julian-zatloukal/SAPLM/Documentacion/Informe escolar/Plantillas LaTeX/untitled-2.tex

\documentclass[12pt,onecolumn,a4paper]{report}

\usepackage[a4paper, inner=1.7cm, outer=2.7cm, top=2cm, bottom=2cm, bindingoffset=1.2cm] {geometry}
\usepackage[english]{babel}
\usepackage{blindtext}

\usepackage{microtype}
\usepackage{blindtext}
\usepackage{graphicx}
\usepackage{wrapfig}
\usepackage{enumitem}
\usepackage{fancyhdr}
\usepackage{amsmath}
\usepackage[T1]{fontenc}
\usepackage[utf8]{inputenc}
\usepackage{titlesec}
\setlength{\columnsep}{0.7cm}
\usepackage{sectsty}
\chapterfont{\centering}

\title{\Large{\textbf{SAMPL}}}
\author{By Zatloukal, Maule}
\date{July 22, 2019}

\begin{document}

\maketitle

\tableofcontents

\section{First section}
\subsection{A subsection}
\blindtext[1]

\appendix
\section*{Appendices}
\addcontentsline{toc}{section}{Appendices}
\renewcommand{\thesubsection}{\Alph{subsection}}

\subsection{Appendix Subsection}
\subsection{Another appendix Subsection}

\end{document}
