julian-zatloukal/SAPLM/Documentacion/Informe escolar/Plantillas LaTeX/untitled-3.tex

\documentclass[12pt,onecolumn,a4paper]{report}

\usepackage[a4paper, inner=1.7cm, outer=2.7cm, top=2cm, bottom=2cm, bindingoffset=1.2cm] {geometry}
\usepackage[english]{babel}
\usepackage{blindtext}

\usepackage{microtype}
\usepackage{blindtext}
\usepackage{graphicx}
\usepackage{wrapfig}
\usepackage{enumitem}
\usepackage{fancyhdr}
\usepackage{amsmath}
\usepackage[T1]{fontenc}
\usepackage[utf8]{inputenc}
\usepackage{titlesec}
\setlength{\columnsep}{0.7cm}
\usepackage{sectsty}
\chapterfont{\centering}

\title{\Large{\textbf{SAMPL}}}
\author{By Zatloukal, Maule}
\date{July 22, 2019}

\begin{document}

\maketitle

\tableofcontents

\chapter{Reconocimiento de voz}

\blindtext[1]
\section{Google speech recognition API}
\blindtext[5]
\section{CMU Spinhx pocket-sphinx}
\blindtext[5]
\section{Snowboy}
\blindtext[5]
\section{Basados en redes neuronales}
\blindtext[5]

\chapter{Aplicacion SAPLM}
\blindtext[1]
\section{Flujo de información}
\blindtext[5]
\section{Interfaz grafica}
\blindtext[5]

\chapter{Printed Circuit Boards}
\blindtext[1]
\section{Diseño}
\blindtext[5]
\section{Montaje}
\blindtext[5]
\section{Prueba}
\blindtext[5]

\end{document}
