julian-zatloukal/SAPLM/Documentacion/Informe ACTE/placa_PRINCIPAL_code.pdf

...cto de placa principal\Proyecto de placa principal\main.c | 1
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
#define F_CPU | 16000000UL

#include <avr/io.h>

#include <util/delay.h>

#include <avr/interrupt.h>

#include <stdlib.h>

#include <string.h>

#include <stdbool.h>

#include <stdint.h>

#include "UART_Bluetooth.h" #include "nrf24.h"

void initIO();
void initRF();
char messageTest[] = "UART TESTING COMMANDS! \n";

int main(void)
{
sei(); // Interrupts on
initBluetoothUart();
initIO();
initRF();
setupReceiveMode();
while (1)
{
while(!commandAvailable);
processReceivedLine();
setupReceiveMode();
}
}

void initIO(){
/*
Input/Output pin initialization
1 : OUTPUT | 0 : INPUT | 0b76543210 Bit order
HC-05
TX | : PD0 (RX ATMEGA) | | | INPUT
RX | : PD1 (TX ATMEGA) | | | OUTPUT
KEY/ENABLE : PD2 | | | OUTPUT
STATE | : PC5 | | | INPUT
nRF24L01
CE | : PC0 | | | OUTPUT
CSN : PC1 | | | OUTPUT
MISO : PD0 (MSPIM MISO ATMEGA) | | INPUT
MOSI : PD1 (MSPIM MOSI ATMEGA) | | OUTPUT
SCK : PD4 (MSPIM XCK) | | | OUTPUT
*/
DDRD = 0b11111110;
DDRB = 0b00101001;
DDRC = 0b11011111;

...cto de placa principal\Proyecto de placa principal\main.c | 2
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
bit_clear(PORTD, BIT(2));
}

void initRF(){
uint8_t tx_address[5] = {0xE7,0xE7,0xE7,0xE7,0xE7}; uint8_t rx_address[5] = {0xD7,0xD7,0xD7,0xD7,0xD7};

nrf24_init();

/* Channel #112 , payload length: 32 */ nrf24_config(112,32);

/* Set the device addresses */ nrf24_tx_address(tx_address); nrf24_rx_address(rx_address); }

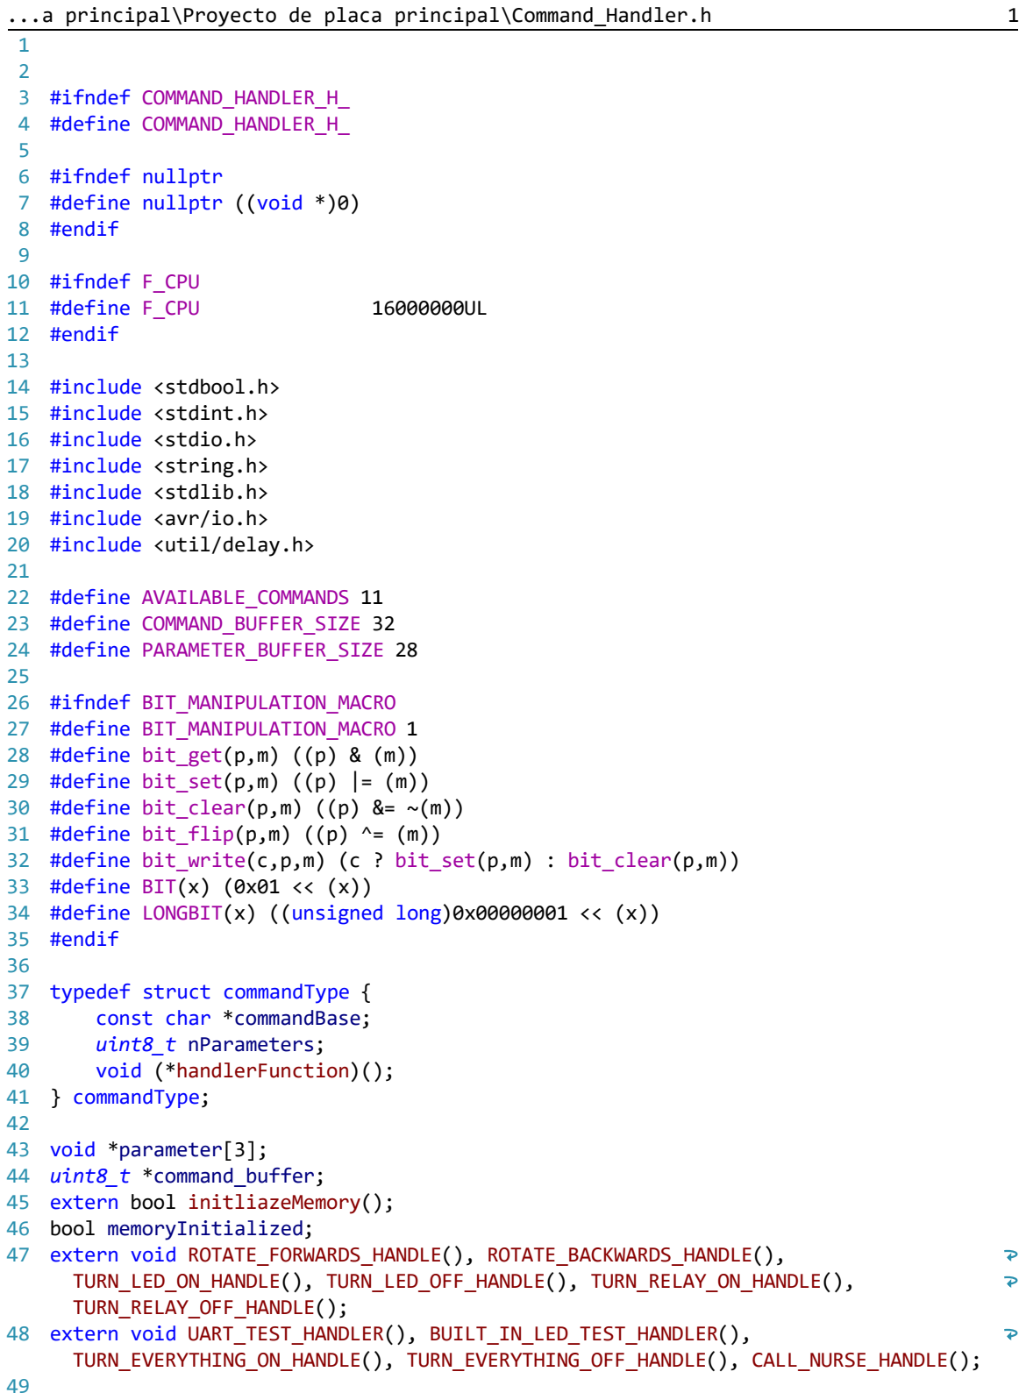
[picture p2: figure]
...a principal\Proyecto de placa principal\Command_Handler.h; #ifndef COMMAND_HANDLER_H_ #define COMMAND_HANDLER_H_; #ifndef nullptr #define nullptr ((void *)0) #endif; #ifndef F_CPU; #define F_CPU; #endif; #include <stdbool.h> #include <stdint.h> #include <stdio.h> #include <string.h> #include <stdlib.h> #include <avr/io.h> #include <util/delay.h>; #define AVAILABLE_COMMANDS 11 #define COMMAND_BUFFER_SIZE 32 #define PARAMETER_BUFFER_SIZE 28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

#define bit_write(c,p,m) (c ? bit_set(p,m) : bit_clear(p,m))

#define LONGBIT(x) ((unsigned long)0x00000001 << (x))

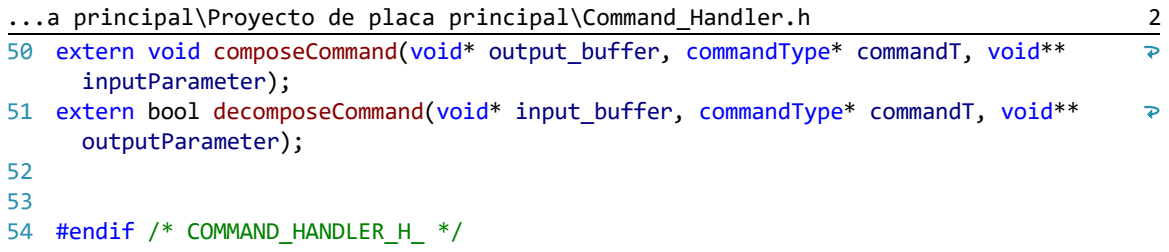
[picture p3: figure]
...a principal\Proyecto de placa principal\Command_Handler.h; inputParameter);; outputParameter);; #endif /* COMMAND_HANDLER_H_ */

extern void composeCommand(void* output_buffer, commandType* commandT, void**

extern bool decomposeCommand(void* input_buffer, commandType* commandT, void**

... principal\Proyecto de placa principal\Command_Handler..c | 1
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
#include "Command_Handler.h" #include "UART_Bluetooth.h"

#include "nrf24.h"

const commandType availableCommand[AVAILABLE_COMMANDS] = {
{ .commandBase = "ROTATE_FORWARDS", .nParameters = 3, .handlerFunction = &ROTATE_FORWARDS_HANDLE},
{ .commandBase = "ROTATE_BACKWARDS", .nParameters = 1, .handlerFunction = &ROTATE_BACKWARDS_HANDLE},
{ .commandBase = "TURN_LED_ON", .nParameters = 1, .handlerFunction = &TURN_LED_ON_HANDLE},
{ .commandBase = "TURN_LED_OFF", .nParameters = 1, .handlerFunction = &TURN_LED_OFF_HANDLE},
{ .commandBase = "TURN_RELAY_ON", .nParameters = 1, .handlerFunction = &TURN_RELAY_ON_HANDLE},
{ .commandBase = "TURN_RELAY_OFF", .nParameters = 1, .handlerFunction = &TURN_RELAY_OFF_HANDLE},
{ .commandBase = "UART_TEST", .nParameters = 0, .handlerFunction = &UART_TEST_HANDLER},
{ .commandBase = "BUILT_IN_LED_TEST", .nParameters = 0, .handlerFunction = &BUILT_IN_LED_TEST_HANDLER},
{ .commandBase = "TURN_EVERYTHING_ON", .nParameters = 0, .handlerFunction = &TURN_EVERYTHING_ON_HANDLE},
{ .commandBase = "TURN_EVERYTHING_OFF", .nParameters = 0, .handlerFunction = &TURN_EVERYTHING_OFF_HANDLE},
{ .commandBase = "CALL_NURSE", .nParameters = 0, .handlerFunction = &CALL_NURSE_HANDLE}
};

bool initliazeMemory(){
if(memoryInitialized) return false; parameter[0] = (void*)calloc(28,1); parameter[1] = (void*)calloc(28,1);
parameter[2] = (void*)calloc(28,1);
command_buffer = (uint8_t*)calloc(32,1); if(parameter[0]==nullptr||parameter[1]==nullptr||parameter[2]==nullptr|| command_buffer==nullptr) return false;
memoryInitialized = true;
return true;
}

void composeCommand(void* output_buffer, commandType* commandT, void** inputParameter){
strcpy(output_buffer, commandT->commandBase);
char* startParamPTR = (char*)(output_buffer+strlen(commandT->commandBase)); char* endParamPTR = (char*)(startParamPTR+1+strlen(*inputParameter));

for (uint8_t index = 0; index < commandT->nParameters; index++){ *startParamPTR='[';

... principal\Proyecto de placa principal\Command_Handler..c | 2
strcpy(startParamPTR+1, *inputParameter); *endParamPTR=']';
startParamPTR=(endParamPTR+1);
if (index!=(commandT->nParameters-1)){ inputParameter++;
uint8_t len = strlen(*inputParameter); endParamPTR = (char*)(startParamPTR+len+1); }
}
*startParamPTR='\0';
}

bool decomposeCommand(void* input_buffer, commandType* commandT, void** outputParameter){

for (uint8_t index = 0; index < AVAILABLE_COMMANDS; index++){
if (memmem(input_buffer, COMMAND_BUFFER_SIZE, availableCommand [index].commandBase, strlen(availableCommand[index].commandBase))! =nullptr)
{
*commandT = availableCommand[index]; break;
}
else if (index==(AVAILABLE_COMMANDS-1)) { return false;}
}

for (uint8_t x = 0; x < commandT->nParameters; x++){
uint8_t* startNumPTR = memchr(input_buffer, '[', COMMAND_BUFFER_SIZE); uint8_t* endNumPTR = memchr(input_buffer, ']', COMMAND_BUFFER_SIZE); if (startNumPTR==nullptr||endNumPTR==nullptr) { if(x==0) return false; break; }
(*startNumPTR) = 0x20;
(*endNumPTR) = 0x20;
startNumPTR++;
uint32_t bytes = ((endNumPTR)) ((startNumPTR)); if (bytes>PARAMETER_BUFFER_SIZE) return false; memcpy(outputParameter[x], startNumPTR, bytes); }

return true;
}

void ROTATE_FORWARDS_HANDLE() {}

void ROTATE_BACKWARDS_HANDLE() {}

void TURN_LED_ON_HANDLE() {}

void TURN_LED_OFF_HANDLE() {}

void TURN_RELAY_ON_HANDLE() {
composeCommand(command_buffer, &availableCommand[4], parameter);

... principal\Proyecto de placa principal\Command_Handler..c | 3
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
nrf24_send(command_buffer);
while(nrf24_isSending());

uint8_t messageStatus = nrf24_lastMessageStatus();
if(messageStatus == NRF24_TRANSMISSON_OK) { transmitMessageSync("Successful RF transmission! \n", 29); }
else if(messageStatus == NRF24_MESSAGE_LOST) { transmitMessageSync("Failure on RF transmission! \n", 29); }

uint8_t retransmissionCount = nrf24_retransmissionCount();
char* retransmissionString = malloc(32);
sprintf(retransmissionString, "Retransmission count: %d \n", retransmissionCount);
transmitMessageSync(retransmissionString, strlen(retransmissionString)); free(retransmissionString);
}

void TURN_RELAY_OFF_HANDLE() {
composeCommand(command_buffer, &availableCommand[5], parameter);

nrf24_send(command_buffer);
while(nrf24_isSending());

uint8_t messageStatus = nrf24_lastMessageStatus();
if(messageStatus == NRF24_TRANSMISSON_OK) { transmitMessageSync("Successful RF transmission! \n", 29); }
else if(messageStatus == NRF24_MESSAGE_LOST) { transmitMessageSync("Failure on RF transmission! \n", 29); }

uint8_t retransmissionCount = nrf24_retransmissionCount();
char* retransmissionString = malloc(32);
sprintf(retransmissionString, "Retransmission count: %d \n", retransmissionCount);
transmitMessageSync(retransmissionString, strlen(retransmissionString)); free(retransmissionString);
}

void UART_TEST_HANDLER() {
transmitMessageSync("Successful UART transmission!\n", 30); }

void BUILT_IN_LED_TEST_HANDLER(){
for (uint8_t x = 0; x < 8; x++) {
bit_flip(PORTD, BIT(7));
bit_flip(PORTB, BIT(0));
_delay_ms(250);
}
bit_clear(PORTD, BIT(7));
bit_clear(PORTB, BIT(0));
}

void TURN_EVERYTHING_ON_HANDLE(){

... principal\Proyecto de placa principal\Command_Handler..c | 4
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
composeCommand(command_buffer, &availableCommand[8], parameter);

nrf24_send(command_buffer);
while(nrf24_isSending());

uint8_t messageStatus = nrf24_lastMessageStatus();
if(messageStatus == NRF24_TRANSMISSON_OK) { transmitMessageSync("Successful RF transmission! \n", 29); }
else if(messageStatus == NRF24_MESSAGE_LOST) { transmitMessageSync("Failure on RF transmission! \n", 29); }

uint8_t retransmissionCount = nrf24_retransmissionCount();
char* retransmissionString = malloc(32);
sprintf(retransmissionString, "Retransmission count: %d \n", retransmissionCount);
transmitMessageSync(retransmissionString, strlen(retransmissionString)); free(retransmissionString);
}

void TURN_EVERYTHING_OFF_HANDLE(){
composeCommand(command_buffer, &availableCommand[9], parameter);

nrf24_send(command_buffer);
while(nrf24_isSending());

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

void CALL_NURSE_HANDLE(){
composeCommand(command_buffer, &availableCommand[10], parameter);

nrf24_send(command_buffer);
while(nrf24_isSending());

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

uint8_t retransmissionCount = nrf24_retransmissionCount();

... principal\Proyecto de placa principal\Command_Handler..c | 5
178
179

180
181
182
183
184

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

...to de placa principal\Proyecto de placa principal\nrf24.h | 1
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
#ifndef NRF24

#define NRF24

#include "nRF24L01_Definitions.h" #include <stdint.h>

#define LOW 0

#define HIGH 1

#define nrf24_ADDR_LEN 5

#define nrf24_CONFIG ((1<<EN_CRC)|(0<<CRCO))

#define NRF24_TRANSMISSON_OK 0

#define NRF24_MESSAGE_LOST | 1

void | nrf24_init();
void | nrf24_rx_address(uint8_t* adr);
void | nrf24_tx_address(uint8_t* adr);
void | nrf24_config(uint8_t channel, uint8_t pay_length);

uint8_t nrf24_dataReady();
uint8_t nrf24_isSending();
uint8_t nrf24_getStatus();
uint8_t nrf24_rxFifoEmpty();
void | nrf24_send(uint8_t* value);
void | nrf24_getData(uint8_t* data);

uint8_t nrf24_payloadLength();

uint8_t nrf24_lastMessageStatus(); uint8_t nrf24_retransmissionCount();

uint8_t nrf24_payload_length();

void | nrf24_powerUpRx();
void | nrf24_powerUpTx();
void | nrf24_powerDown();

uint8_t spi_transfer(uint8_t tx);
void | nrf24_transmitSync(uint8_t* dataout,uint8_t len);
void | nrf24_transferSync(uint8_t* dataout,uint8_t* datain,uint8_t len);
void | nrf24_configRegister(uint8_t reg, uint8_t value);
void | nrf24_readRegister(uint8_t reg, uint8_t* value, uint8_t len);
void | nrf24_writeRegister(uint8_t reg, uint8_t* value, uint8_t len);

extern void nrf24_setupPins();

extern void nrf24_ce_digitalWrite(uint8_t state);

extern void nrf24_csn_digitalWrite(uint8_t state);

...to de placa principal\Proyecto de placa principal\nrf24.h | 2
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
extern void nrf24_sck_digitalWrite(uint8_t state);

extern void nrf24_mosi_digitalWrite(uint8_t state);

extern uint8_t nrf24_miso_digitalRead();

#endif

...to de placa principal\Proyecto de placa principal\nrf24.c | 1

#define UCPHA0 1

#define F_CPU 8000000UL

#define BAUD_RATE 9600UL

#define UBRR_VALUE ((F_CPU)/(2UL*BAUD_RATE))-1

#include "nrf24.h"

#include <avr/io.h>

uint8_t payload_len;

void nrf24_init()
{
nrf24_setupPins();
nrf24_ce_digitalWrite(LOW); nrf24_csn_digitalWrite(HIGH);
}

void nrf24_config(uint8_t channel, uint8_t pay_length) {
/* Use static payload length ... */
payload_len = pay_length;

// Set RF channel
nrf24_configRegister(RF_CH,channel);

// Set length of incoming payload nrf24_configRegister(RX_PW_P0, 0x00); // Auto-ACK pipe ... nrf24_configRegister(RX_PW_P1, payload_len); // Data payload pipe nrf24_configRegister(RX_PW_P2, 0x00); // Pipe not used nrf24_configRegister(RX_PW_P3, 0x00); // Pipe not used nrf24_configRegister(RX_PW_P4, 0x00); // Pipe not used nrf24_configRegister(RX_PW_P5, 0x00); // Pipe not used

// 1 Mbps, TX gain: 0dbm
nrf24_configRegister(RF_SETUP, (0<<RF_DR)|((0x03)<<RF_PWR));

// CRC enable, 1 byte CRC length nrf24_configRegister(CONFIG,nrf24_CONFIG);

// Auto Acknowledgment
nrf24_configRegister(EN_AA,(1<<ENAA_P0)|(1<<ENAA_P1)|(0<<ENAA_P2)| (0<<ENAA_P3)|(0<<ENAA_P4)|(0<<ENAA_P5));

// Enable RX addresses
nrf24_configRegister(EN_RXADDR,(1<<ERX_P0)|(1<<ERX_P1)|(0<<ERX_P2)| (0<<ERX_P3)|(0<<ERX_P4)|(0<<ERX_P5));

// Auto retransmit delay: 1000 us and Up to 15 retransmit trials nrf24_configRegister(SETUP_RETR,(0x04<<ARD)|(0x0F<<ARC));

// Dynamic length configurations: No dynamic length

...to de placa principal\Proyecto de placa principal\nrf24.c | 2
nrf24_configRegister(DYNPD,(0<<DPL_P0)|(0<<DPL_P1)|(0<<DPL_P2)|(0<<DPL_P3)| (0<<DPL_P4)|(0<<DPL_P5));

// Start listening
nrf24_powerUpRx();
}

/* Set the RX address */
void nrf24_rx_address(uint8_t * adr)
{
nrf24_ce_digitalWrite(LOW); nrf24_writeRegister(RX_ADDR_P1,adr,nrf24_ADDR_LEN); nrf24_ce_digitalWrite(HIGH);
}

/* Returns the payload length */
uint8_t nrf24_payload_length() {
return payload_len;
}

/* Set the TX address */
void nrf24_tx_address(uint8_t* adr)
{
/* RX_ADDR_P0 must be set to the sending addr for auto ack to work. */ nrf24_writeRegister(RX_ADDR_P0,adr,nrf24_ADDR_LEN); nrf24_writeRegister(TX_ADDR,adr,nrf24_ADDR_LEN);
}

/* Checks if data is available for reading */
/* Returns 1 if data is ready ... */
uint8_t nrf24_dataReady()
{
// See note in getData() function just checking RX_DR isn't good enough uint8_t status = nrf24_getStatus();

// We can short circuit on RX_DR, but if it's not set, we still need
// to check the FIFO for any pending packets
if ( status & (1 << RX_DR) )
{
return 1;
}

return !nrf24_rxFifoEmpty();;
}

/* Checks if receive FIFO is empty or not */ uint8_t nrf24_rxFifoEmpty()
{
uint8_t fifoStatus;

nrf24_readRegister(FIFO_STATUS,&fifoStatus,1);

...to de placa principal\Proyecto de placa principal\nrf24.c | 3

return (fifoStatus & (1 << RX_EMPTY));
}

/* Returns the length of data waiting in the RX fifo */ uint8_t nrf24_payloadLength()
{
uint8_t status;
nrf24_csn_digitalWrite(LOW); spi_transfer(R_RX_PL_WID); status = spi_transfer(0x00); nrf24_csn_digitalWrite(HIGH);
return status;
}

/* Reads payload bytes into data array */ void nrf24_getData(uint8_t* data)
{
/* Pull down chip select */ nrf24_csn_digitalWrite(LOW);

/* Send cmd to read rx payload */ spi_transfer( R_RX_PAYLOAD );

/* Read payload */
nrf24_transferSync(data,data,payload_len);

/* Pull up chip select */
nrf24_csn_digitalWrite(HIGH);

/* Reset status register */ nrf24_configRegister(STATUS,(1<<RX_DR));
}

/* Returns the number of retransmissions occured for the last message */ uint8_t nrf24_retransmissionCount()
{
uint8_t rv;
nrf24_readRegister(OBSERVE_TX,&rv,1); rv = rv & 0x0F;
return rv;
}

// Sends a data package to the default address. Be sure to send the correct // amount of bytes as configured as payload on the receiver.
void nrf24_send(uint8_t* value)
{
/* Go to Standby-I first */ nrf24_ce_digitalWrite(LOW);

/* Set to transmitter mode , Power up if needed */ nrf24_powerUpTx();

...to de placa principal\Proyecto de placa principal\nrf24.c | 4

/* Do we really need to flush TX fifo each time ? */ #if 1
/* Pull down chip select */ nrf24_csn_digitalWrite(LOW);

/* Write cmd to flush transmit FIFO */ spi_transfer(FLUSH_TX);

/* Pull up chip select */
nrf24_csn_digitalWrite(HIGH);
#endif

/* Pull down chip select */ nrf24_csn_digitalWrite(LOW);

/* Write cmd to write payload */ spi_transfer(W_TX_PAYLOAD);

/* Write payload */
nrf24_transmitSync(value,payload_len);

/* Pull up chip select */
nrf24_csn_digitalWrite(HIGH);

/* Start the transmission */ nrf24_ce_digitalWrite(HIGH); }

uint8_t nrf24_isSending()
{
uint8_t status;

/* read the current status */
status = nrf24_getStatus();

/* if sending successful (TX_DS) or max retries exceded (MAX_RT). */
if((status & ((1 << TX_DS) | (1 << MAX_RT))))
{
return 0; /* false */
}

return 1; /* true */

}

uint8_t nrf24_getStatus()
{
uint8_t rv;
nrf24_csn_digitalWrite(LOW); rv = spi_transfer(NOP);
nrf24_csn_digitalWrite(HIGH);

...to de placa principal\Proyecto de placa principal\nrf24.c | 5
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
return rv;
}

uint8_t nrf24_lastMessageStatus() {
uint8_t rv;

rv = nrf24_getStatus();

/* Transmission went OK */ if((rv & ((1 << TX_DS))))
{
return NRF24_TRANSMISSON_OK;
}
/* Maximum retransmission count is reached */ /* Last message probably went missing ... */ else if((rv & ((1 << MAX_RT))))
{
return NRF24_MESSAGE_LOST;
}
/* Probably still sending ... */ else
{
return 0xFF;
}
}

void nrf24_powerUpRx()
{
nrf24_csn_digitalWrite(LOW);
spi_transfer(FLUSH_RX);
nrf24_csn_digitalWrite(HIGH);

nrf24_configRegister(STATUS,(1<<RX_DR)|(1<<TX_DS)|(1<<MAX_RT));

nrf24_ce_digitalWrite(LOW); nrf24_configRegister(CONFIG,nrf24_CONFIG|((1<<PWR_UP)|(1<<PRIM_RX))); nrf24_ce_digitalWrite(HIGH);
}

void nrf24_powerUpTx()
{
nrf24_configRegister(STATUS,(1<<RX_DR)|(1<<TX_DS)|(1<<MAX_RT));

nrf24_configRegister(CONFIG,nrf24_CONFIG|((1<<PWR_UP)|(0<<PRIM_RX))); }

void nrf24_powerDown()
{
nrf24_ce_digitalWrite(LOW); nrf24_configRegister(CONFIG,nrf24_CONFIG); }

...to de placa principal\Proyecto de placa principal\nrf24.c | 6

uint8_t spi_transfer(uint8_t tx)
{
uint8_t i = 0;
uint8_t rx = 0;

nrf24_sck_digitalWrite(LOW);

for(i=0;i<8;i++)
{

if(tx & (1<<(7-i)))
{
nrf24_mosi_digitalWrite(HIGH); }
else
{
nrf24_mosi_digitalWrite(LOW); }

nrf24_sck_digitalWrite(HIGH);

rx = rx << 1;
if(nrf24_miso_digitalRead()) {
rx |= 0x01;
}

nrf24_sck_digitalWrite(LOW);

}

return rx;
}

/* send and receive multiple bytes over SPI */
void nrf24_transferSync(uint8_t* dataout,uint8_t* datain,uint8_t len) {
uint8_t i;

for(i=0;i<len;i++)
{
datain[i] = spi_transfer(dataout[i]); }

}

/* send multiple bytes over SPI */
void nrf24_transmitSync(uint8_t* dataout,uint8_t len) {
uint8_t i;

...to de placa principal\Proyecto de placa principal\nrf24.c | 7
for(i=0;i<len;i++)
{
spi_transfer(dataout[i]);
}

}

/* Clocks only one byte into the given nrf24 register */ void nrf24_configRegister(uint8_t reg, uint8_t value)
{
nrf24_csn_digitalWrite(LOW);
spi_transfer(W_REGISTER | (REGISTER_MASK & reg));
spi_transfer(value);
nrf24_csn_digitalWrite(HIGH);
}

/* Read single register from nrf24 */
void nrf24_readRegister(uint8_t reg, uint8_t* value, uint8_t len) {
nrf24_csn_digitalWrite(LOW);
spi_transfer(R_REGISTER | (REGISTER_MASK & reg));
nrf24_transferSync(value,value,len); nrf24_csn_digitalWrite(HIGH);
}

/* Write to a single register of nrf24 */
void nrf24_writeRegister(uint8_t reg, uint8_t* value, uint8_t len) {
nrf24_csn_digitalWrite(LOW);
spi_transfer(W_REGISTER | (REGISTER_MASK & reg));
nrf24_transmitSync(value,len); nrf24_csn_digitalWrite(HIGH);
}

#define RF_DDR DDRC

#define RF_PORT PORTC

#define RF_PIN PINC

#define set_bit(reg,bit) reg |= (1<<bit)

#define clr_bit(reg,bit) reg &= ~(1<<bit)

#define check_bit(reg,bit) (reg&(1<<bit))

/* */

void nrf24_setupPins()
{
set_bit(RF_DDR,0); // CE output
set_bit(RF_DDR,1); // CSN output set_bit(RF_DDR,2); // SCK output set_bit(RF_DDR,3); // MOSI output clr_bit(RF_DDR,4); // MISO input }

...to de placa principal\Proyecto de placa principal\nrf24.c | 8
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
/* */ void nrf24_ce_digitalWrite(uint8_t state)
{
if(state)
{
set_bit(RF_PORT,0);
}
else
{
clr_bit(RF_PORT,0);
}
}
/* */ void nrf24_csn_digitalWrite(uint8_t state)
{
if(state)
{
set_bit(RF_PORT,1);
}
else
{
clr_bit(RF_PORT,1);
}
}
/* */ void nrf24_sck_digitalWrite(uint8_t state)
{
if(state)
{
set_bit(RF_PORT,2);
}
else
{
clr_bit(RF_PORT,2);
}
}
/* */ void nrf24_mosi_digitalWrite(uint8_t state)
{
if(state)
{
set_bit(RF_PORT,3);
}
else
{
clr_bit(RF_PORT,3);
}
}
/* */ uint8_t nrf24_miso_digitalRead()
{
return check_bit(RF_PIN,4);

...to de placa principal\Proyecto de placa principal\nrf24.c | 9
414
415
416

}
/* */

...ca principal\Proyecto de placa principal\UART_Bluetooth.h | 1
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
#ifndef UART_BLUETOOTH_H_

#define UART_BLUETOOTH_H_

#include <stdbool.h>

#include <stdint.h>

#ifndef F_CPU

#define F_CPU | 16000000UL

#endif

#ifndef BAUD

#define BAUD | 9600

#endif

#ifndef BRC

#define BRC | F_CPU/8/BAUD-1

#endif

#ifndef nullptr

#define nullptr | nullptr ((void*)0)

#endif

#define uartBufferSize | 32

#define uartEndMsgChar | '$'

#define uartCarriageReturnChar '/'

#ifndef BIT_MANIPULATION_MACRO #define BIT_MANIPULATION_MACRO 1 #define bit_get(p,m) ((p) & (m)) #define bit_set(p,m) ((p) |= (m))

#define bit_clear(p,m) ((p) &= ~(m))

#define bit_flip(p,m) ((p) ^= (m))

#define bit_write(c,p,m) (c ? bit_set(p,m) : bit_clear(p,m)) #define BIT(x) (0x01 << (x))

#define LONGBIT(x) ((unsigned long)0x00000001 << (x)) #endif

extern bool commandAvailable;

extern void initBluetoothUart();
extern void transmitMessage(uint8_t* message, uint8_t length); extern void transmitMessageSync(uint8_t* message, uint8_t length); extern bool transmissionState();
extern void setupReceiveMode();
extern void processReceivedLine();
extern void disableUART();

...ca principal\Proyecto de placa principal\UART_Bluetooth.h | 2
53
54 #endif /* UART_BLUETOOTH_H_ */

...ca principal\Proyecto de placa principal\UART_Bluetooth.c | 1

#include "UART_Bluetooth.h"

#include <avr/io.h>

#include <avr/interrupt.h> #include "Command_Handler.h" #include <stdlib.h>

#include <string.h>

uint8_t* uartBufferPos;
uint8_t* uartTxMessageEnd;
bool commandAvailable;

void initBluetoothUart(){
// UART Initialization : 8-bit : No parity bit : 1 stop bit
UBRR0H = (BRC >> 8); UBRR0L = BRC; | // UART BAUDRATE
UCSR0A |= (1 << U2X0); | // DOUBLE UART SPEED
UCSR0C |= (1 << UCSZ01) | (1 << UCSZ00); | // 8-BIT CHARACTER SIZE

// Setup UART buffer
initliazeMemory();
uartBufferPos = command_buffer;
}

void transmitMessage(uint8_t* message, uint8_t length){ while (!(UCSR0A & (1<<UDRE0)));
uartBufferPos = command_buffer;
uartTxMessageEnd = (command_buffer+length); memcpy(command_buffer, message, length);
UCSR0A |= (1<<TXC0) | (1<<RXC0);
UCSR0B |= (1<<TXEN0) | (1<<TXCIE0);
UCSR0B &=~(1<<RXEN0) &~(1<<RXCIE0);

uartBufferPos++;
UDR0 = *(command_buffer);
}

void transmitMessageSync(uint8_t* message, uint8_t length){ while (!(UCSR0A & (1<<UDRE0)));
uartBufferPos = command_buffer;
uartTxMessageEnd = (command_buffer+length); memcpy(command_buffer, message, length);
UCSR0A |= (1<<TXC0) | (1<<RXC0);
UCSR0B |= (1<<TXEN0) | (1<<TXCIE0);
UCSR0B &=~(1<<RXEN0) &~(1<<RXCIE0);

uartBufferPos++;
UDR0 = *(command_buffer);

while (transmissionState());

}

...ca principal\Proyecto de placa principal\UART_Bluetooth.c | 2
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
bool transmissionState(){
// True : Currently transmitting | False : Transmission finished
if (uartBufferPos!=uartTxMessageEnd)
{
return true;
}
else
{
return false;
}
}

void setupReceiveMode(){
while (!(UCSR0A & (1<<UDRE0))); uartBufferPos = command_buffer;
UCSR0A |= (1<<RXC0) | (1<<TXC0);
UCSR0B &=~(1<<TXEN0) &~(1<<TXCIE0);
UCSR0B |= (1<<RXEN0) | (1<<RXCIE0);
}

void processReceivedLine(){
commandAvailable = false;

commandType currentCommand;
bool success = decomposeCommand(command_buffer, &currentCommand, parameter); if(success) currentCommand.handlerFunction();
}

void disableUART(){
UCSR0B &=~(1<<TXEN0) &~(1<<TXCIE0);
UCSR0B &=~(1<<RXEN0) &~(1<<RXCIE0); }

ISR(USART_TX_vect){
if (uartBufferPos!=uartTxMessageEnd){ UDR0 = *uartBufferPos;
uartBufferPos++;
}
}

ISR(USART_RX_vect){
if(uartBufferPos!=(command_buffer+uartBufferSize)) { *uartBufferPos=UDR0;
if (*uartBufferPos!=uartEndMsgChar) { if(*uartBufferPos!=uartCarriageReturnChar) {uartBufferPos++;} else { uartBufferPos = command_buffer; }
}
else { disableUART(); commandAvailable = true; }
} else {uartBufferPos = command_buffer;}

...ca principal\Proyecto de placa principal\UART_Bluetooth.c | 3
104 | }
