julian-zatloukal/SAPLM/Documentacion/Informe ACTE/NUEVO CODIGO/CARATULAS.pdf

Codigo de fuente: Aplicación, todas las clases internas
Lenguaje: JAVA 8 SE
IDE: Android Studio

Codigo de fuente: Aplicación, diseño de layout
Lenguaje: XML
IDE: Android Studio

PLACA PRINCIPAL
> Esquematico
> Board

PLACA DE POTENCIA
> Esquematico
> Board

PLACA MOTRIZ
> Esquematico
> Board
