julian-zatloukal/SAPLM/Documentacion/Informe ACTE/NUEVO CODIGO/POTENCIA.pdf

PLACA DE POTENCIA
> Esquematico
> Board
