julian-zatloukal/SAPLM/Proyecto atmel studio/Notas/NEW_COMMAND_PROTOCOL.txt

	GET_BOARD_STATE[BOARD_ID]
	SET_COMMAND_VALUE[CMD_ID][VALUE]
	GET_COMMAND_VALUE[CMD_ID]

	UPDATE_COMMAND_VALUE[CMD_ID][VALUE]

	START OF TRANSMISSION BLOCK	:	0x01

	COMMAND CODE			:	0x??

	GROUP SEPARATOR			:	0x1D

	PARAMETER 0			:	0x??

	GROUP SEPARATOR			:	0x1D

	PARAMETER 1			:	0x??

	GROUP SEPARATOR			:	0x1D
	
	END OF TEXT			:	0x02

	CRC-8 CHECKSUM BYTE		:	0x??

	END OF TRANSMISSION BLOCK	:	0x17
