julian-zatloukal/SAPLM/Documentacion/Informe ACTE/DIAGRAMA_DE_BLOQUES.pdf

# Diagrama de bloques

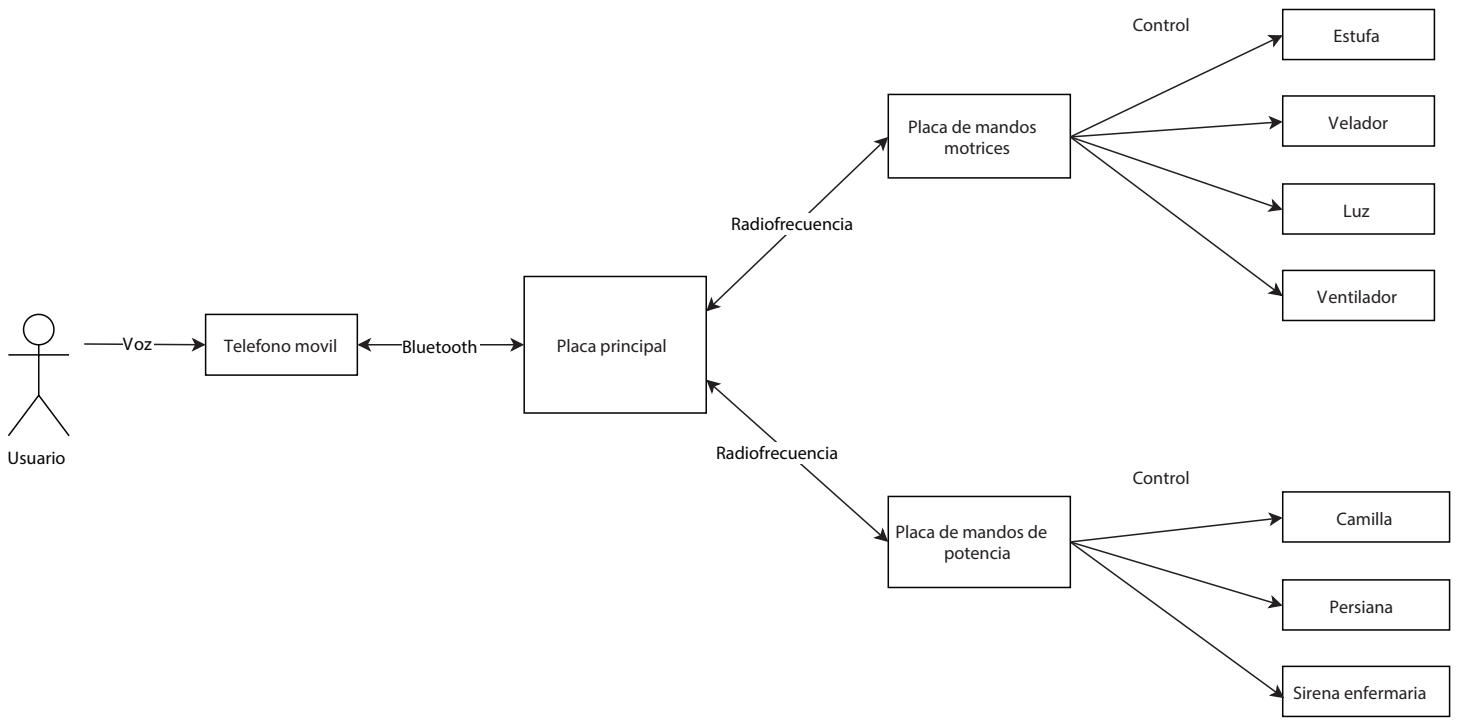
[picture p11: figure]
Usuario; Voz; Telefono movil; Bluetooth; Placa principal; Placa de mandos motrices; Placa de mandos de potencia; Estufa; Velador; Luz; Ventilador; Camilla; Persiana; Sirena enfermaria; Radiofrecuencia; Control
