julian-zatloukal/SAPLM/Documentacion/Informe ACTE/DIAGRAMA_DE_FLUJO.pdf

# Diagrama de flujo para encender una estufa

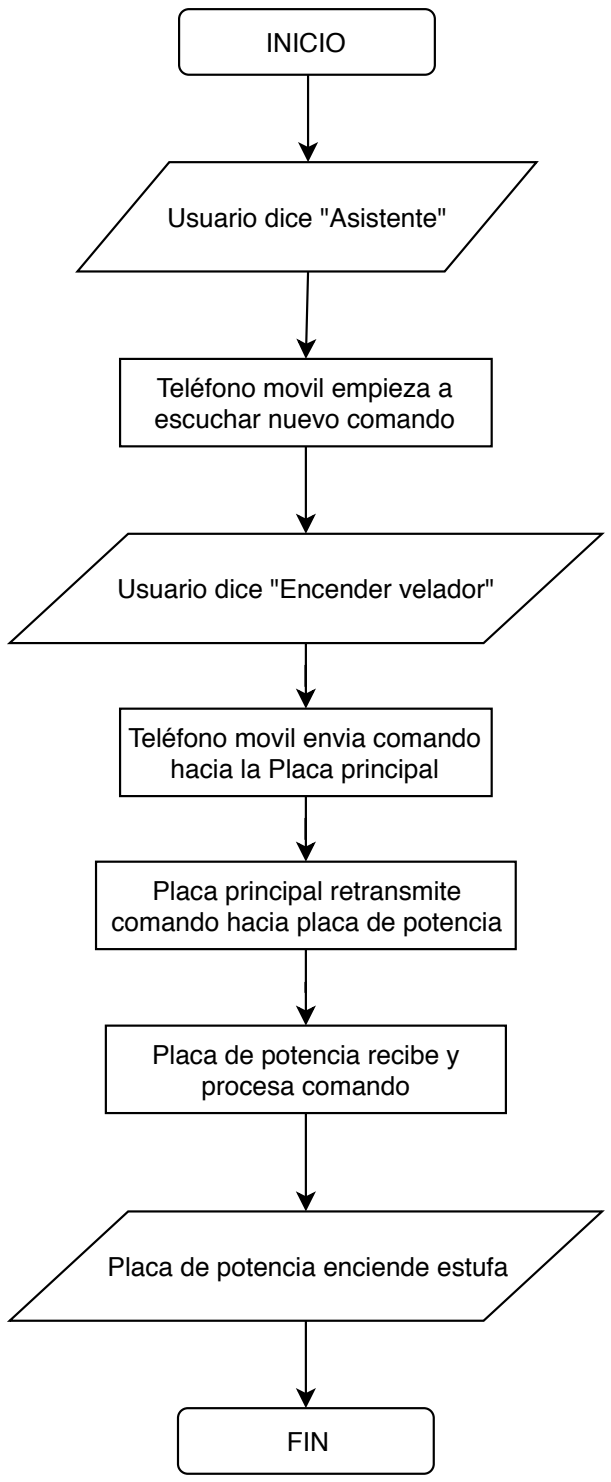
[picture p12: figure]
INICIO; Usuario dice "Asistente"; Teléfono movil empieza a escuchar nuevo comando; Usuario dice "Encender velador"; Teléfono movil envia comando hacia la Placa principal; Placa principal retransmite comando hacia placa de potencia; Placa de potencia recibe y procesa comando; Placa de potencia enciende estufa; FIN
