julian-zatloukal/SAPLM/Documentacion/Informe ACTE/paginas extra.pdf

- Palabra clave : Asistente Comandos disponibles

Encender estufa
Encender velador
Encender ventilador

Apagar estufa
Apagar velador
Apagar ventilador
Llamar enfermería

Comandos por voz

Escuchando
comando

Escucha
deshabilitada

Escuchando
palabra clave

Estados de escucha

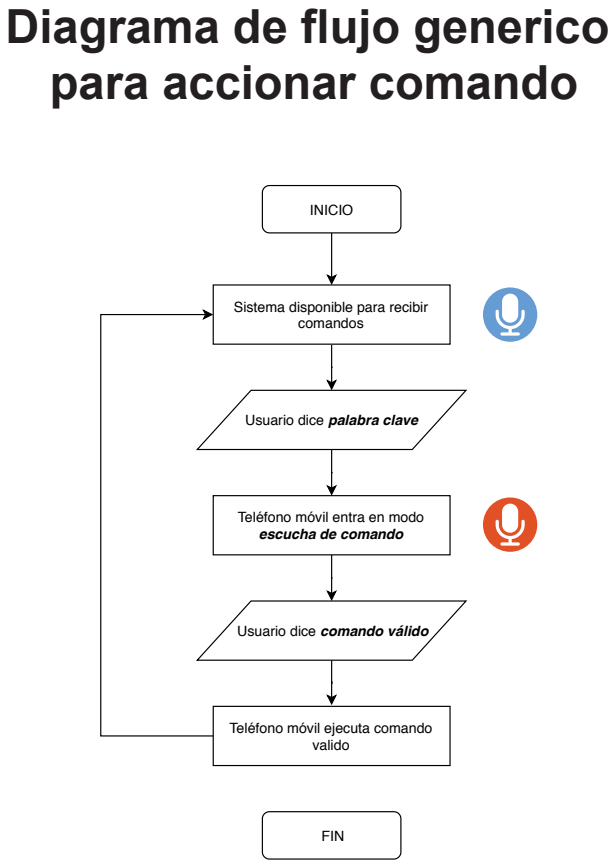
[picture p13: page 2]
INICIO; valido; FIN

Diagrama de flujo generico
para accionar comando

Sistema disponible para recibir
comandos

Usuario dice palabra clave

Teléfono móvil entra en modo
escucha de comando

Usuario dice comando válido

Teléfono móvil ejecuta comando

Interfaz gráfica de la aplicacion

- Pantalla principal

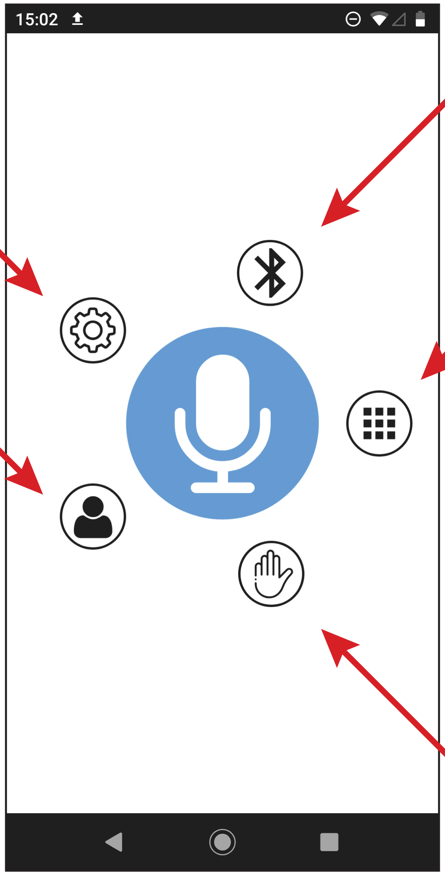
[picture p14: figure]

Menu de Bluetooth

Desplegar menu
principal

Menu de mandos

Menu de contactos

Menu de
configuraciones

Interfaz gráfica de la aplicacion

- Menu de configuraciones

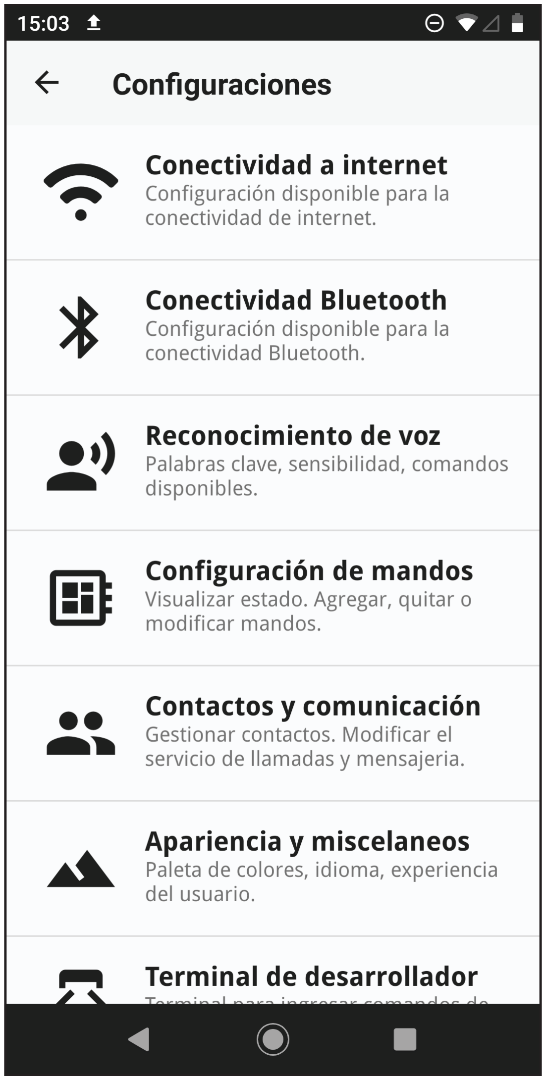
[picture p15: figure]

Interfaz gráfica de la aplicacion

- Menu de Bluetooth

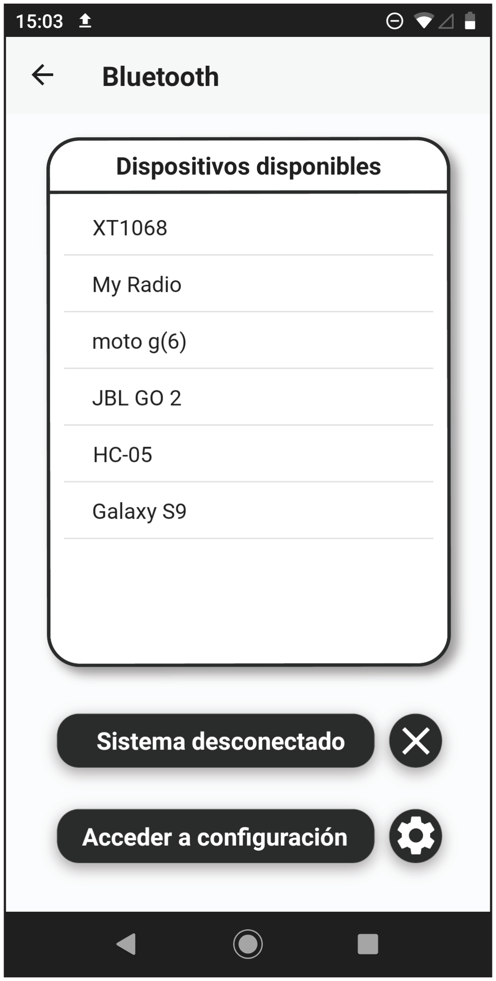
[picture p16: figure]
