julian-zatloukal/SAPLM/Documentacion/Informe ACTE/NUEVO CODIGO/JAVA.pdf

Codigo de fuente: Aplicación, todas las clases internas
Lenguaje: JAVA 8 SE
IDE: Android Studio
