julian-zatloukal/SAPLM/Documentacion/Informe ACTE/NUEVO CODIGO/XML.pdf

Codigo de fuente: Aplicación, diseño de layout
Lenguaje: XML
IDE: Android Studio
