julian-zatloukal/SAPLM/Documentacion/Informe escolar/LATEX COMPILE/APP_IMAGES.pdf

Interfaz gráfica de la aplicacion

- Pantalla principal

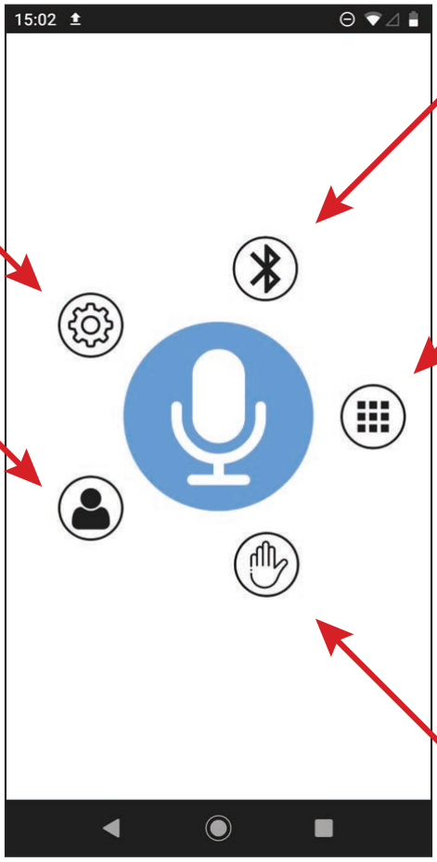
[picture p17: figure]

Menu de Bluetooth

Desplegar menu
principal

Menu de mandos

Menu de contactos

Menu de
configuraciones

Interfaz gráfica de la aplicacion

- Menu de configuraciones

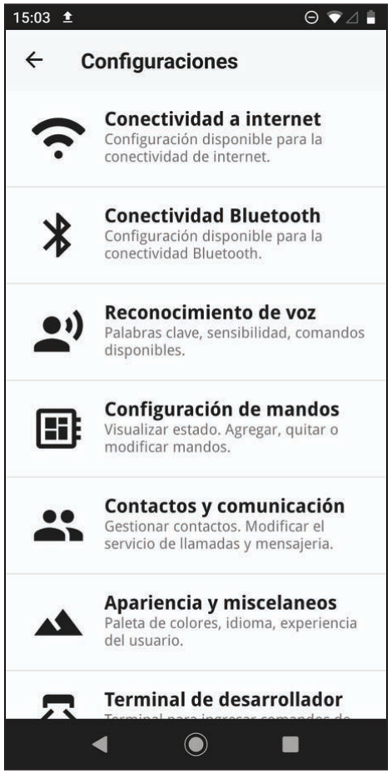
[picture p18: figure]

Interfaz gráfica de la aplicacion

- Menu de Bluetooth

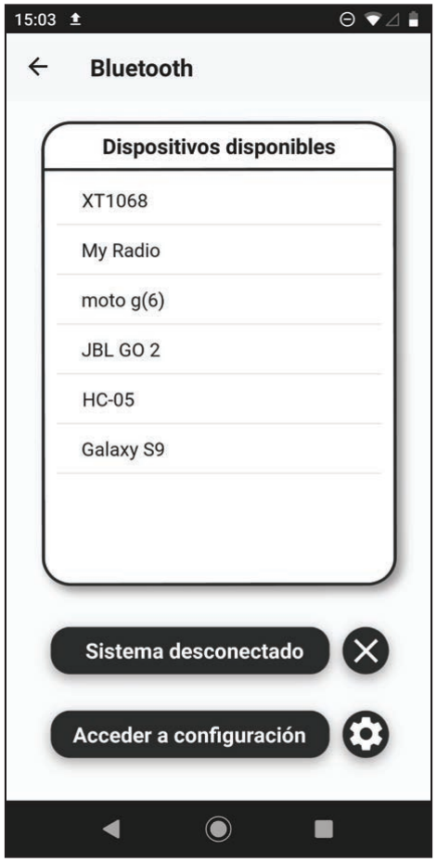
[picture p19: figure]
