julian-zatloukal/SAPLM/Documentacion/Informe escolar/Plantillas LaTeX/untitled-2.pdf

## SAMPL

### By Zatloukal, Maule

### July 22, 2019

# Contents

1 | First section | | 1
1.1 | A subsection | | 1
Appendices | | 1
A | Appendix Subsection | | 1
B | Another appendix Subsection | | 1

## 0.1 First section

### 0.1.1 A subsection

Hello, here is some text without a meaning. This text should show what a printed text will look like at this place. If you read this text, you will get no information. Really? Is there no information? Is there a difference between this text and some nonsense like “Huardest gefburn”? Kjift – not at all! A blind text like this gives you information about the selected font, how the letters are written and an impression of the look. This text should contain all letters of the alphabet and it should be written in of the original language. There is no need for special content, but the length of words should match the language.

## Appendices

### B Appendix Subsection

### C Another appendix Subsection

1
