julian-zatloukal/SAPLM/Documentacion/Informe escolar/Plantillas LaTeX/untitled-3.pdf

## SAMPL

### By Zatloukal, Maule

### July 22, 2019

# Contents

# Chapter 1

# Reconocimiento de voz

Hello, here is some text without a meaning. This text should show what a printed text will look like at this place. If you read this text, you will get no information. Really? Is there no information? Is there a difference between this text and some nonsense like “Huardest gefburn”? Kjift – not at all! A blind text like this gives you information about the selected font, how the letters are written and an impression of the look. This text should contain all letters of the alphabet and it should be written in of the original language. There is no need for special content, but the length of words should match the language.

## 1.1 Google speech recognition API

Hello, here is some text without a meaning. This text should show what a printed text will look like at this place. If you read this text, you will get no information. Really? Is there no information? Is there a difference between this text and some nonsense like “Huardest gefburn”? Kjift – not at a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

## 1.2 CMU Spinhx pocket-sphinx

Hello, here is some text without a meaning. This text should show what a printed text will look like at this place. If you read this text, you will get no information. Really? Is there no information? Is there a difference between this text and some nonsense like “Huardest gefburn”? Kjift – not at a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

## 1.3 Snowboy

Hello, here is some text without a meaning. This text should show what a printed text will look like at this place. If you read this text, you will get no information. Really? Is there no information? Is there a difference between this text and some nonsense like “Huardest gefburn”? Kjift – not at a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

## 1.4 Basados en redes neuronales

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

# Chapter 2

# Aplicacion SAPLM

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

## 2.1 Flujo de información

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

## 2.2 Interfaz grafica

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

# Chapter 3

# Printed Circuit Boards

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

## 3.1 Diseño

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

## 3.2 Montaje

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

## 3.3 Prueba

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
