julian-zatloukal/SAPLM/Documentacion/Informe ACTE/FF.jpeg

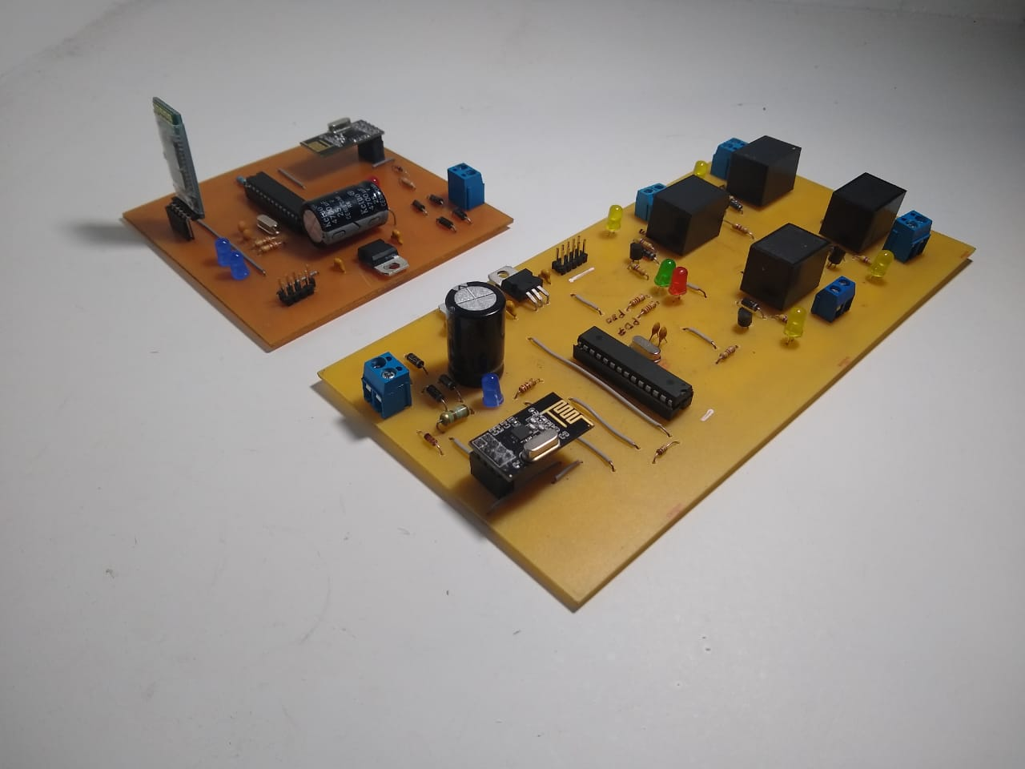
Documentacion/Informe ACTE/FF.jpeg
