julian-zatloukal/SAPLM/Documentacion/Informe ACTE/fotos app/WhatsApp Image 2019-07-04 at 15.03.50 (2).jpeg

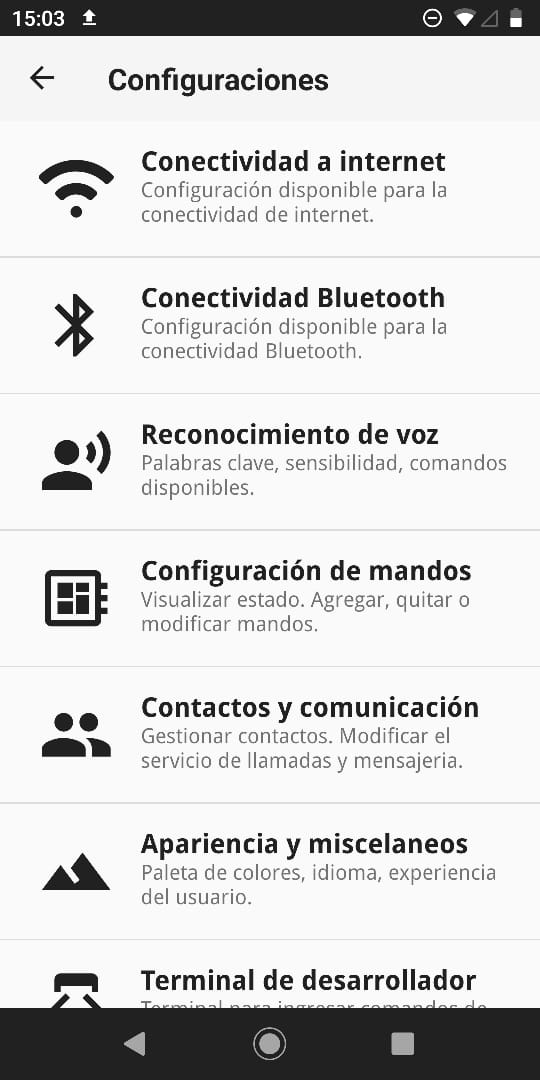
Documentacion/Informe ACTE/fotos app/WhatsApp Image 2019-07-04 at 15.03.50 (2).jpeg
