julian-zatloukal/SAPLM/Documentacion/Informe ACTE/imagen_final_2.jpg

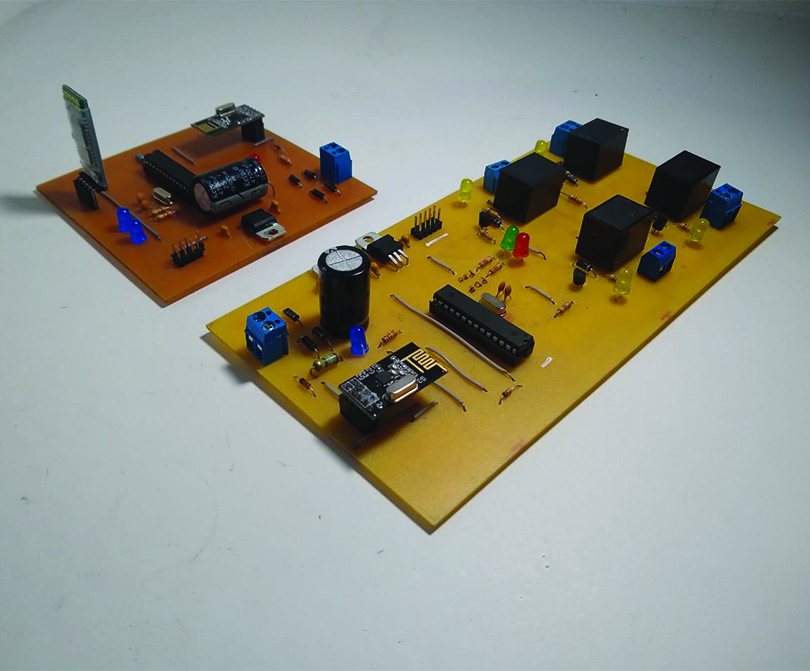
Documentacion/Informe ACTE/imagen_final_2.jpg
