julian-zatloukal/SAPLM/Proyecto atmel studio/Material/Cuadros y diagramas/Comparacion en diagramas en bloque-01.png

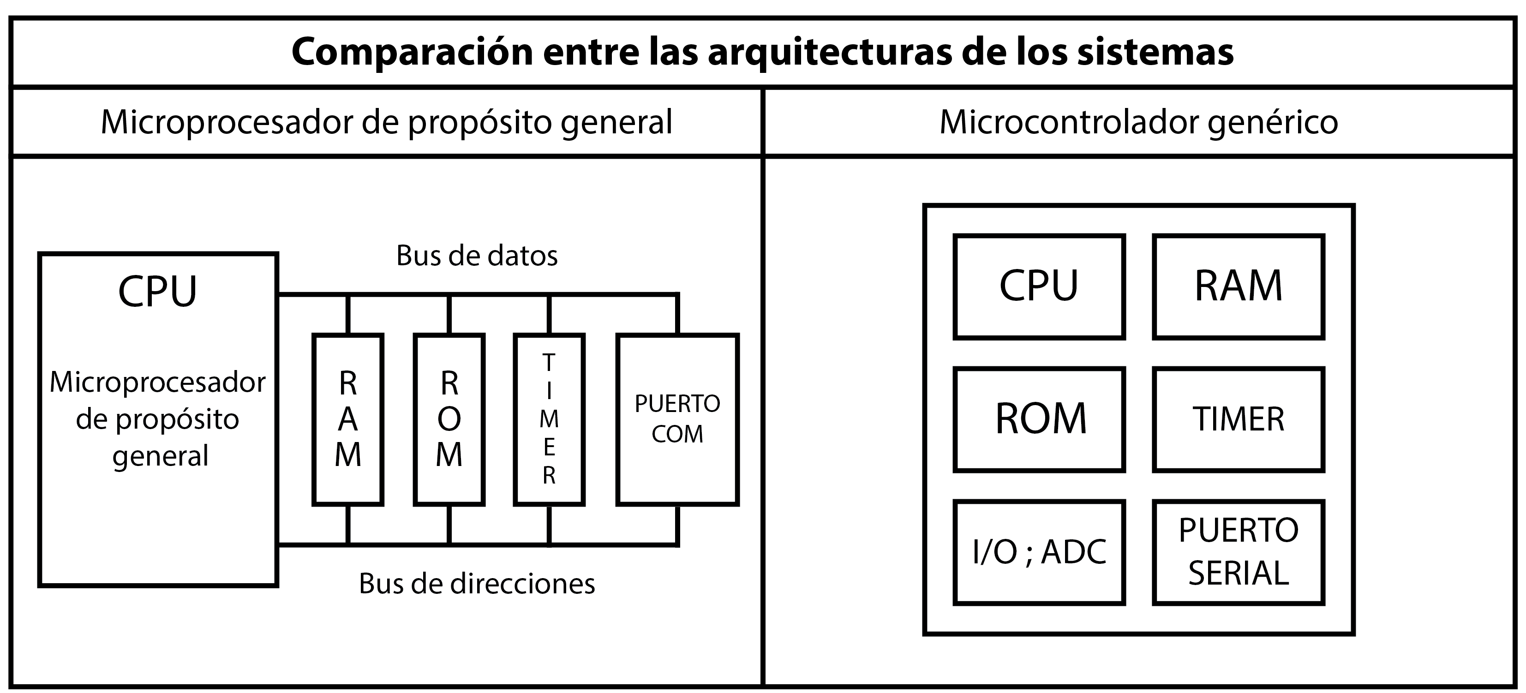
Proyecto atmel studio/Material/Cuadros y diagramas/Comparacion en diagramas en bloque-01.png
