julian-zatloukal/SAPLM/Proyecto atmel studio/Material/Cuadros y diagramas/Ejemplo de entorno de desarrollo.png

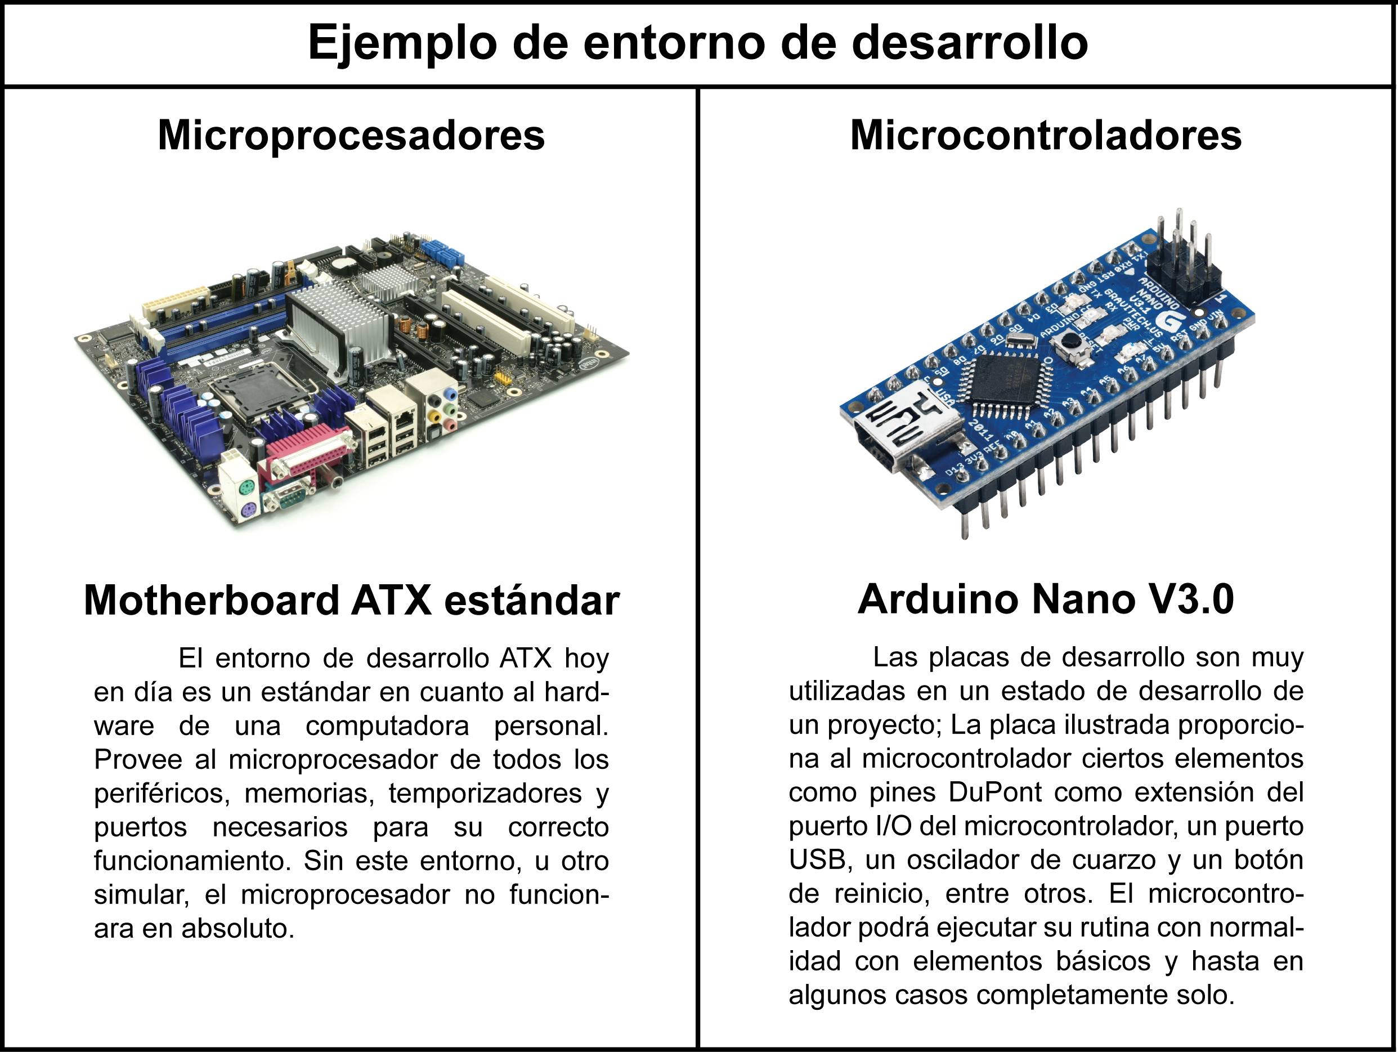
Proyecto atmel studio/Material/Cuadros y diagramas/Ejemplo de entorno de desarrollo.png
