julian-zatloukal/SAPLM/Proyecto atmel studio/Material/Cuadros y diagramas/Ejemplos de sistemas embebidos 2.png

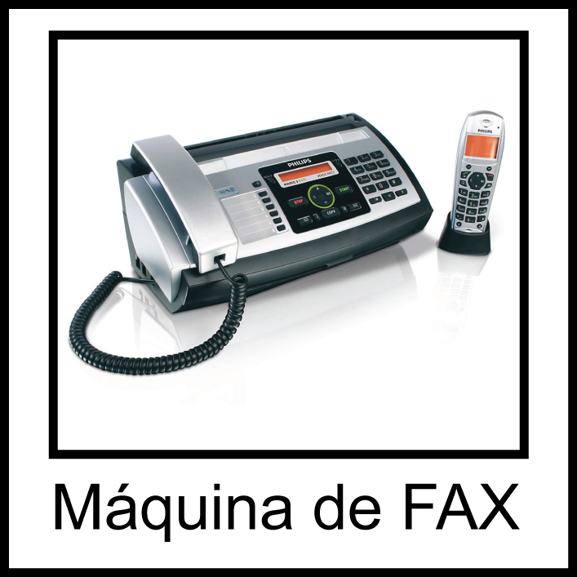
Proyecto atmel studio/Material/Cuadros y diagramas/Ejemplos de sistemas embebidos 2.png
