julian-zatloukal/SAPLM/Proyecto atmel studio/Material/Cuadros y diagramas/Ejemplos de sistemas embebidos 3.png

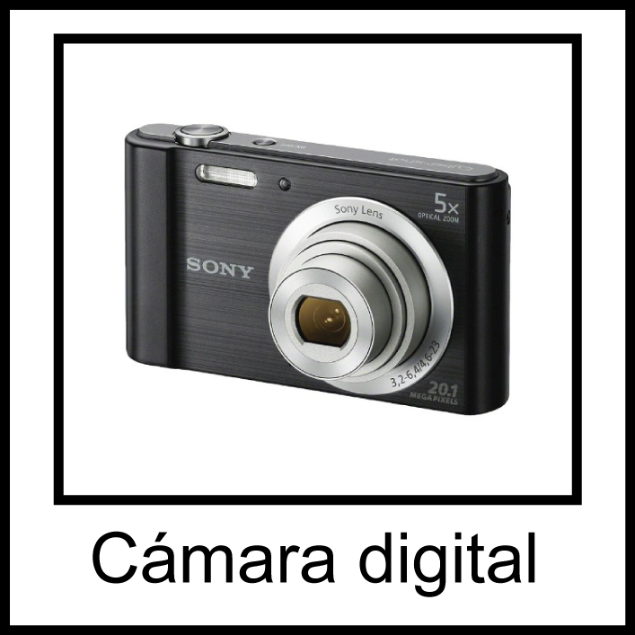
Proyecto atmel studio/Material/Cuadros y diagramas/Ejemplos de sistemas embebidos 3.png
