julian-zatloukal/SAPLM/Proyecto atmel studio/Material/Cuadros y diagramas/Ejemplos de sistemas embebidos 4.png

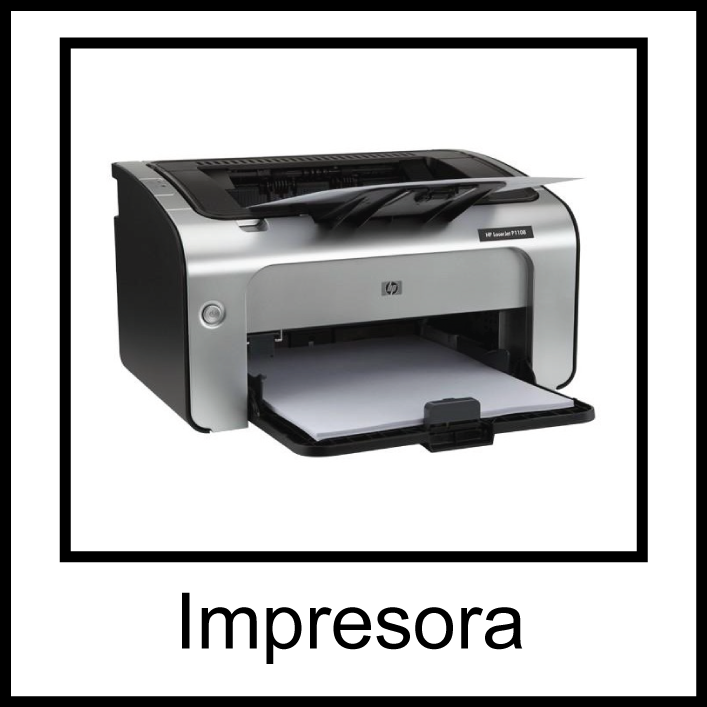
Proyecto atmel studio/Material/Cuadros y diagramas/Ejemplos de sistemas embebidos 4.png
