julian-zatloukal/SAPLM/Proyecto atmel studio/Material/Cuadros y diagramas/Ejemplos de sistemas embebidos.png

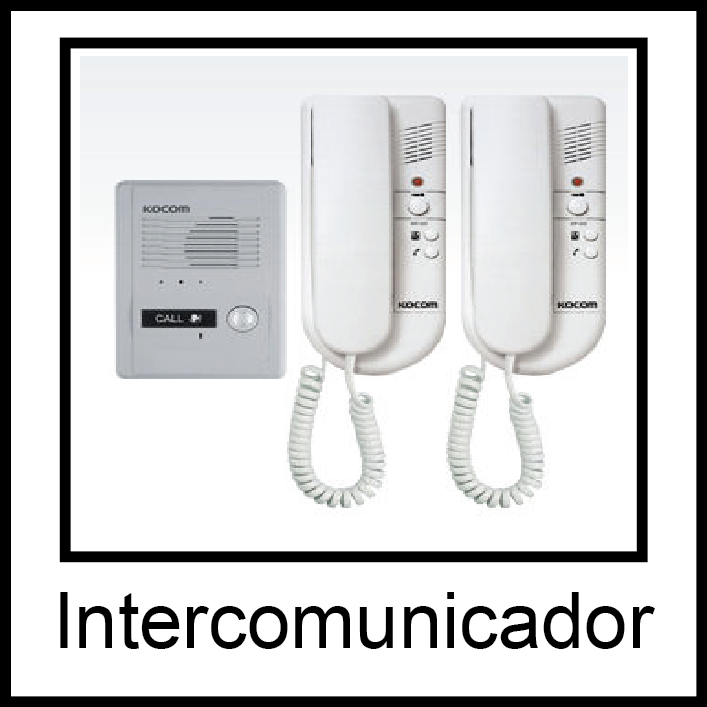
Proyecto atmel studio/Material/Cuadros y diagramas/Ejemplos de sistemas embebidos.png
