julian-zatloukal/SAPLM/Proyecto atmel studio/Material/Fotos/296.jpg

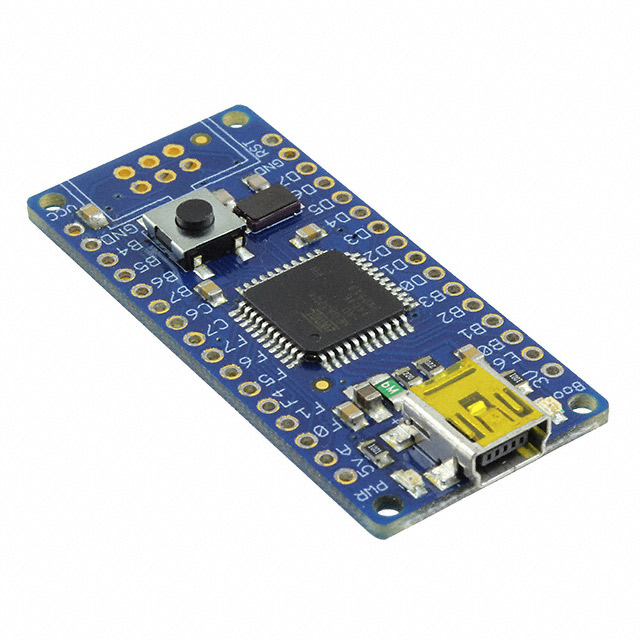
Proyecto atmel studio/Material/Fotos/296.jpg
