julian-zatloukal/SAPLM/Proyecto atmel studio/Material/Fotos/125973.jpg

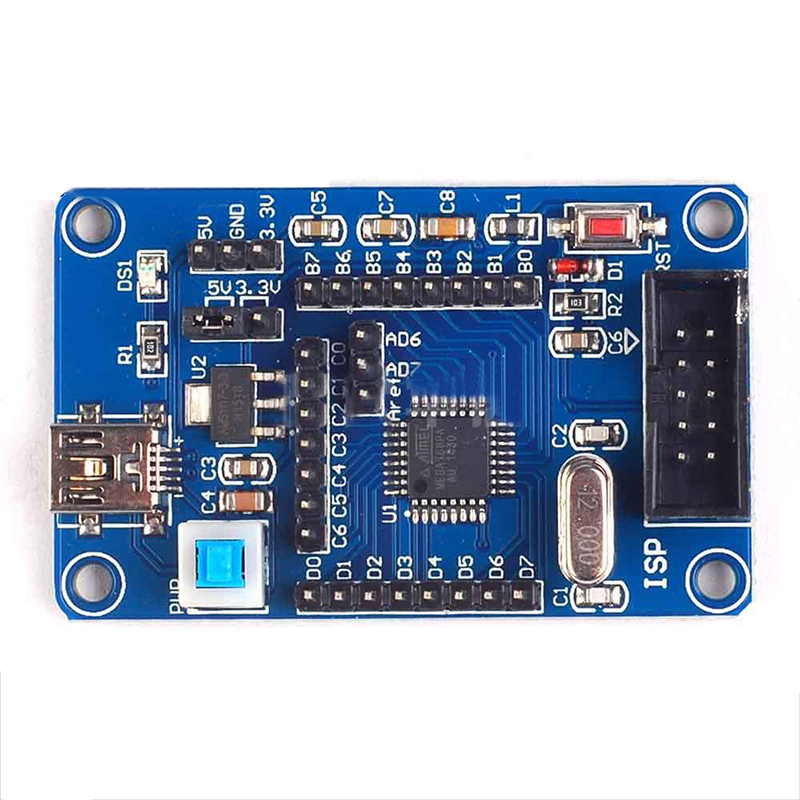
Proyecto atmel studio/Material/Fotos/125973.jpg
