julian-zatloukal/SAPLM/Proyecto atmel studio/Material/Fotos/1033804_D975XBX2KR-angle-view.png

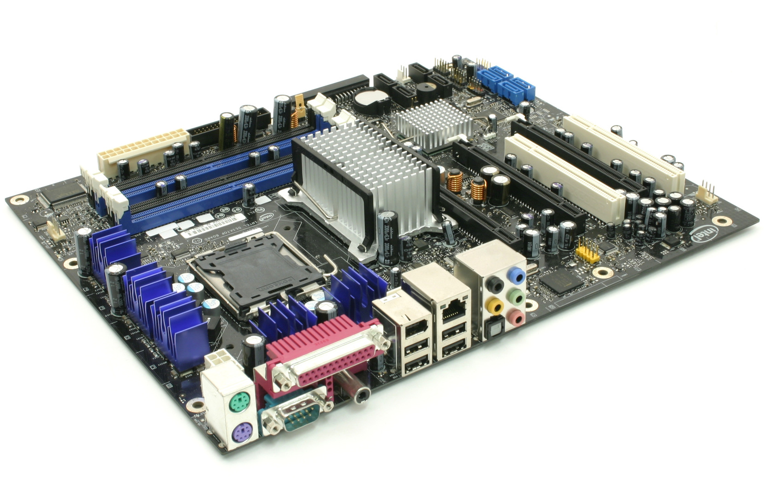
Proyecto atmel studio/Material/Fotos/1033804_D975XBX2KR-angle-view.png
