julian-zatloukal/SAPLM/Documentacion/Informe escolar/Plantillas LaTeX/prueba_IURAT.tex

\documentclass[11pt, a4paper, oneside]{article}
\usepackage{geometry}
\usepackage{lipsum}
\usepackage[spanish]{babel}

\begin{document}
\tableofcontents
\newpage

\renewcommand{\thesubsection}{\alph{subsection}}
\section{Ejercicio 1}
\subsection{Cálculo de filtro L-C}
\lipsum[1]
\subsection{Circuito de control}
\lipsum[1]
\subsection{Simulacion en Proteus VSM}
\lipsum[1]

\section{Ejercicio 2}
\subsection{Cálculo de filtro L-C}
\lipsum[1]
\subsection{Diseño de circuito de control con temporizador 555}
\lipsum[1]
\subsection{Simulación en Proteus VSM}
\lipsum[1]

\section{Ejercicio 3}
\subsection{Cálculo de filtro L-C}
\lipsum[1]
\subsection{Diseño de circuito de control con oscilador de diente de sierra y comparador}
\lipsum[1]
\subsection{Simulacion en Proteus VSM}
\lipsum[1]

\appendix
\section*{Bibliografía}
\addcontentsline{toc}{section}{Bibliografía}
\end{document}
