julian-zatloukal/SAPLM/Proyecto atmel studio/Material/Fotos/ATmega128A-AU-ATmega128-AVR-Development-Evaluation-Board-Kit-OpenM128-Standard.jpg_640x640.jpg

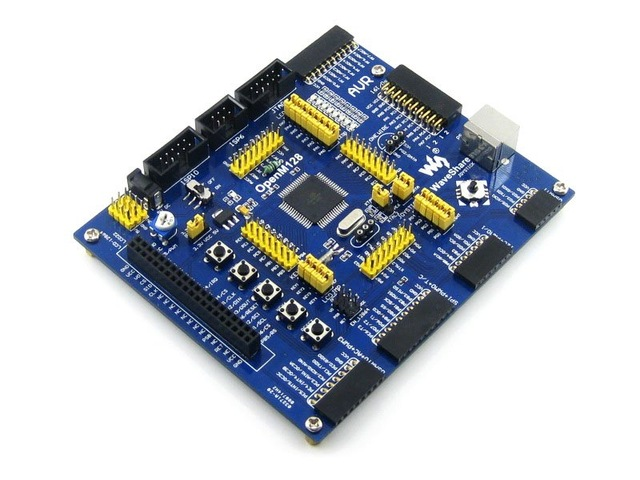
Proyecto atmel studio/Material/Fotos/ATmega128A-AU-ATmega128-AVR-Development-Evaluation-Board-Kit-OpenM128-Standard.jpg_640x640.jpg
