julian-zatloukal/SAPLM/Documentacion/Informe ACTE/NUEVO CODIGO/COMPILADO_PLACA_MOTRIZ.pdf

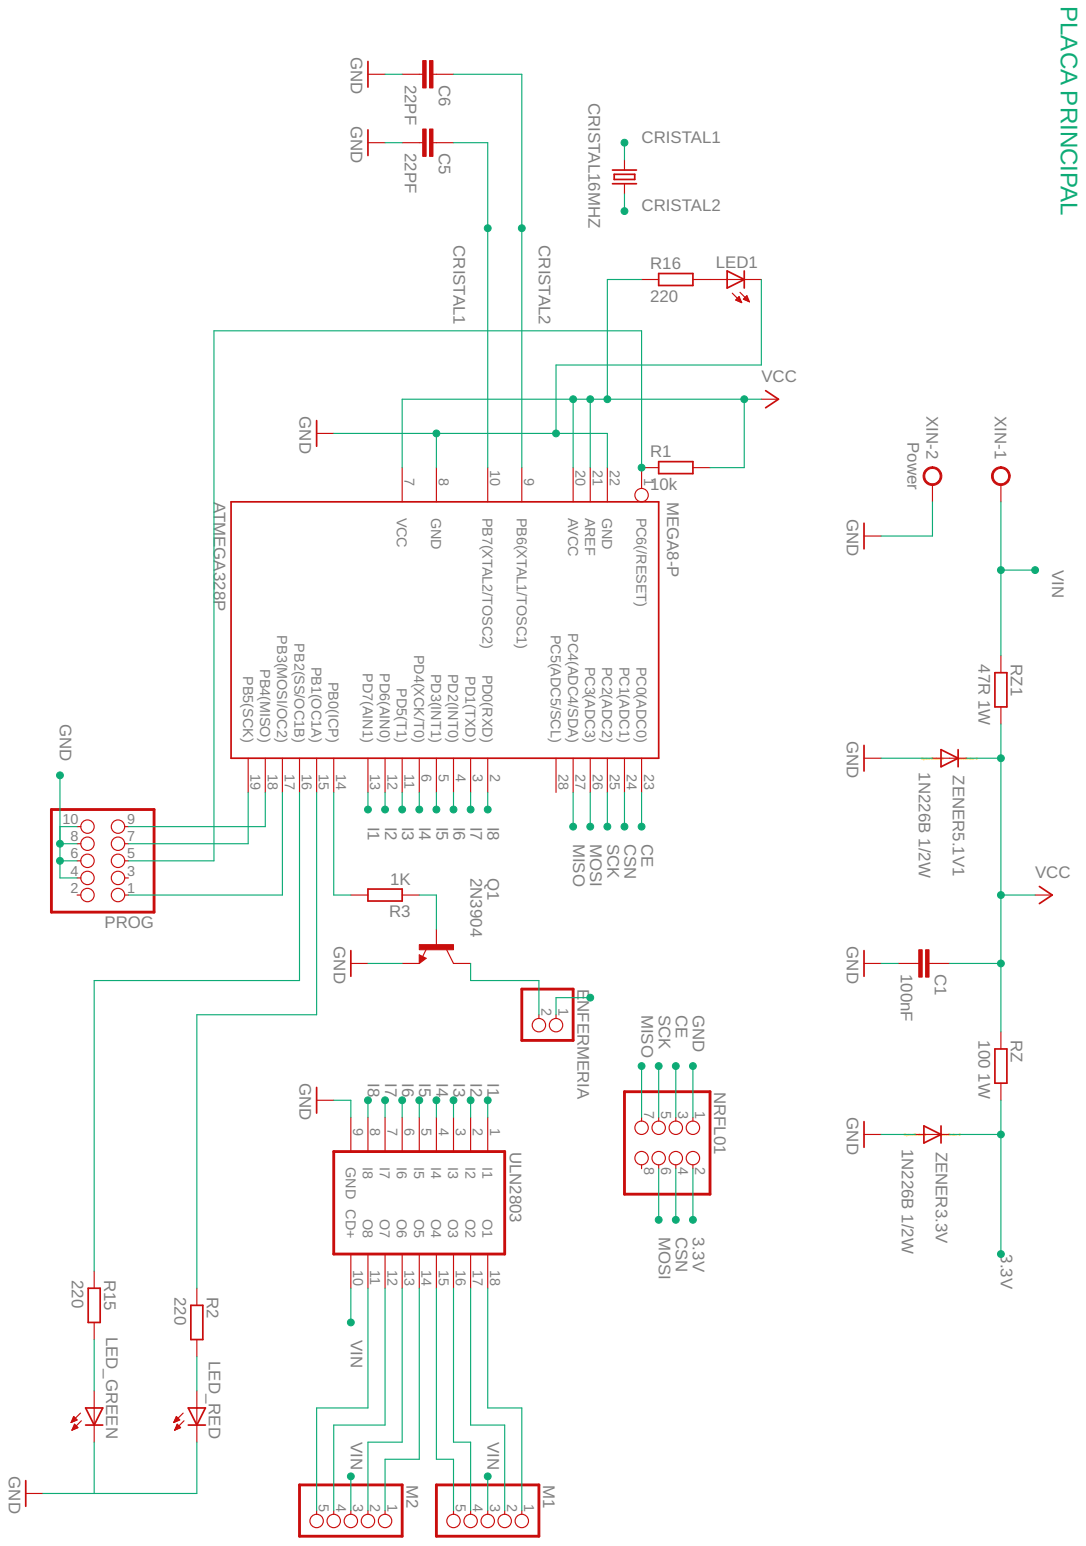
[picture p37: page 1]

PB4(MISO) 18 PB3(MOSI/OC2) 17 PB2(SS/OC1B) 16 PB1(OC1A) 15 PB0(ICP) 14 PD7(AIN1) 13 PD6(AIN0) 12 PD5(T1) 11 PD4(XCK/T0) 6 PD3(INT1) 5 PD2(INT0) 4 PD1(TXD) 3 PD0(RXD) 2 PC5(ADC5/SCL) 28 PC4(ADC4/SDA) 27 PC3(ADC3) 26 PC2(ADC2) 25 PC1(ADC1) 24 PC0(ADC0) 23 PC6(/RESET) 1 R1

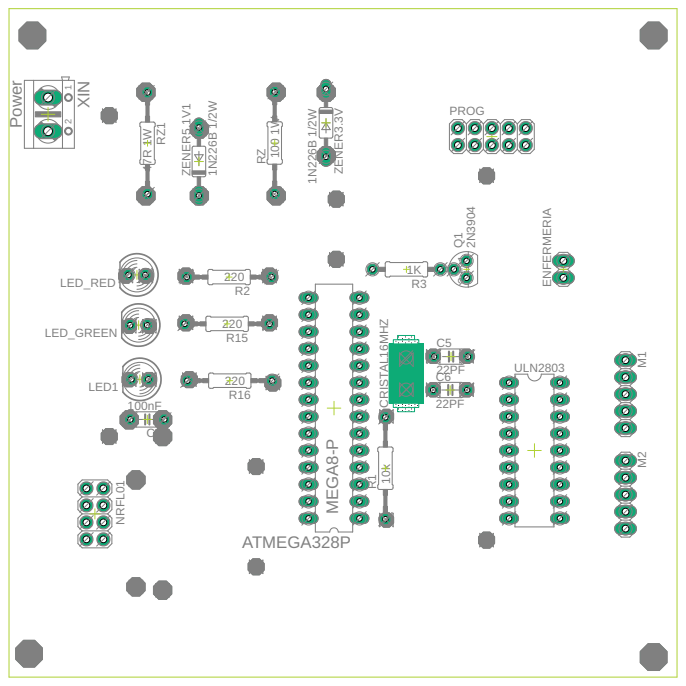
[picture p38: page 2]

1 2 2 3 1 ATMEGA328P C1 C5 C6 CRISTAL16MHZ LED1 LED_GREEN LED_RED M1 M2 NRFL01 PROG R1 R15 R16 R2 RZ RZ1 ULN2803 XIN ZENER3.3V ZENER5.1V1 Q1 R3 ENFERMERIA MEGA8-P 100nF 22PF 22PF 10k 220 220 220 100 1W 47R 1WPower 1N226B 1/2W 1N226B 1/2W 2N3904 1K

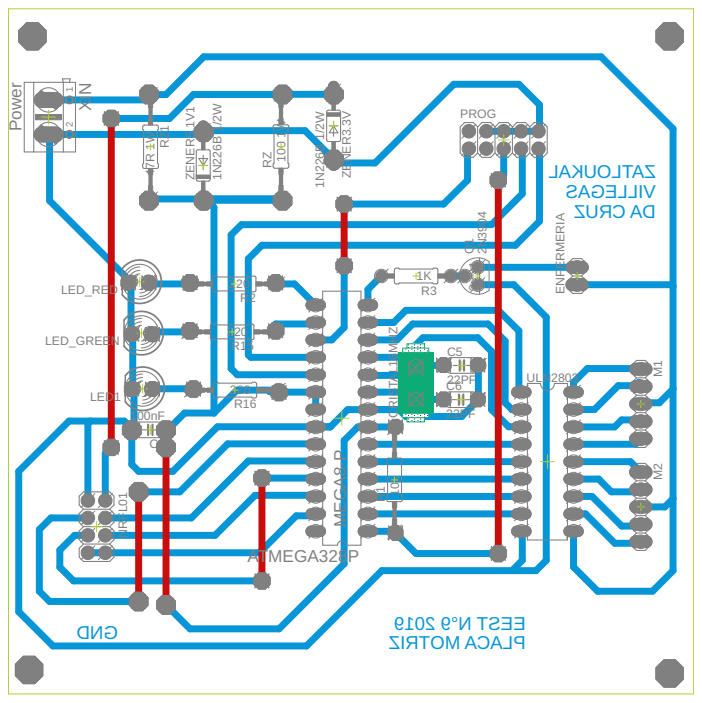
[picture p39: page 3]

220
R2
