julian-zatloukal/SAPLM/Documentacion/Informe ACTE/NUEVO CODIGO/COMPILADO_PLACA_POTENCIA.pdf

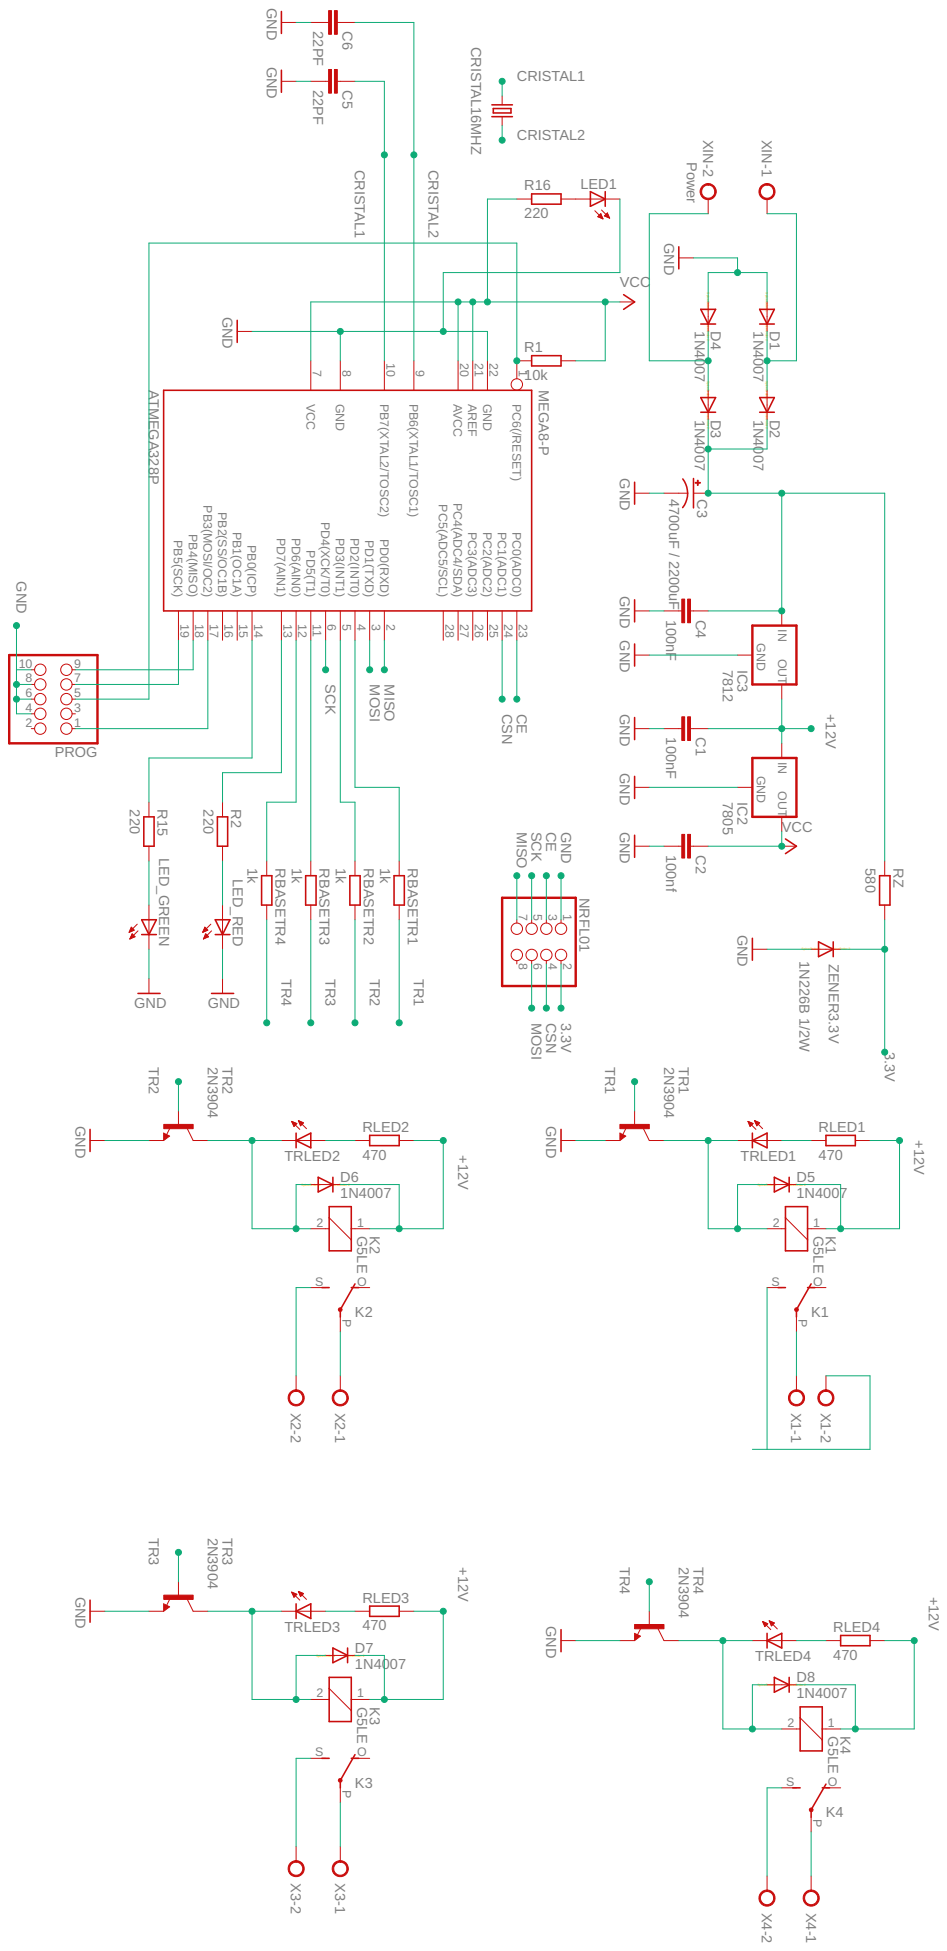
[picture p40: page 1]

IN OUT D1 C1 C2 XIN-1 XIN-2 C3 D2 D3 D4

100nF 100nf GND GND GND GND

SpiceOrder 1 SpiceOrder 2

PB4(MISO) 18 PB3(MOSI/OC2) 17 PB2(SS/OC1B) 16 PB1(OC1A) 15 PB0(ICP) 14 PD7(AIN1) 13 PD6(AIN0) 12 PD5(T1) 11 PD4(XCK/T0) 6 PD3(INT1) 5 PD2(INT0) 4 PD1(TXD) 3 PD0(RXD) 2 PC5(ADC5/SCL) 28 PC4(ADC4/SDA) 27 PC3(ADC3) 26 PC2(ADC2) 25 PC1(ADC1) 24 PC0(ADC0) 23 PC6(/RESET) 1 R1

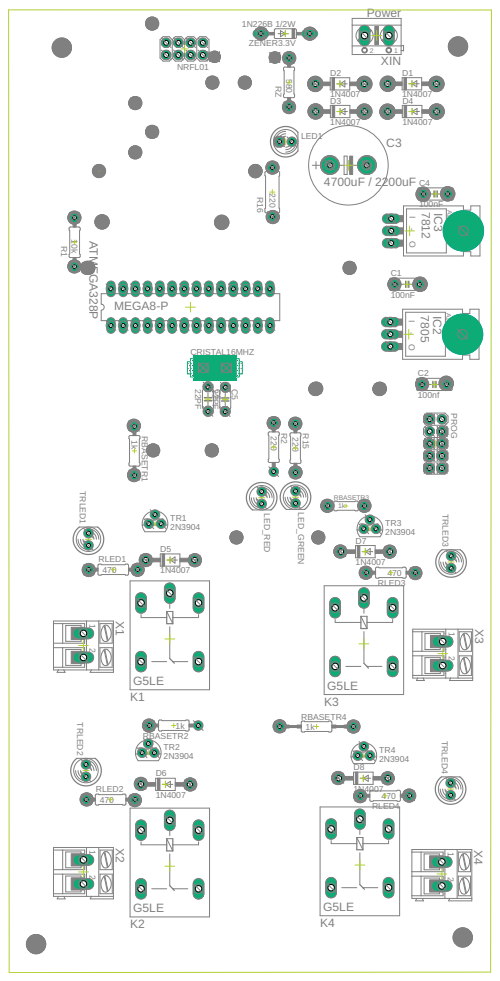
[picture p41: page 2]

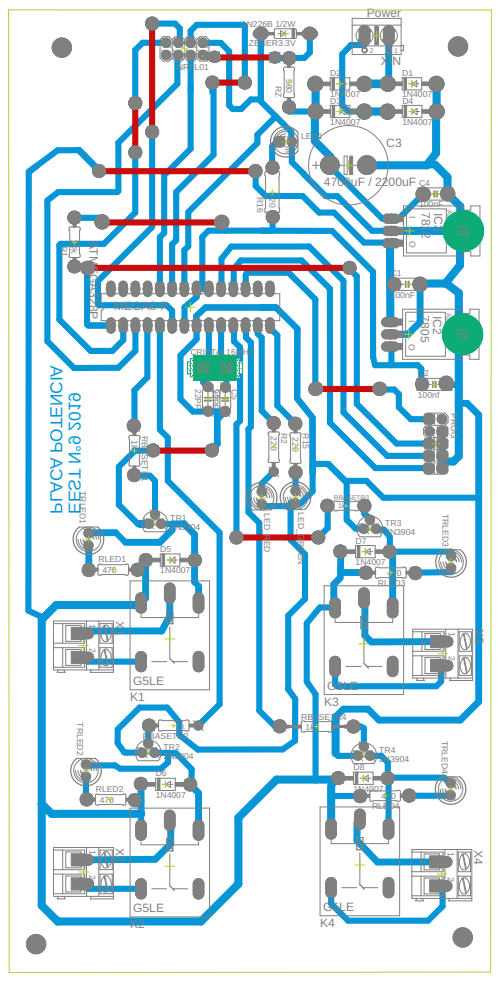
[picture p42: page 3]

EEST N°9 2019 PLACA POTENCIA A15,2mm 2 1 A15,2mm 1 2 1 2 1 2 1 2 - I O - I O 2 3 1 2 3 1 2 3 1 2 3 1 C1 C2 D1 ATMEGA328PIC2 PROG LED1 R1 RBASETR3 RBASETR4 R15 R16 RBASETR1 RBASETR2 XINC3 D2 D3 D4 IC3 C4 C5 C6 CRISTAL16MHZ TR1NRFL01 K1 TRLED1 RLED1X1 TR2 K2 TRLED2 RLED2X2 TR3 K3 TRLED3 RLED3 X3 TR4 K4 TRLED4 RLED4 X4 LED_GREEND5 D6 D7 D8 RZ ZENER3.3V R2 LED_RED 100nF 100nf 1N4007 MEGA8-P 7805 10k 1k 1k 220 220 1k 1k Power 4700uF / 2200uF 1N4007 1N4007 1N40077812 100nF 22PF 22PF 2N3904 G5LE 470 2N3904 G5LE 470 2N3904 G5LE 470 2N3904 G5LE 470 1N4007 1N4007 1N4007 1N4007 580 1N226B 1/2W 220
