julian-zatloukal/SAPLM/Documentacion/Informe ACTE/NUEVO CODIGO/COMPILADO_PLACA_PRINCIPAL_FIN.pdf

# PLACA PRINCIPAL > Esquematico > Board

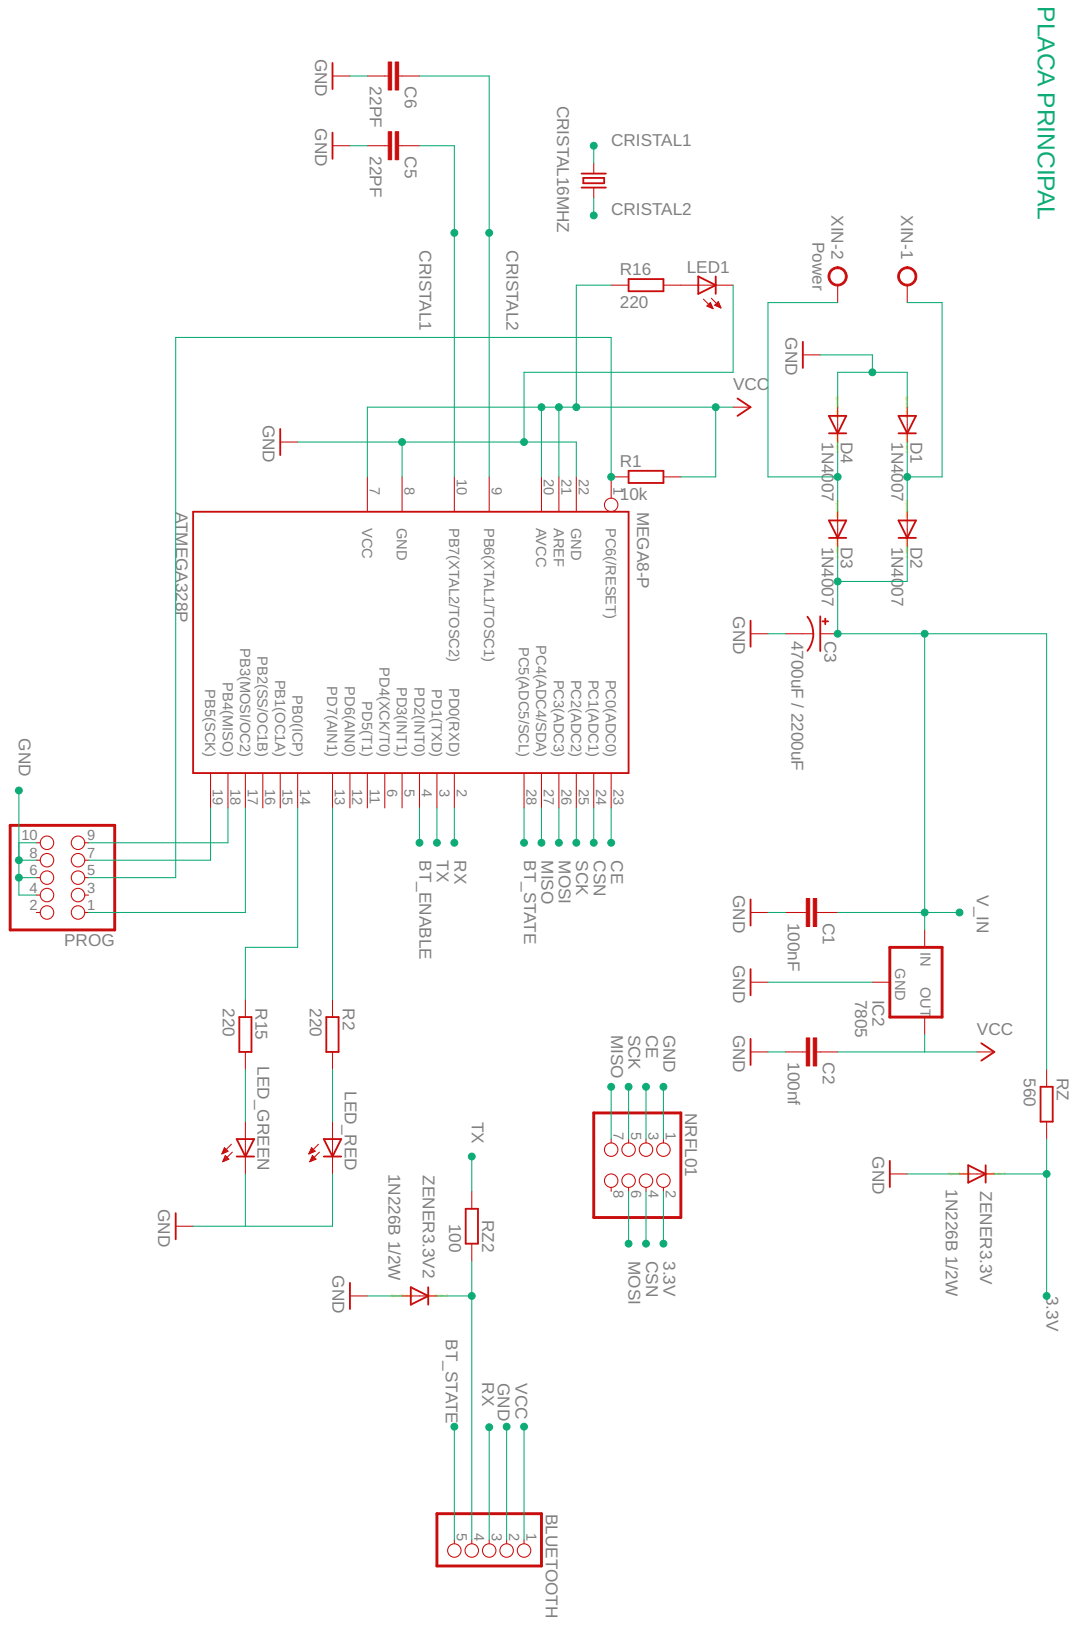
[picture p43: page 2]

SpiceOrder 1 SpiceOrder 2

PB4(MISO) 18 PB3(MOSI/OC2) 17 PB2(SS/OC1B) 16 PB1(OC1A) 15 PB0(ICP) 14

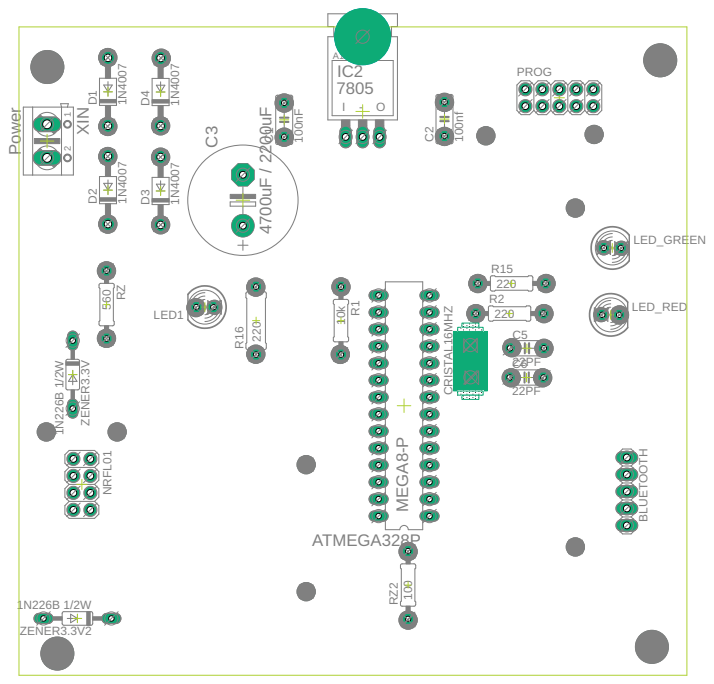
[picture p44: page 3]
O ATMEGA328P C¹; C5 C6 CRISTAL16MHZ D¹ D²; IC2 LED1; LED_GREEN LED_RED NRFL01; PROG R¹; R15 R¹⁶ R; R2 Z XIN ZENER³.3V ZENER3.3V2; BLUETOOTH MEGA⁸⁻P ¹⁰⁰nF; 22PF 22PF ¹N⁴⁰⁰⁷ 1N⁴⁰⁰⁷; 1N⁴⁰⁰⁷ ¹N⁴⁰⁰⁷; 220 ⁵⁶⁰ Power; 1N²²⁶B ¹/2W 1N226B 1/2W

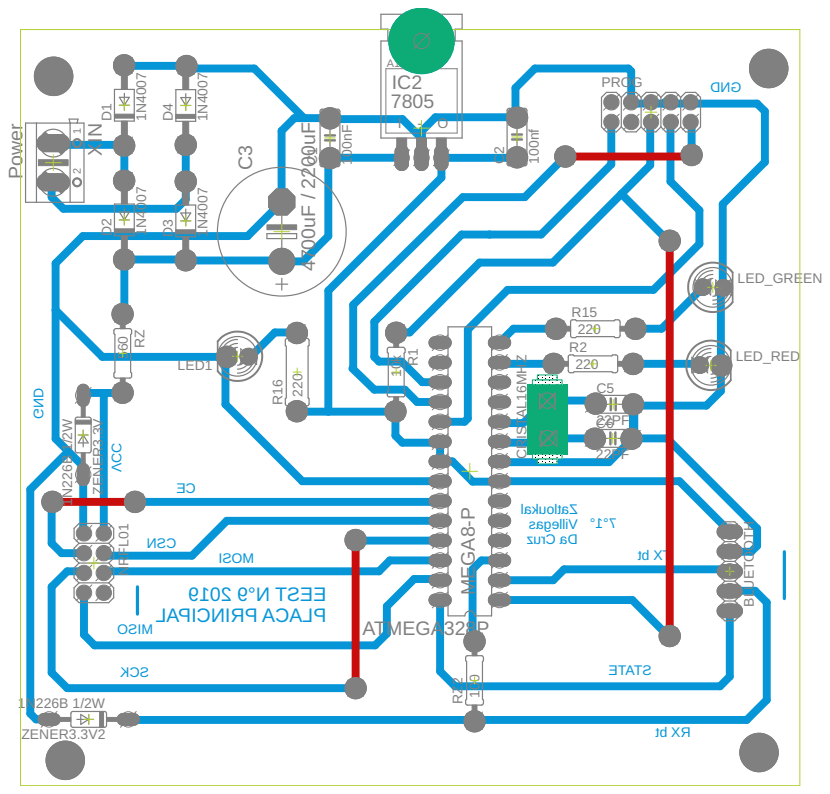
[picture p45: page 4]
