julian-zatloukal/SAPLM/Documentacion/Informe escolar/LATEX COMPILE/MAIN_PCB.pdf

# ·Circuito impreso: Módulo principal

Lista de componentes | Precio x unidad | Candad
Modulo de radiofrecuencia emisor/receptor | $ 100 | 1
Zocalo de 14x2 | $ 60 | 1
Capacitores Ceramicos | $ 2.50 | 4
Leds | $ 4.50 | 3
Diodos | $ 5 | 4
Resistecias de 1/4 w | $ 2.50 | 6
Capacitor Electrolico | $ 10 | 1
Cristal de 16Mhz | $ 30 | 1
Diodos zener de 1/2 w | $ 6 | 2
Regulador de tension | $ 25 | 1
Tira de 25 pinhead | $ 15 | 1
Borneras | $ 15 | 1
Plaqueta virgen 10x10 | $ 90 | 1
Módulo Bluetooth HC-05 | $390 | 1
Total | $ 803.50

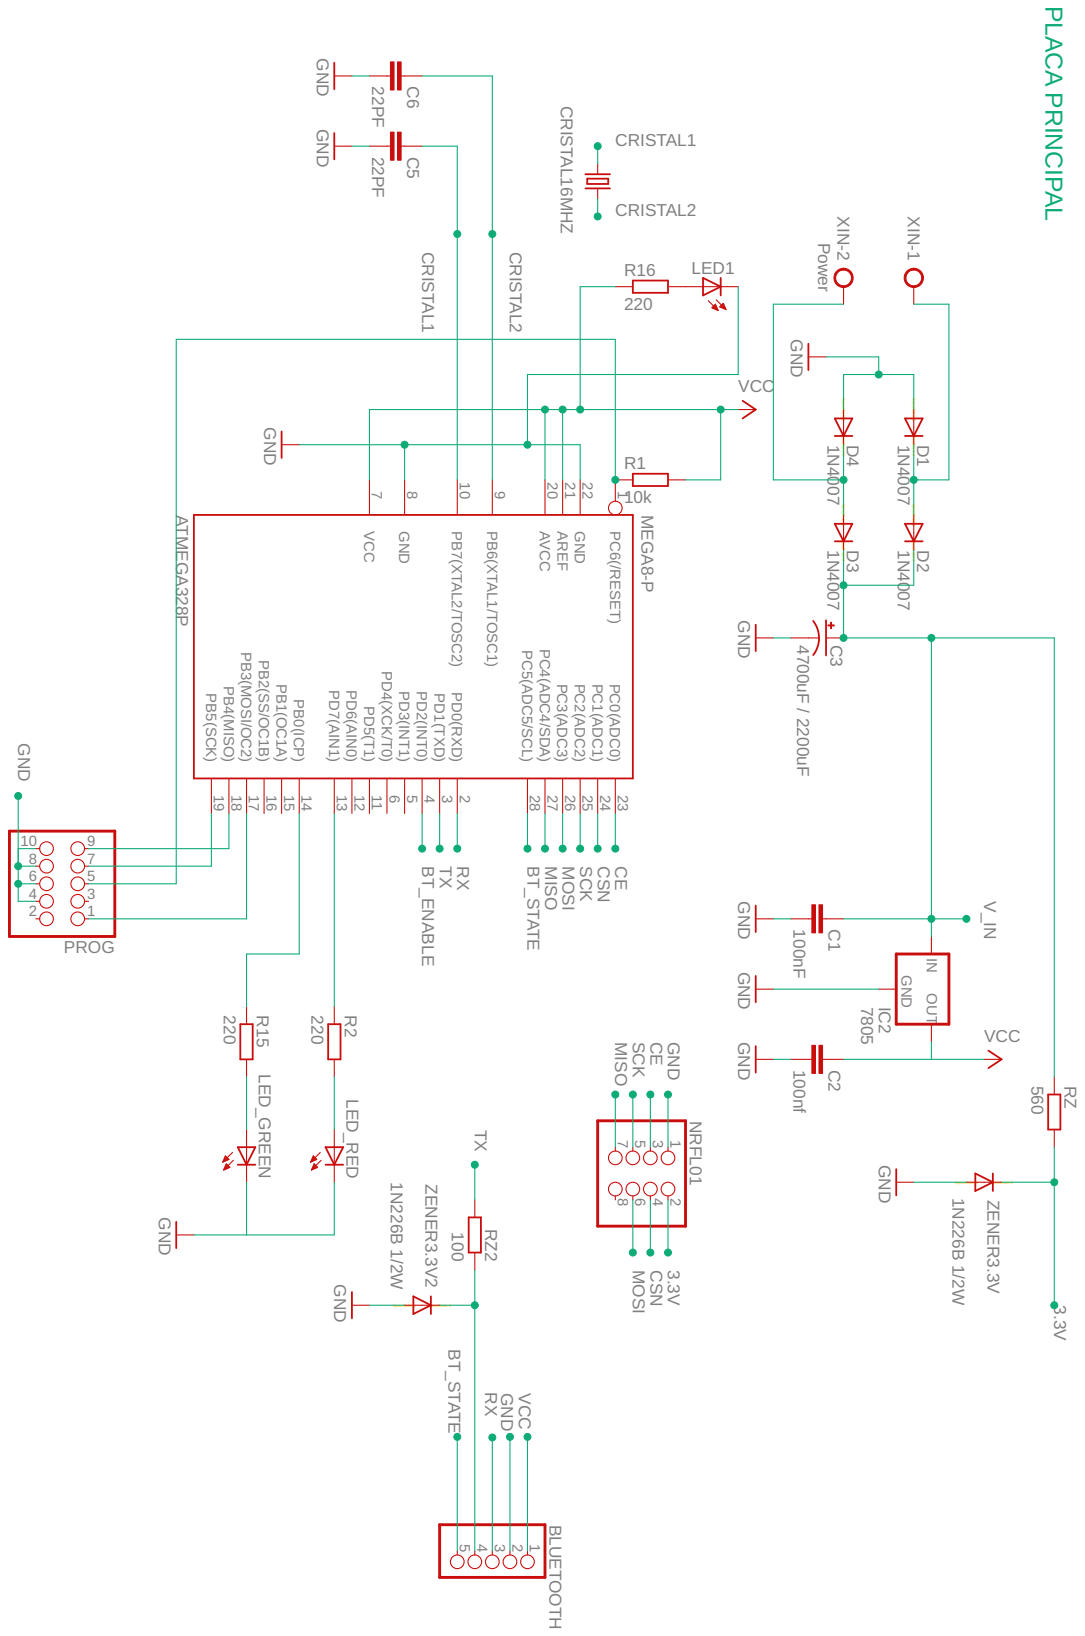
[picture p46: page 2]

SpiceOrder 1 SpiceOrder 2

PB4(MISO) 18 PB3(MOSI/OC2) 17 PB2(SS/OC1B) 16 PB1(OC1A) 15 PB0(ICP) 14

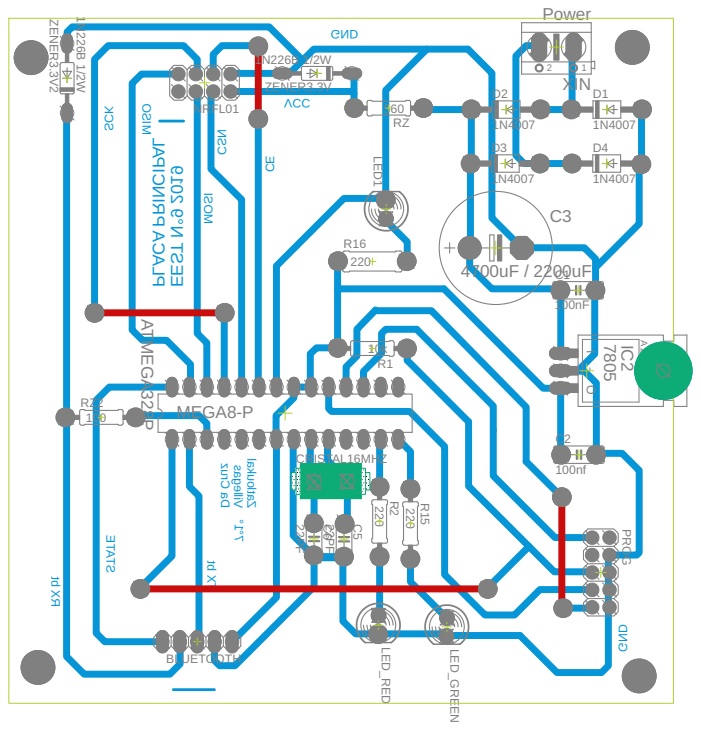
[picture p47: page 3]

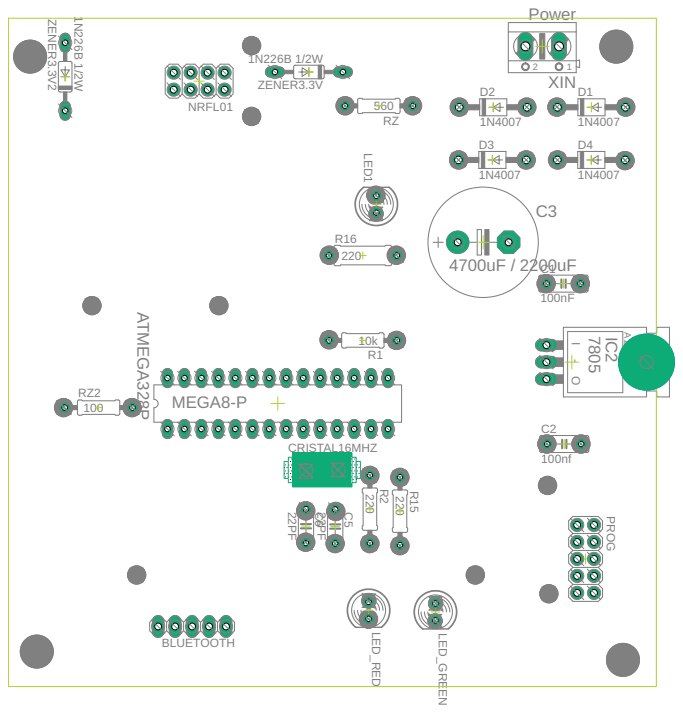
[picture p48: page 4]

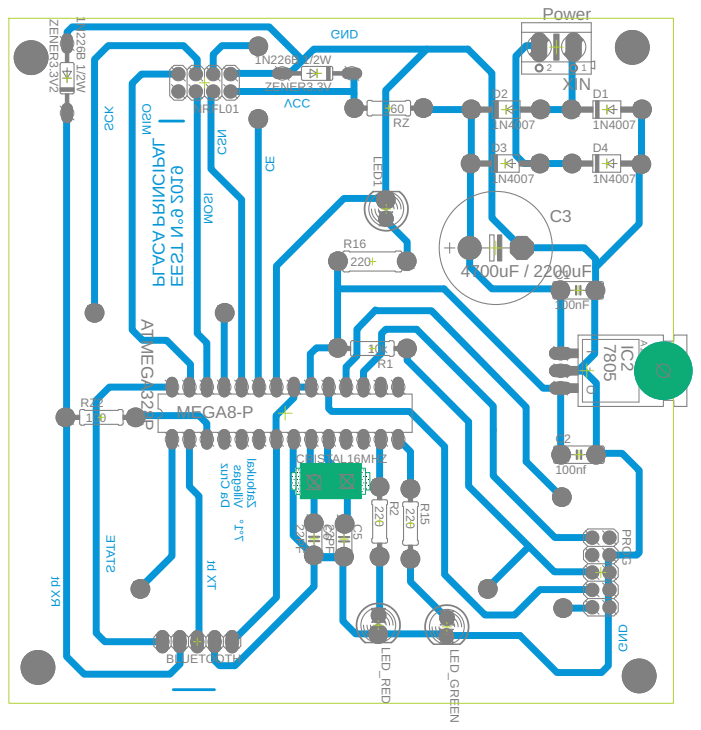
[picture p49: page 5]

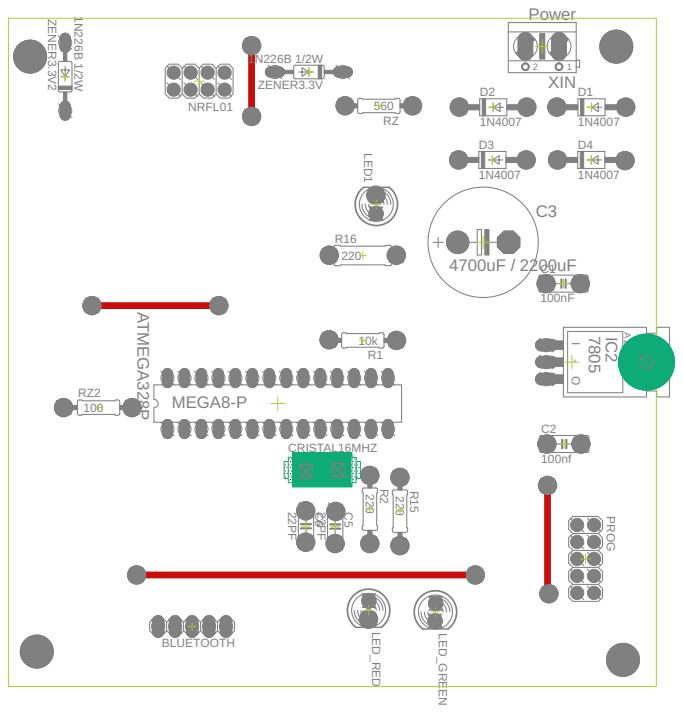
[picture p50: page 6]
