julian-zatloukal/SAPLM/Documentacion/Informe escolar/LATEX COMPILE/MOTOR_PCB.pdf

# ·Circuito impreso: Módulo de mandos motrices

Lista de componentes | Candad | Precio x unidad
Capacitores ceramicos | 3 | $ 2.50
Resistencias de 1/4 w | 7 | $ 1.50
Leds de 5mm | 3 | $ 4.50
Diodos zener de 1/2 w | 2 | $ 6
Cristal de 16Mhz | 1 | $ 30
Microcontrolador Atmega 328p | 1 | $ 250
Modulo de radiofrecuencia emisor/receptor | 1 | $ 100
Zocalo 14x2 | 1 | $ 60
ULN2803 | 1 | $ 60
Zocalo 18x2 | 1 | $ 60
Tira de 32 pinhead | 1 | $ 15
Borneras | 1 | $ 15
Transistor | 1 | $ 40
Plaqueta virgen de 10x10 | 1 | $ 90.00
| Total | $ 763.50

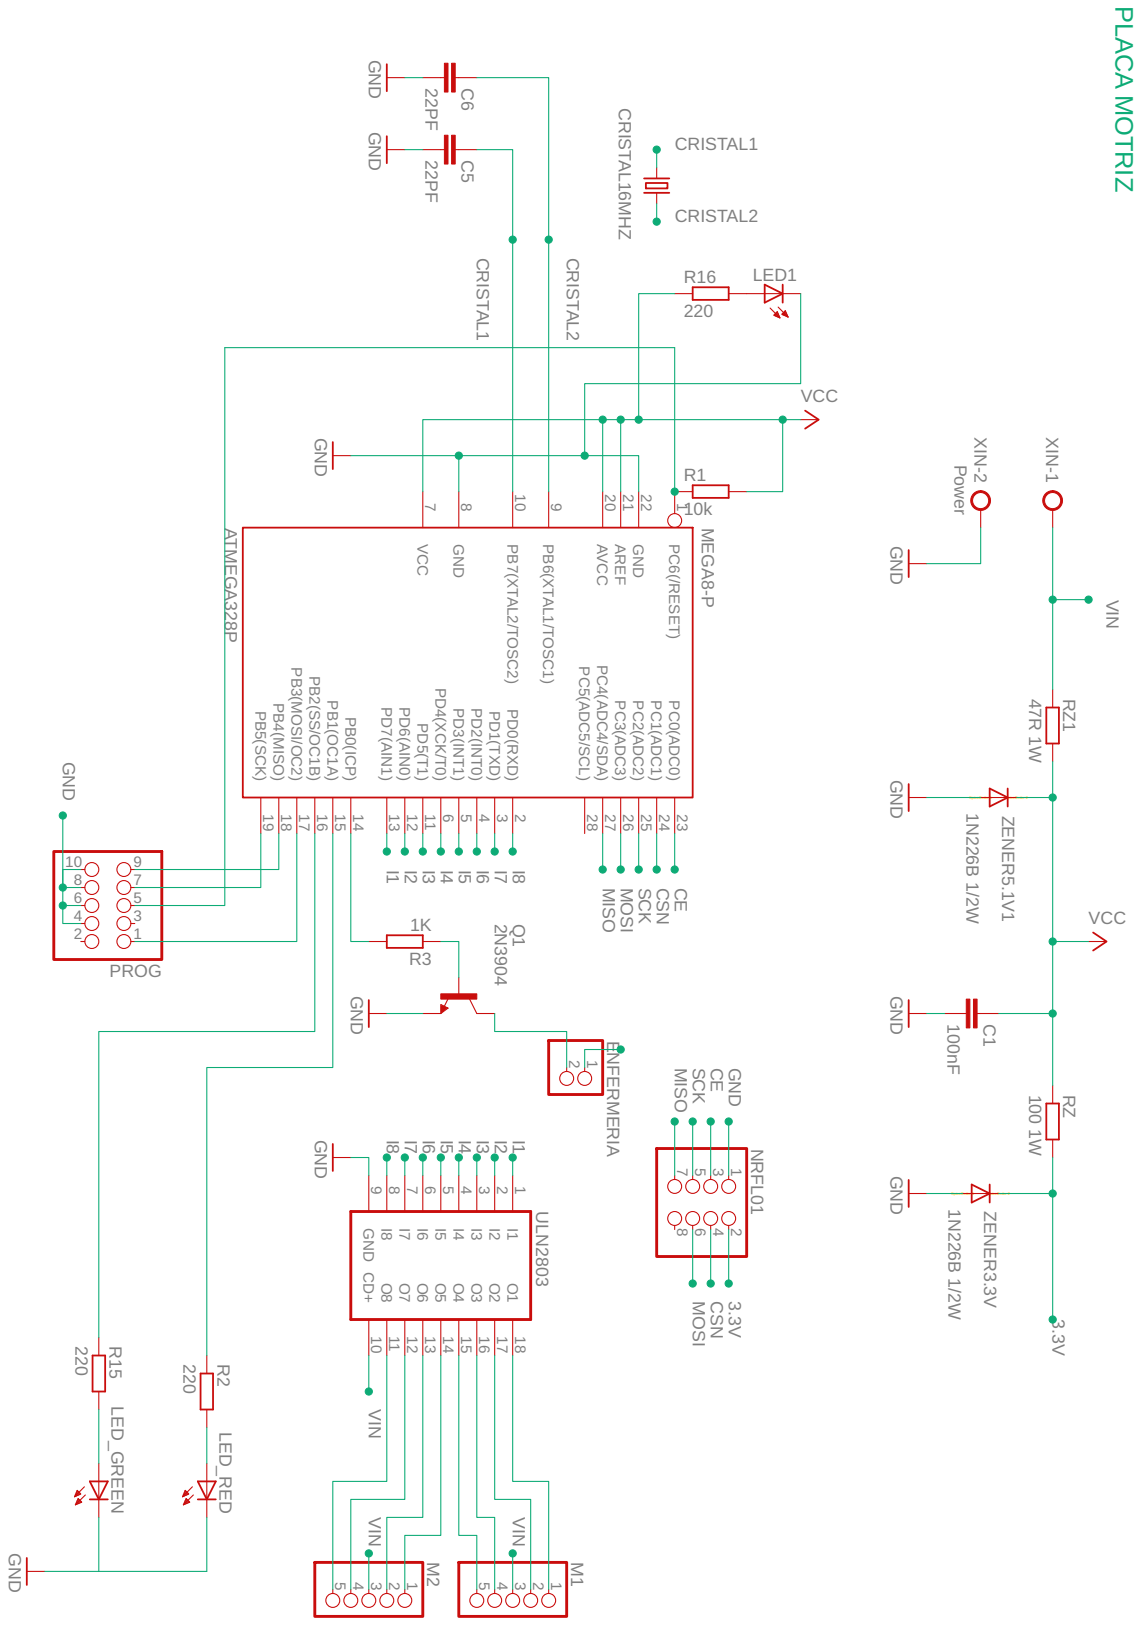
[picture p51: page 2]

PB4(MISO) 18 PB3(MOSI/OC2) 17 PB2(SS/OC1B) 16 PB1(OC1A) 15 PB0(ICP) 14

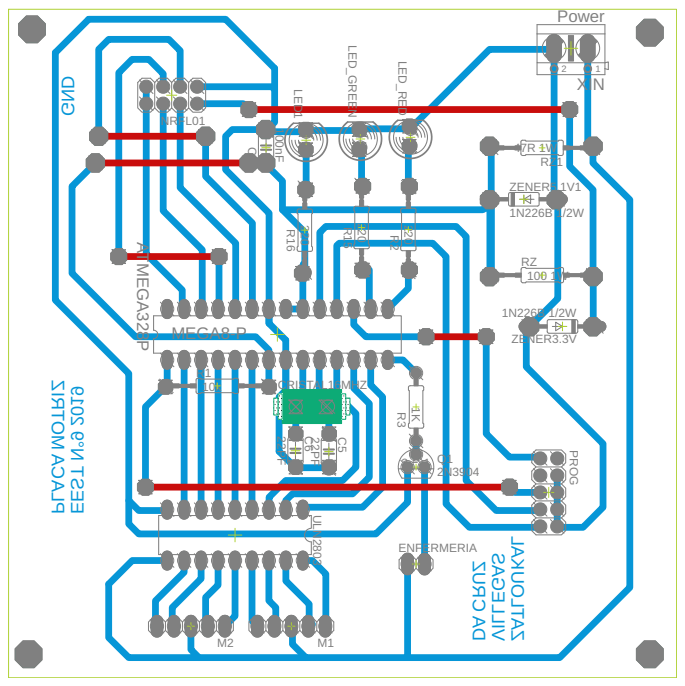
[picture p52: page 3]

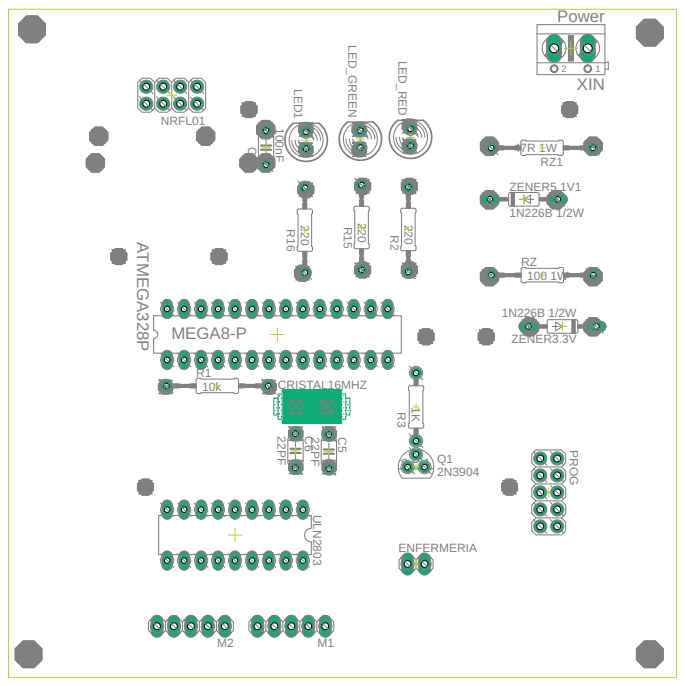
[picture p53: page 4]

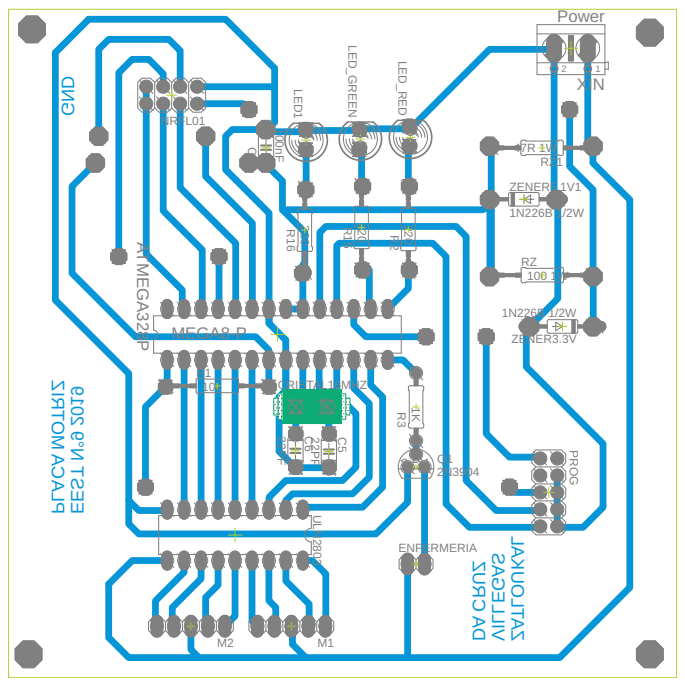
[picture p54: page 5]

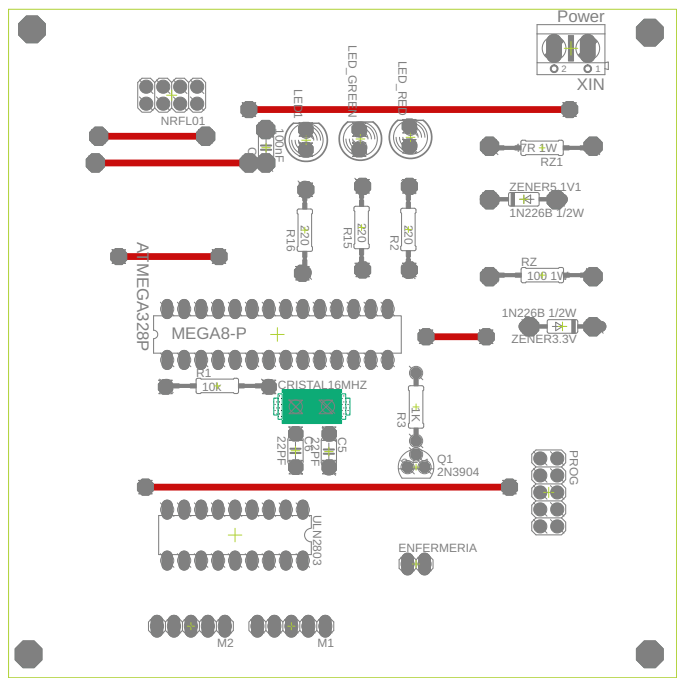
[picture p55: page 6]
