julian-zatloukal/SAPLM/Documentacion/Informe escolar/LATEX COMPILE/PCB FINAL IMPRESO.pdf

# ·Circuito impreso: Módulo principal

Lista de componentes | Precio x unidad | Candad
Modulo de radiofrecuencia emisor/receptor | $ 100 | 1
Zocalo de 14x2 | $ 60 | 1
Capacitores Ceramicos | $ 2.50 | 4
Leds | $ 4.50 | 3
Diodos | $ 5 | 4
Resistecias de 1/4 w | $ 2.50 | 6
Capacitor Electrolico | $ 10 | 1
Cristal de 16Mhz | $ 30 | 1
Diodos zener de 1/2 w | $ 6 | 2
Regulador de tension | $ 25 | 1
Tira de 25 pinhead | $ 15 | 1
Borneras | $ 15 | 1
Plaqueta virgen 10x10 | $ 90 | 1
Módulo Bluetooth HC-05 | $390 | 1
Total | $ 803.50

V

C


SpiceOrder 1 SpiceOrder 2

PB4(MISO) 18 PB3(MOSI/OC2) 17 PB2(SS/OC1B) 16 PB1(OC1A) 15 PB0(ICP) 14





# ·Circuito impreso: Módulo de mandos de potencia

Lista de componentes | Candad Precio x unidad
Capacitores ceramicos | 5 | $ 2.50
Capacitor electrolico | 1 | $ 10
Resistencias de 1/4 w | 13 | $ 1.50
Cristal de 16Mhz | 1 | $ 30
Leds de 5mm | 7 | $ 4.50
Diodos | 8 | $ 2.50
Diodo zener de 1/2 w | 1 | $ 6
Borneras | 4 | $ 15
Reguladores de tensión | 5 | $ 25
Modulo de radiofrecuencia emisor/receptor | 1 | $ 100
Microcontrolador atmega 328p | 1 | $ 250
Relays | 1 | $ 40
Tira de 20 pinhead | 1 | $ 15
Zocalo 14x2 | 1 | $ 60
Plaqueta virgen de 20x10 | 1 | $ 150
Transistores | 4 | $ 40
| Total | $ 1,089.50

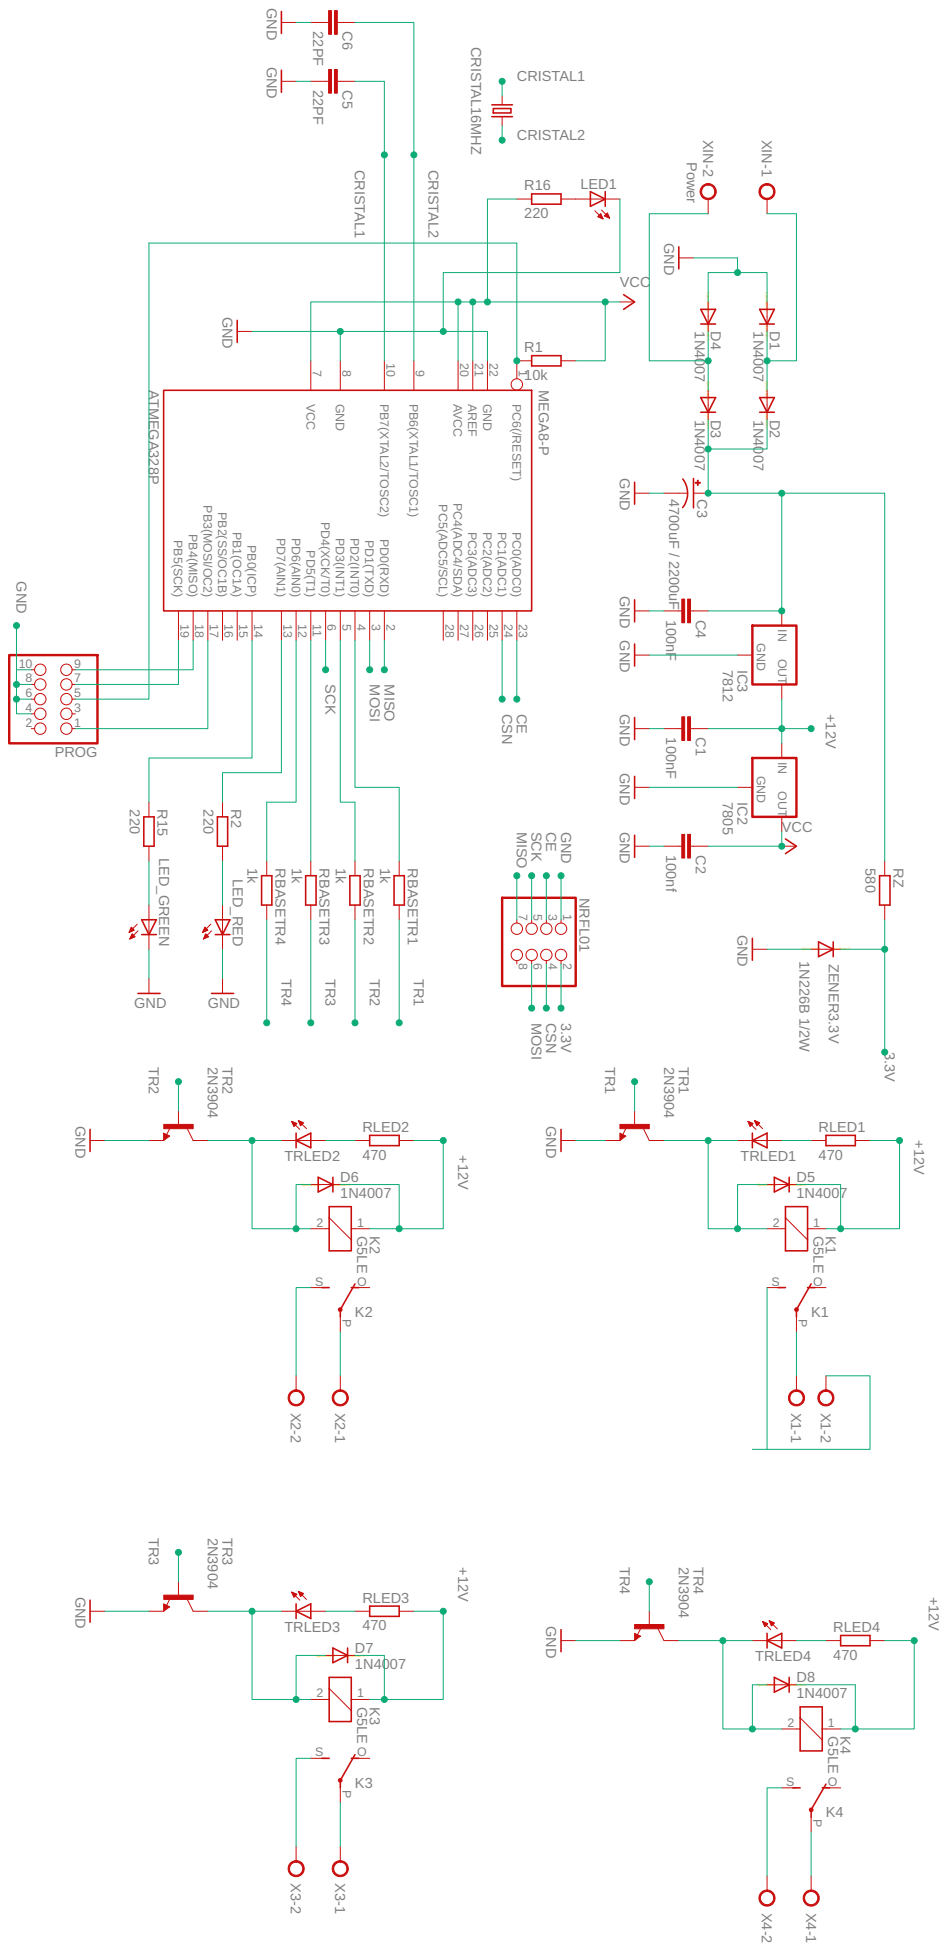
[picture p56: page 8]

IN OUT D1 C1 C2 XIN-2 XIN-1 C3 D3 D2 D4

100nF 100nf GND GND GND GND

SpiceOrder 1 SpiceOrder 2 SpiceOrder 1 SpiceOrder 2 SpiceOrder 1 SpiceOrder 2 SpiceOrder 1 SpiceOrder 2 SpiceOrder 1 SpiceOrder 2 SpiceOrder 1 SpiceOrder 2 SpiceOrder 1 SpiceOrder 2

SpiceOrder 1 SpiceOrder 2

PB4(MISO) 18 PB3(MOSI/OC2) 17 PB2(SS/OC1B) 16 PB1(OC1A) 15 PB0(ICP) 14 PD7(AIN1) 13 PD6(AIN0) 12 PD5(T1) 11 PD4(XCK/T0) 6 PD3(INT1) 5 PD2(INT0) 4 PD1(TXD) 3 PD0(RXD) 2 PC5(ADC5/SCL) 28 PC4(ADC4/SDA) 27 PC3(ADC3) 26 PC2(ADC2) 25 PC1(ADC1) 24 PC0(ADC0) 23 PC6(/RESET) 1 R1

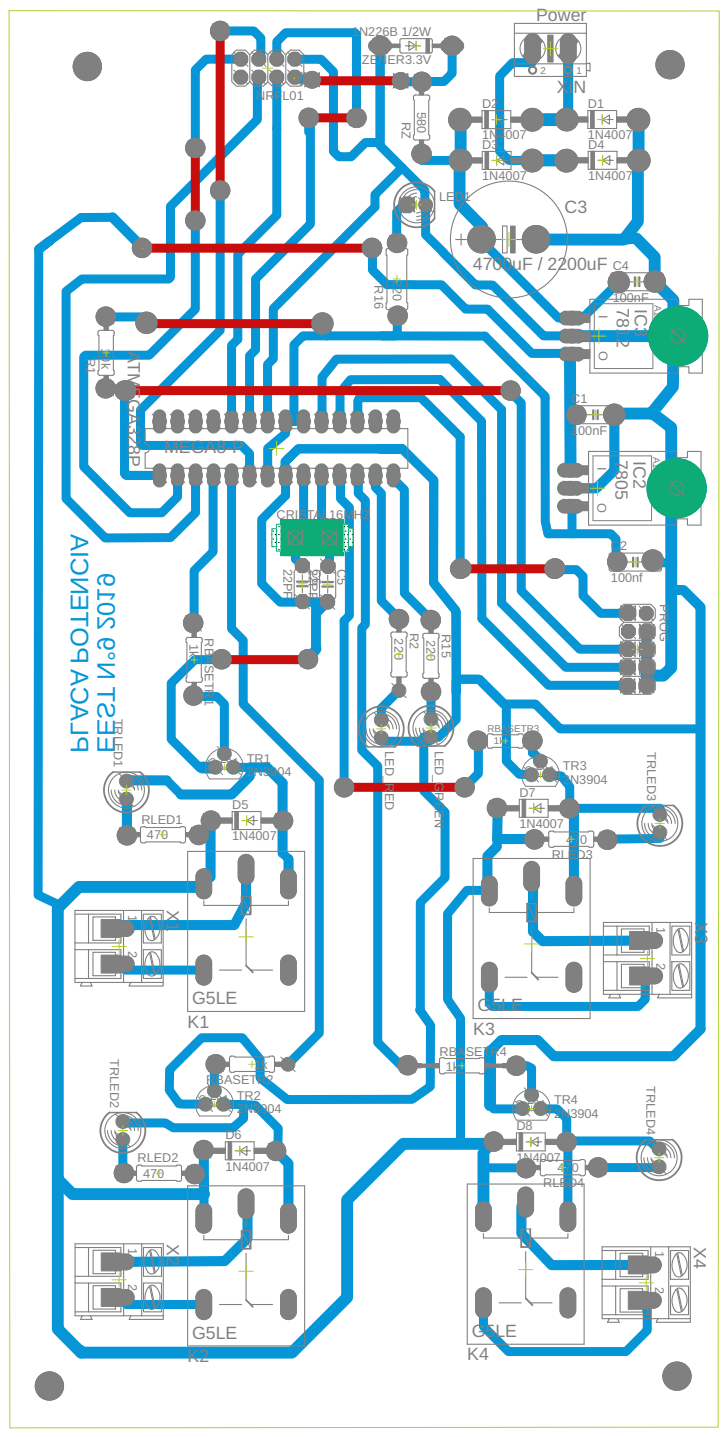
[picture p57: page 9]

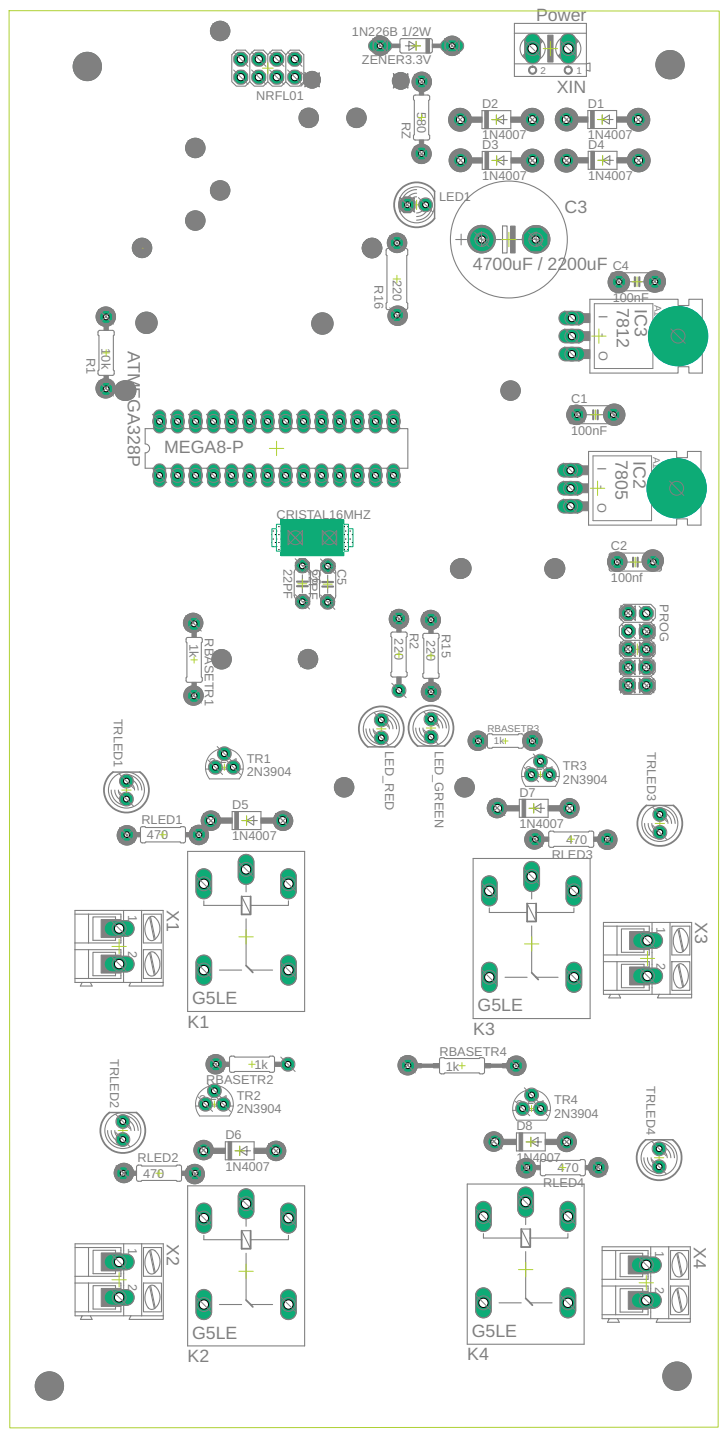
[picture p58: page 10]

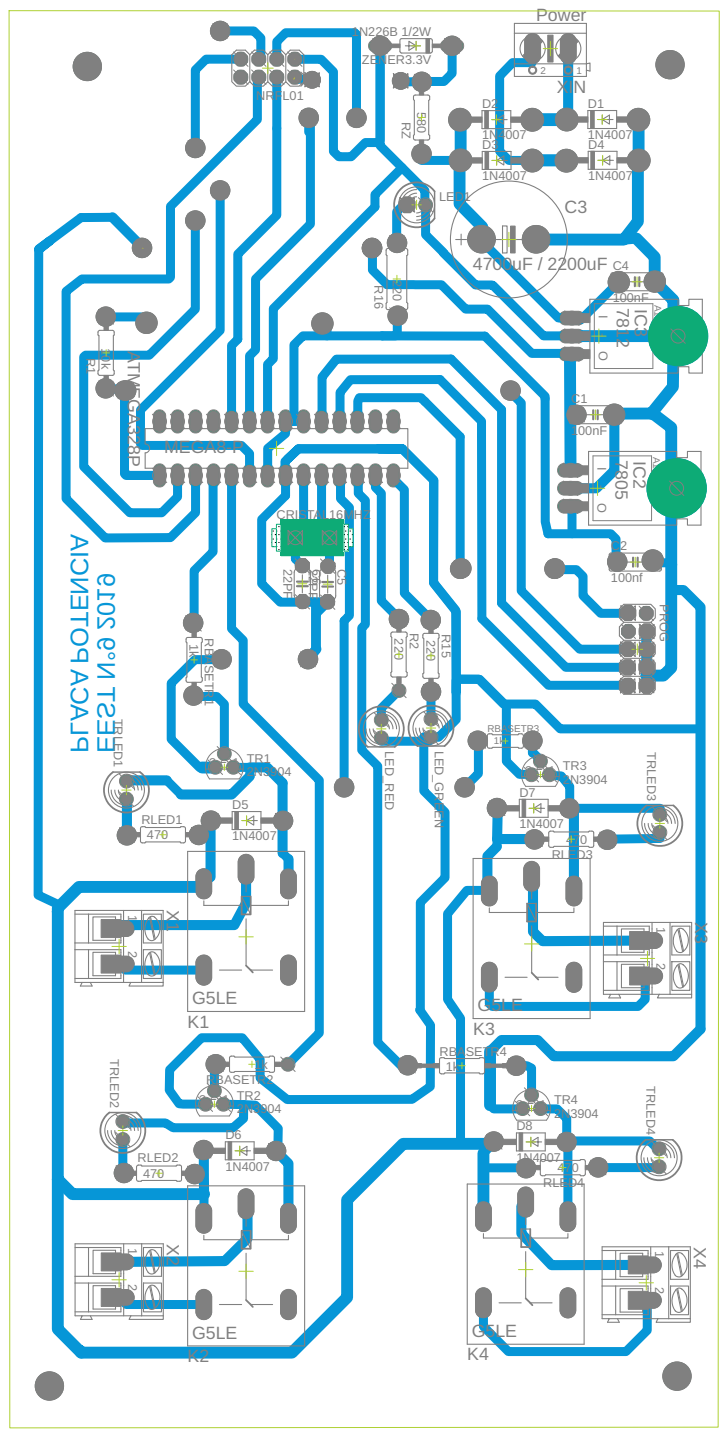
[picture p59: page 11]

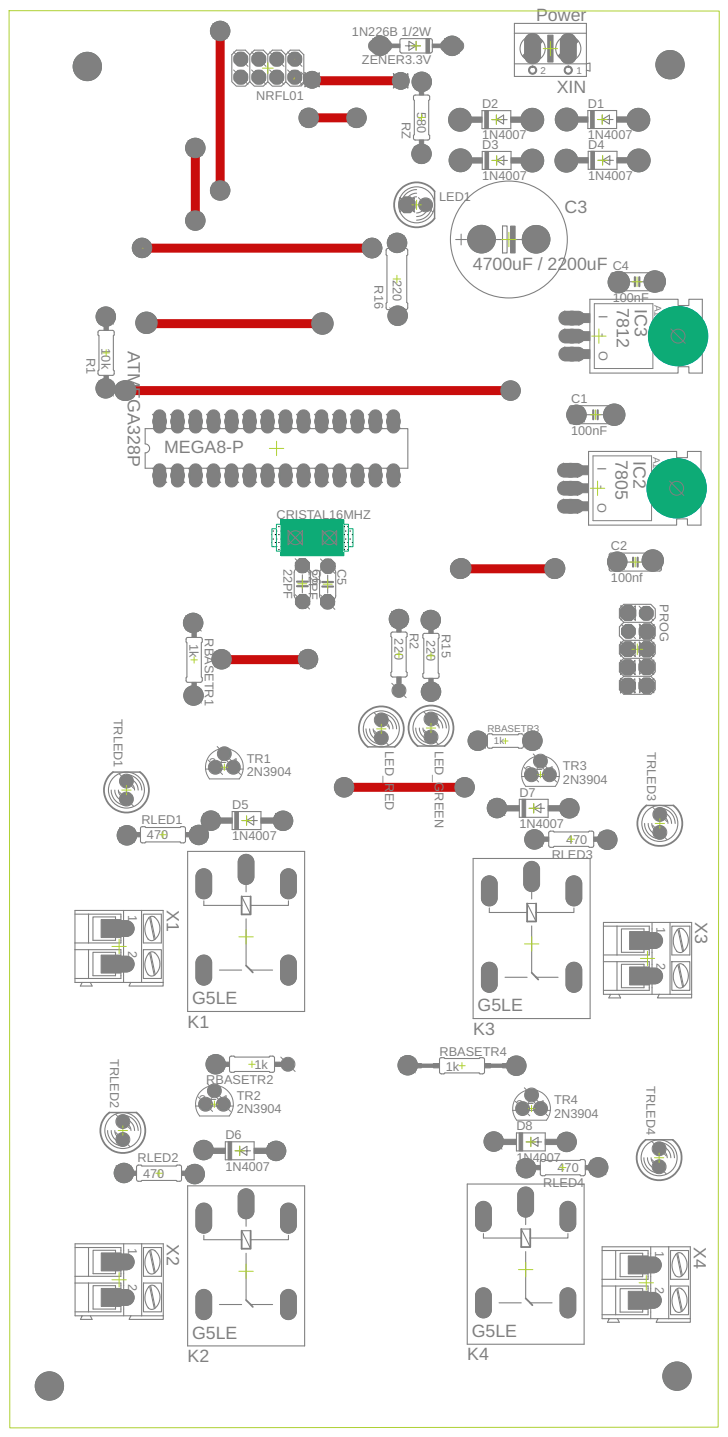
[picture p60: page 12]

# ·Circuito impreso: Módulo de mandos motrices

Lista de componentes | Candad | Precio x unidad
Capacitores ceramicos | 3 | $ 2.50
Resistencias de 1/4 w | 7 | $ 1.50
Leds de 5mm | 3 | $ 4.50
Diodos zener de 1/2 w | 2 | $ 6
Cristal de 16Mhz | 1 | $ 30
Microcontrolador Atmega 328p | 1 | $ 250
Modulo de radiofrecuencia emisor/receptor | 1 | $ 100
Zocalo 14x2 | 1 | $ 60
ULN2803 | 1 | $ 60
Zocalo 18x2 | 1 | $ 60
Tira de 32 pinhead | 1 | $ 15
Borneras | 1 | $ 15
Transistor | 1 | $ 40
Plaqueta virgen de 10x10 | 1 | $ 90.00
| Total | $ 763.50

8 | 7 10 | 9 | R16 | LED1

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
