julian-zatloukal/SAPLM/Documentacion/Informe escolar/PCB/COMPILED_MOTOR_BOARD.pdf

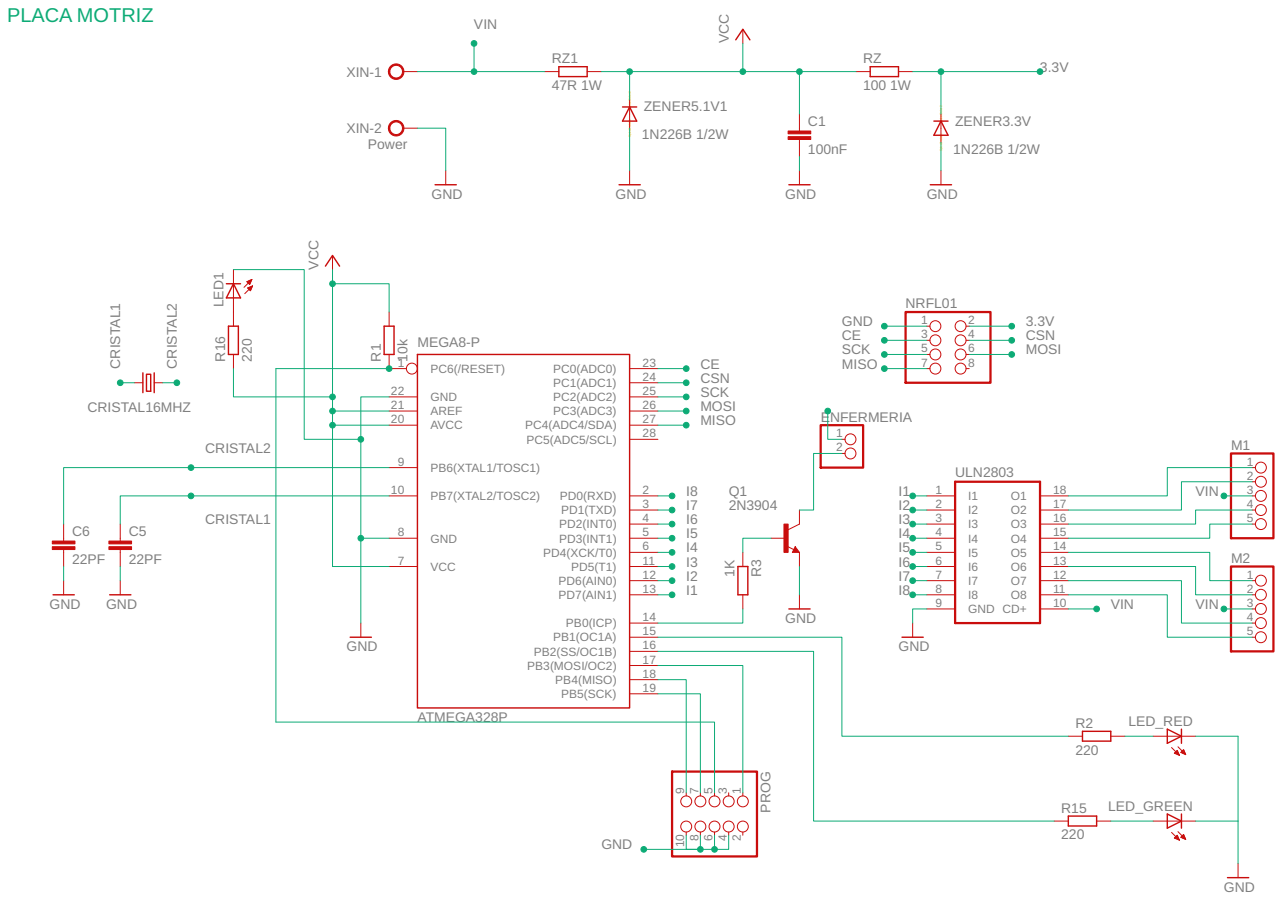
[picture p61: page 1]

SpiceOrder 1 SpiceOrder 2
ZENER5.1V1

VIN | 3 4

GND

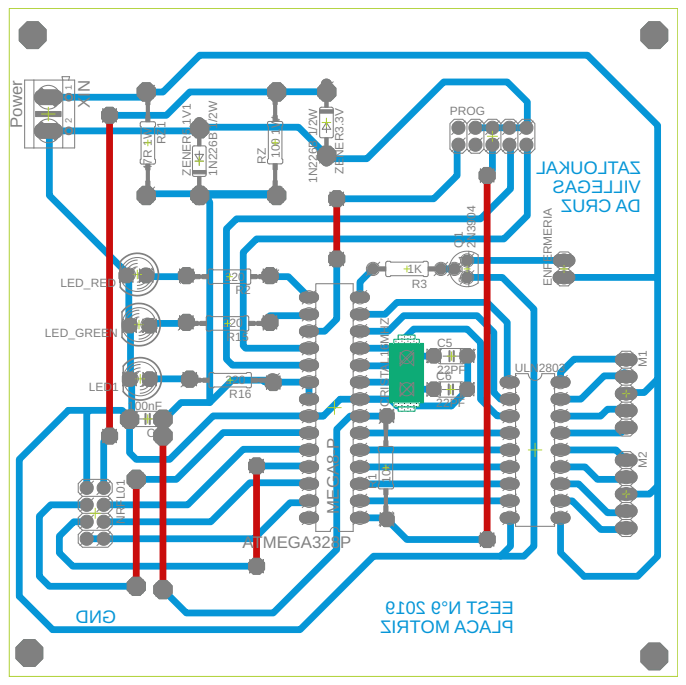
[picture p62: page 2]

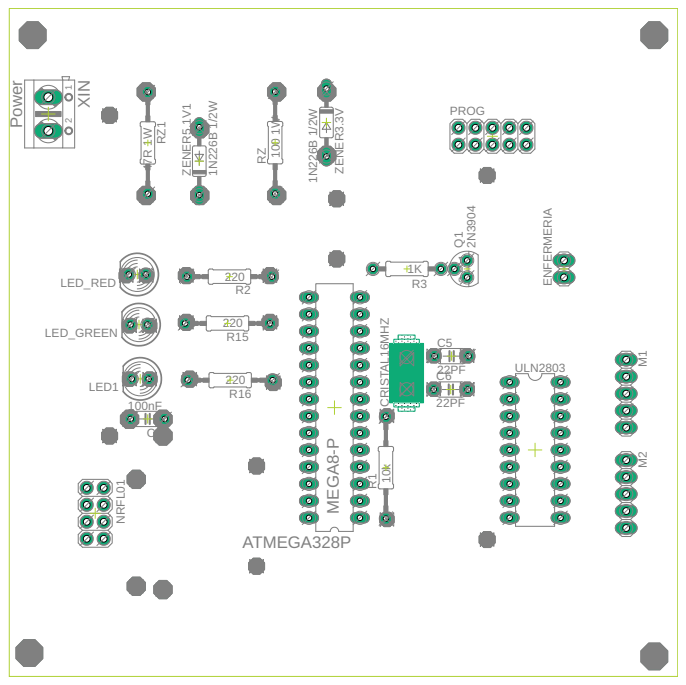
[picture p63: page 3]

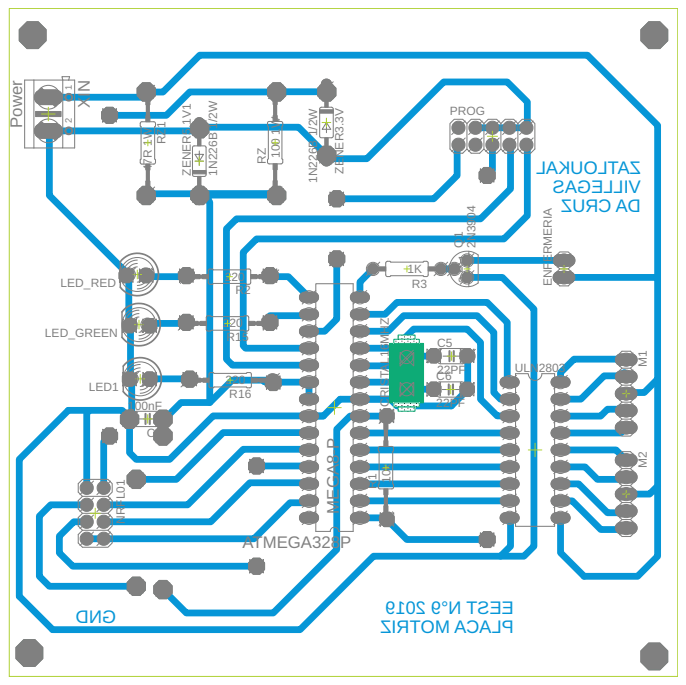
[picture p64: page 4]

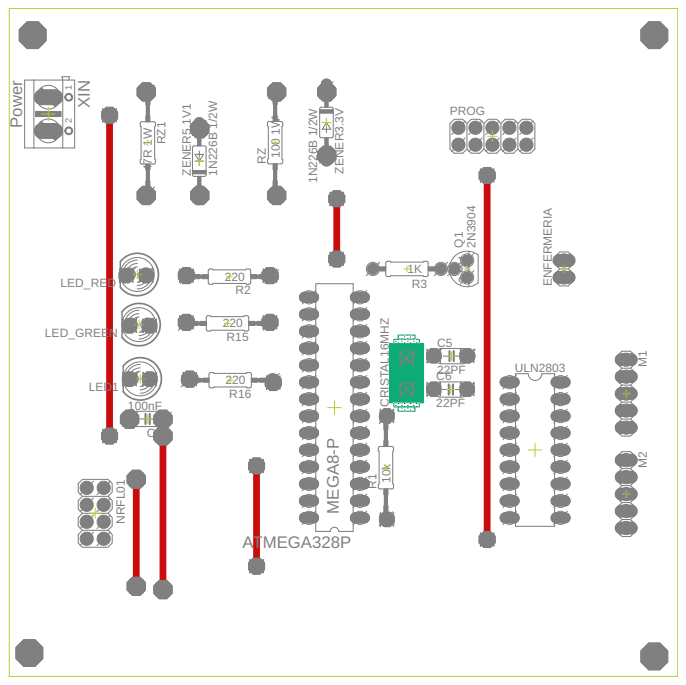
[picture p65: page 5]
