julian-zatloukal/SAPLM/Documentacion/Informe escolar/PCB/PCB FINAL DIGITAL.pdf

# ·Circuito impreso: Módulo principal

Lista de componentes | Precio x unidad | Candad
Modulo de radiofrecuencia emisor/receptor | $ 100 | 1
Zocalo de 14x2 | $ 60 | 1
Capacitores Ceramicos | $ 2.50 | 4
Leds | $ 4.50 | 3
Diodos | $ 5 | 4
Resistecias de 1/4 w | $ 2.50 | 6
Capacitor Electrolico | $ 10 | 1
Cristal de 16Mhz | $ 30 | 1
Diodos zener de 1/2 w | $ 6 | 2
Regulador de tension | $ 25 | 1
Tira de 25 pinhead | $ 15 | 1
Borneras | $ 15 | 1
Plaqueta virgen 10x10 | $ 90 | 1
Módulo Bluetooth HC-05 | $390 | 1
Total | $ 803.50

7805

1N4007

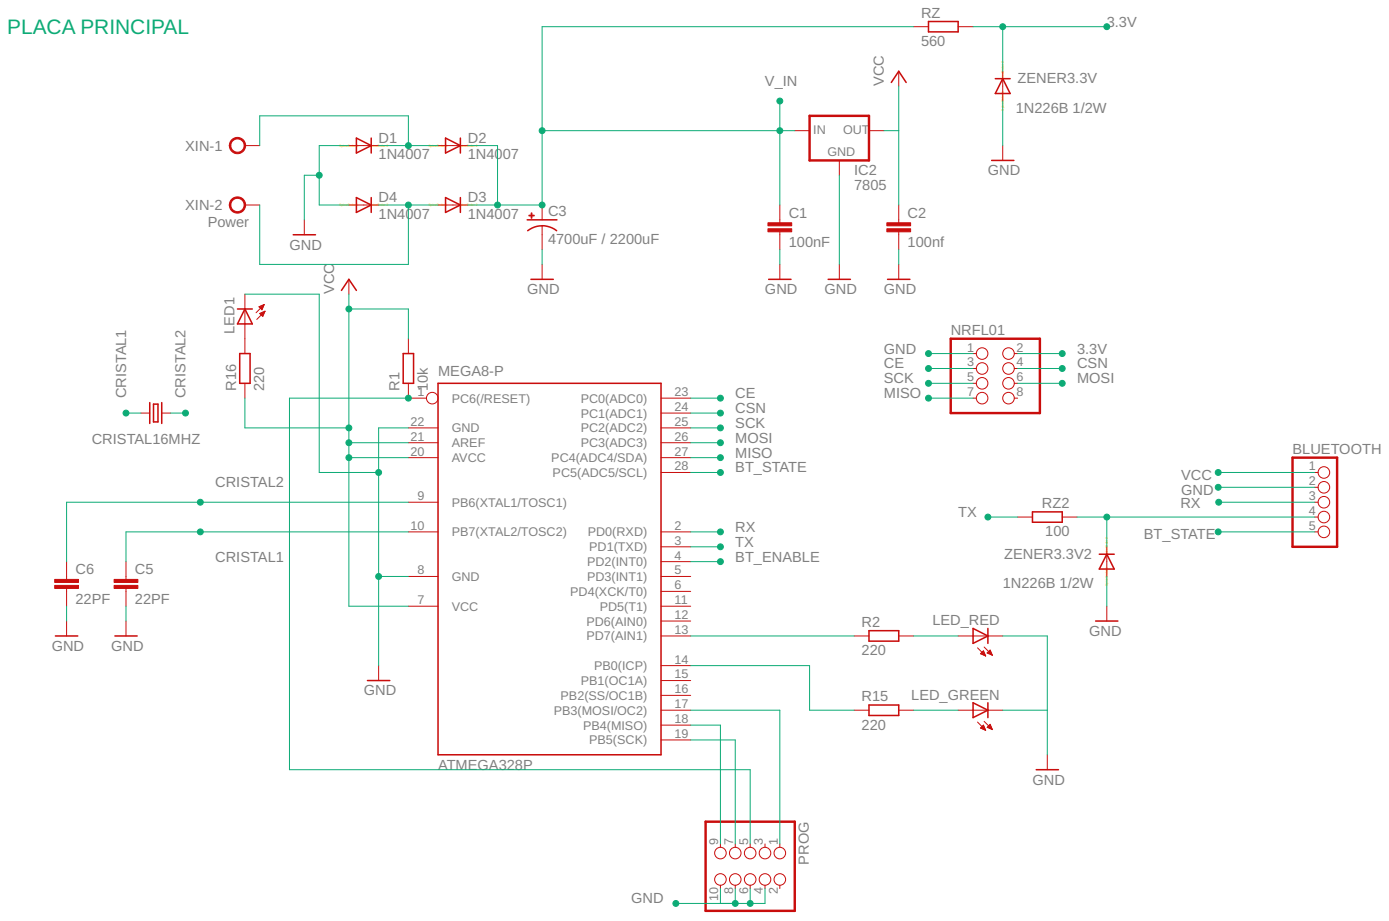
[picture p66: page 2]

PB7(XTAL2/TOSC2) 10

I | - | O

IC2

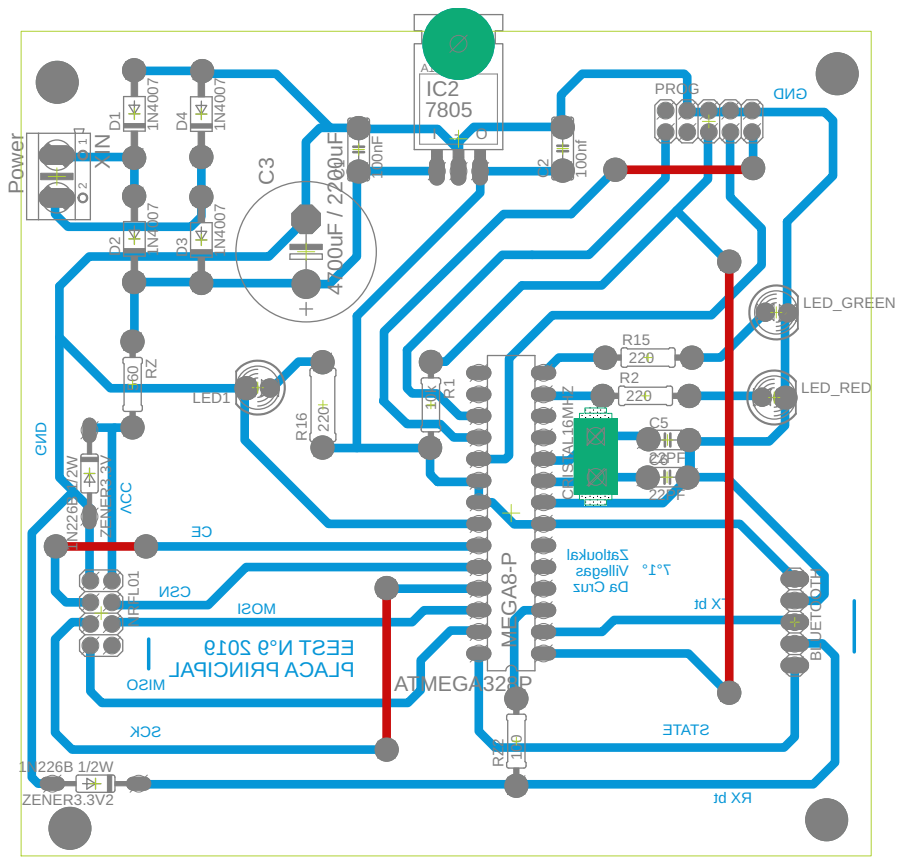
[picture p67: page 3]
ATMEGA328P C³; C6 CRISTAL16MHZ D¹ D²; LED1; LED_GREEN; LED_RED NRFL01; PROG R¹; R15 R¹⁶ RZ; R2 XIN ZENER³.3V; ZENER3.3V2; BLUETOOTH MEGA⁸⁻P ¹⁰⁰nF; 22PF ¹N⁴⁰⁰⁷ 1N⁴⁰⁰⁷; 1N⁴⁰⁰⁷ ¹N⁴⁰⁰⁷; 220 ⁵⁶⁰ Power; 1N²²⁶B ¹/2W

IC2

### PROG R¹

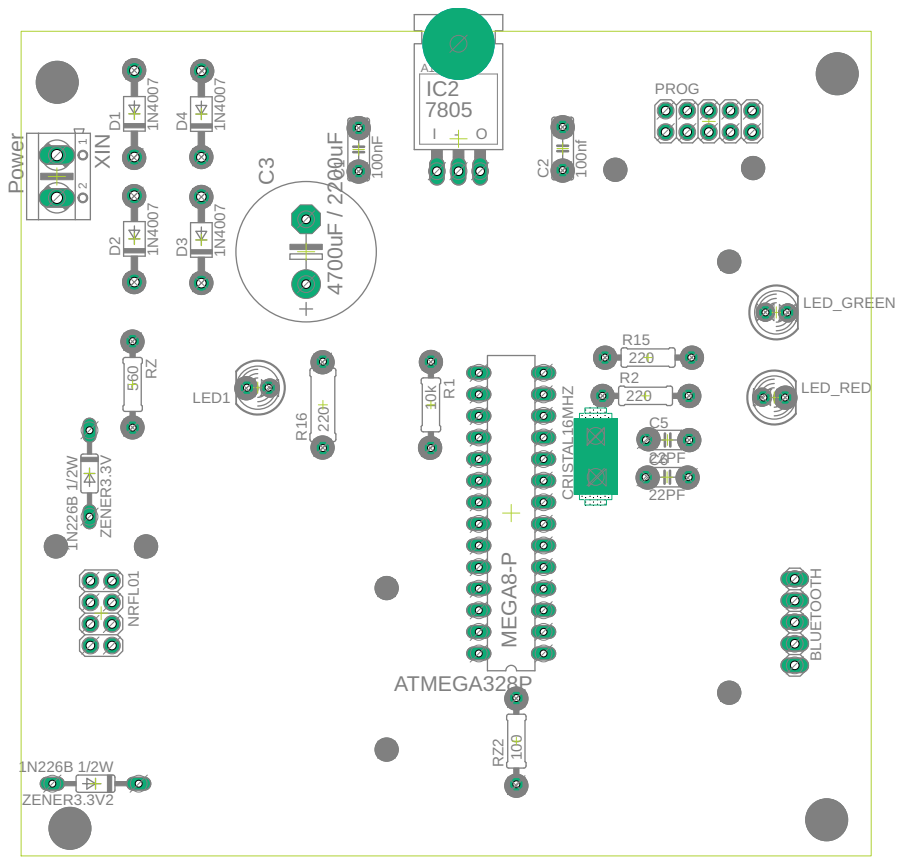
[picture p68: page 4]
ATMEGA328P C³; C6 CRISTAL16MHZ D¹ D²; LED1; LED_GREEN; LED_RED NRFL01; R15 R¹⁶ RZ; R2 XIN ZENER³.3V; ZENER3.3V2; BLUETOOTH MEGA⁸⁻P ¹⁰⁰nF; 22PF ¹N⁴⁰⁰⁷ 1N⁴⁰⁰⁷; 1N⁴⁰⁰⁷ ¹N⁴⁰⁰⁷; 220 ⁵⁶⁰ Power; 1N²²⁶B ¹/2W

I | - | O

IC2

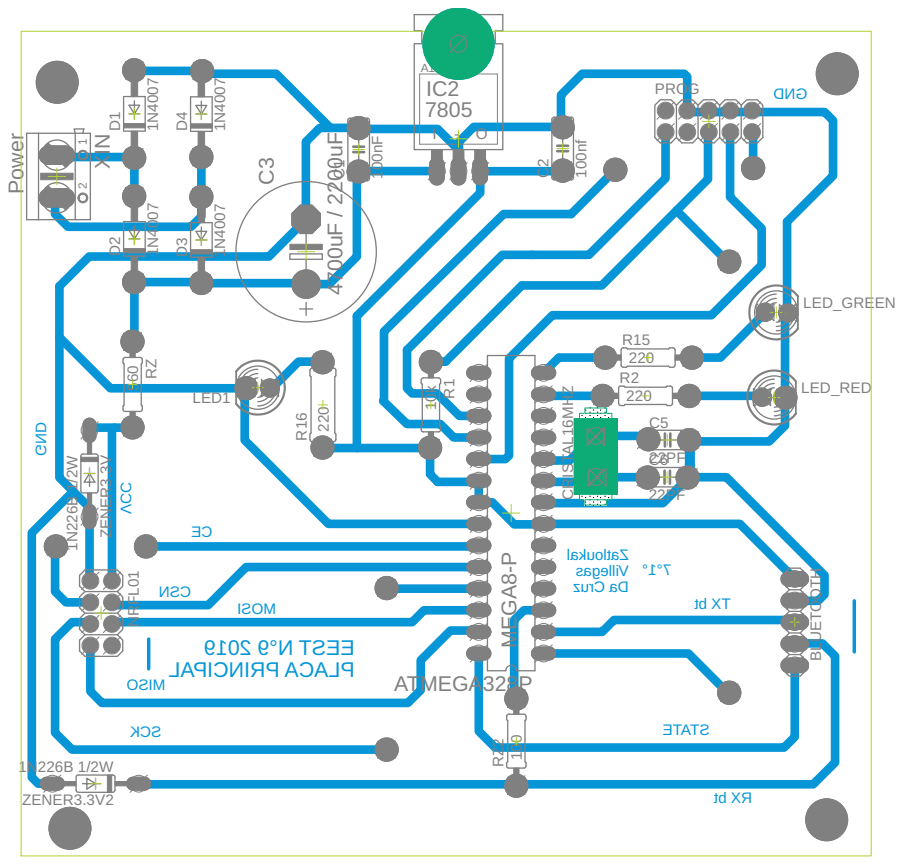
[picture p69: page 5]
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

IC2

### PROG R¹

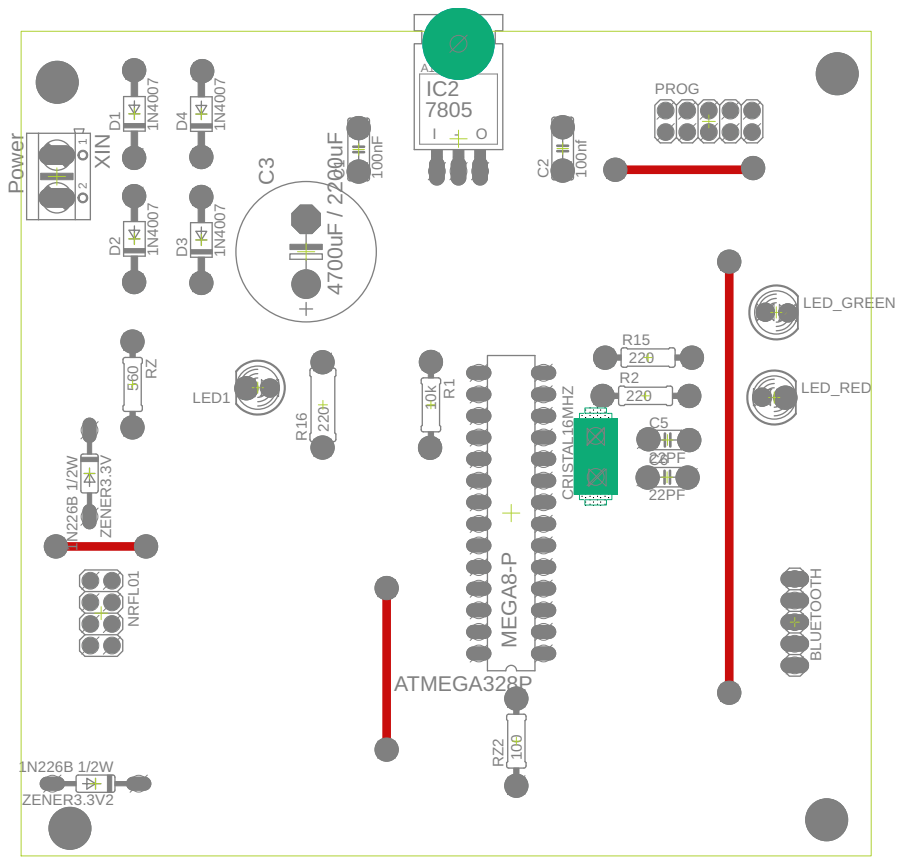
[picture p70: page 6]
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

# ·Circuito impreso: Módulo de mandos de potencia

Lista de componentes | Candad Precio x unidad
Capacitores ceramicos | 5 | $ 2.50
Capacitor electrolico | 1 | $ 10
Resistencias de 1/4 w | 13 | $ 1.50
Cristal de 16Mhz | 1 | $ 30
Leds de 5mm | 7 | $ 4.50
Diodos | 8 | $ 2.50
Diodo zener de 1/2 w | 1 | $ 6
Borneras | 4 | $ 15
Reguladores de tensión | 5 | $ 25
Modulo de radiofrecuencia emisor/receptor | 1 | $ 100
Microcontrolador atmega 328p | 1 | $ 250
Relays | 1 | $ 40
Tira de 20 pinhead | 1 | $ 15
Zocalo 14x2 | 1 | $ 60
Plaqueta virgen de 20x10 | 1 | $ 150
Transistores | 4 | $ 40
| Total | $ 1,089.50

# G5LE ⁴⁷⁰ GND

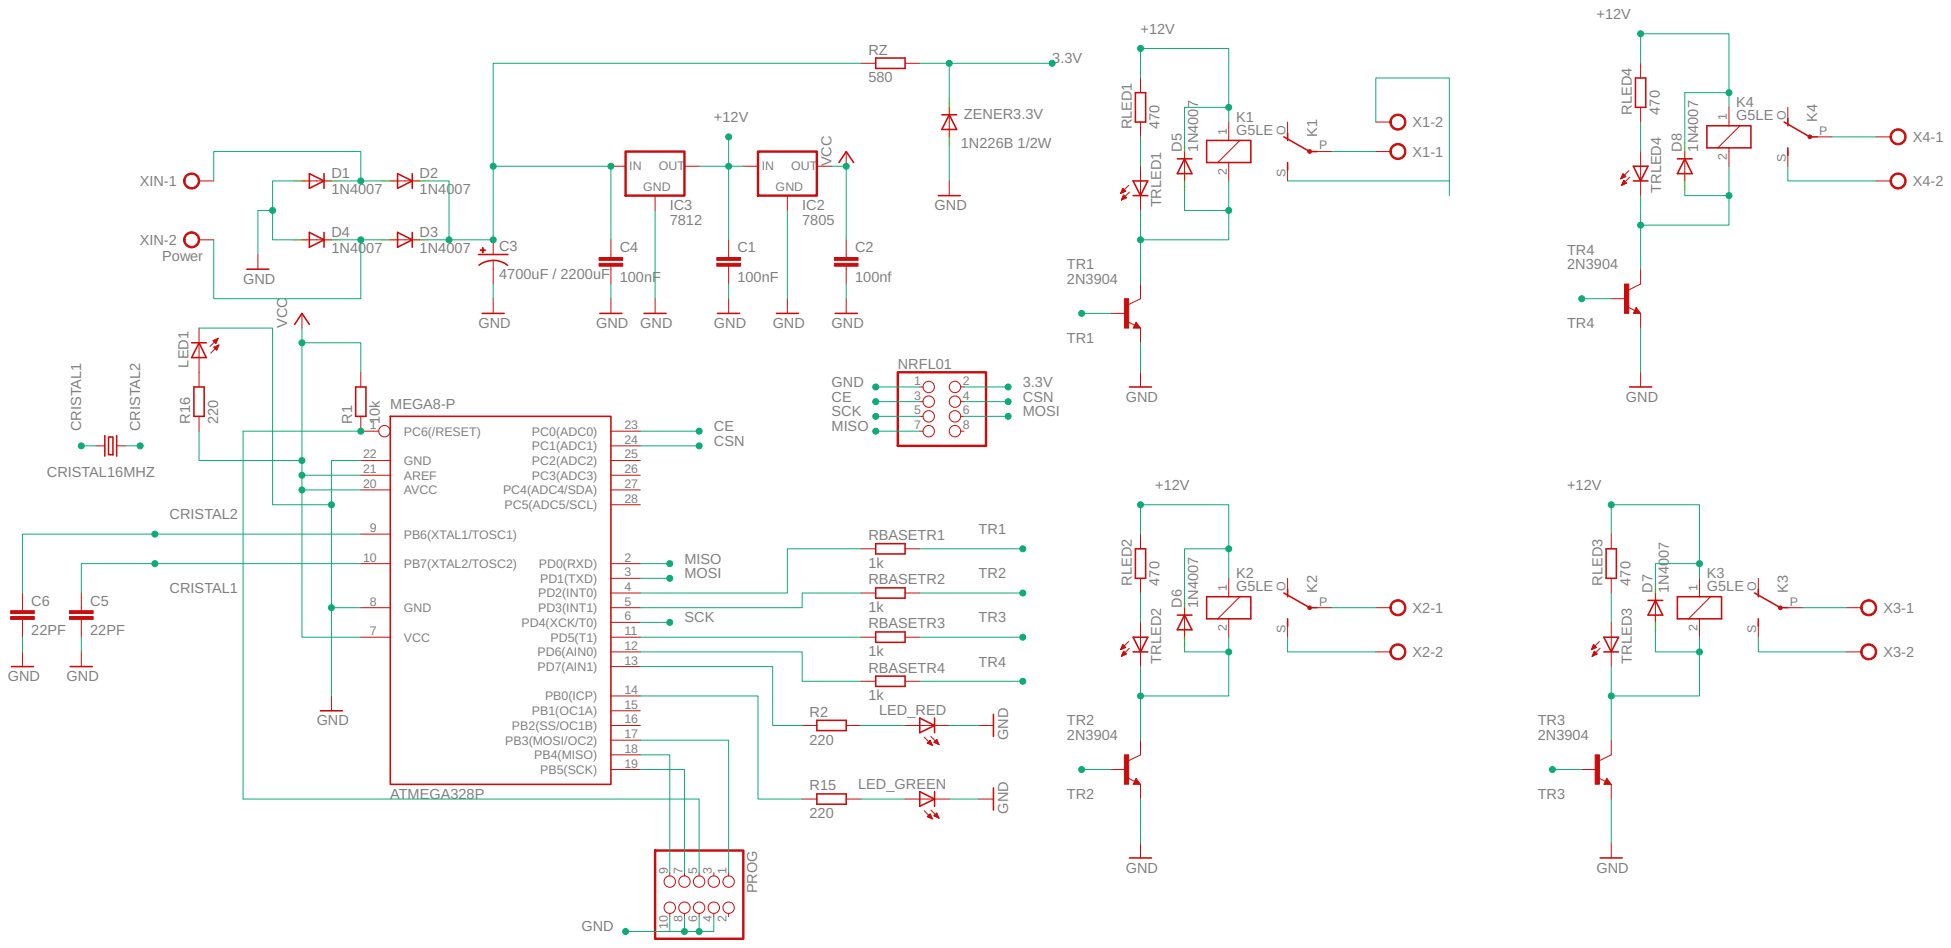
[picture p71: page 8]

X3 | TR⁴ | K⁴
X4

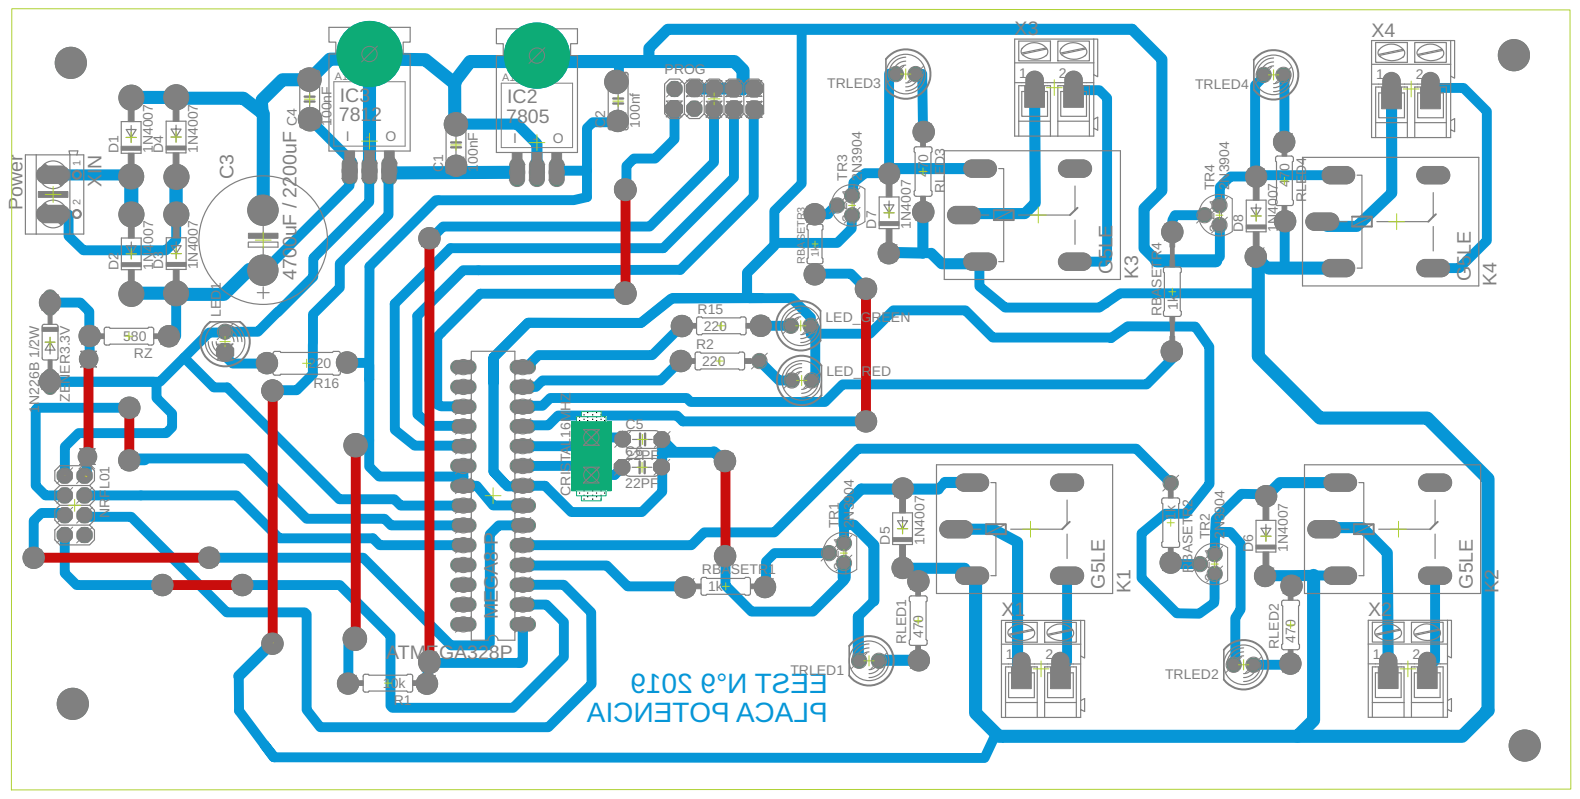
[picture p72: page 9]

X3 | TR⁴ | K⁴
X4

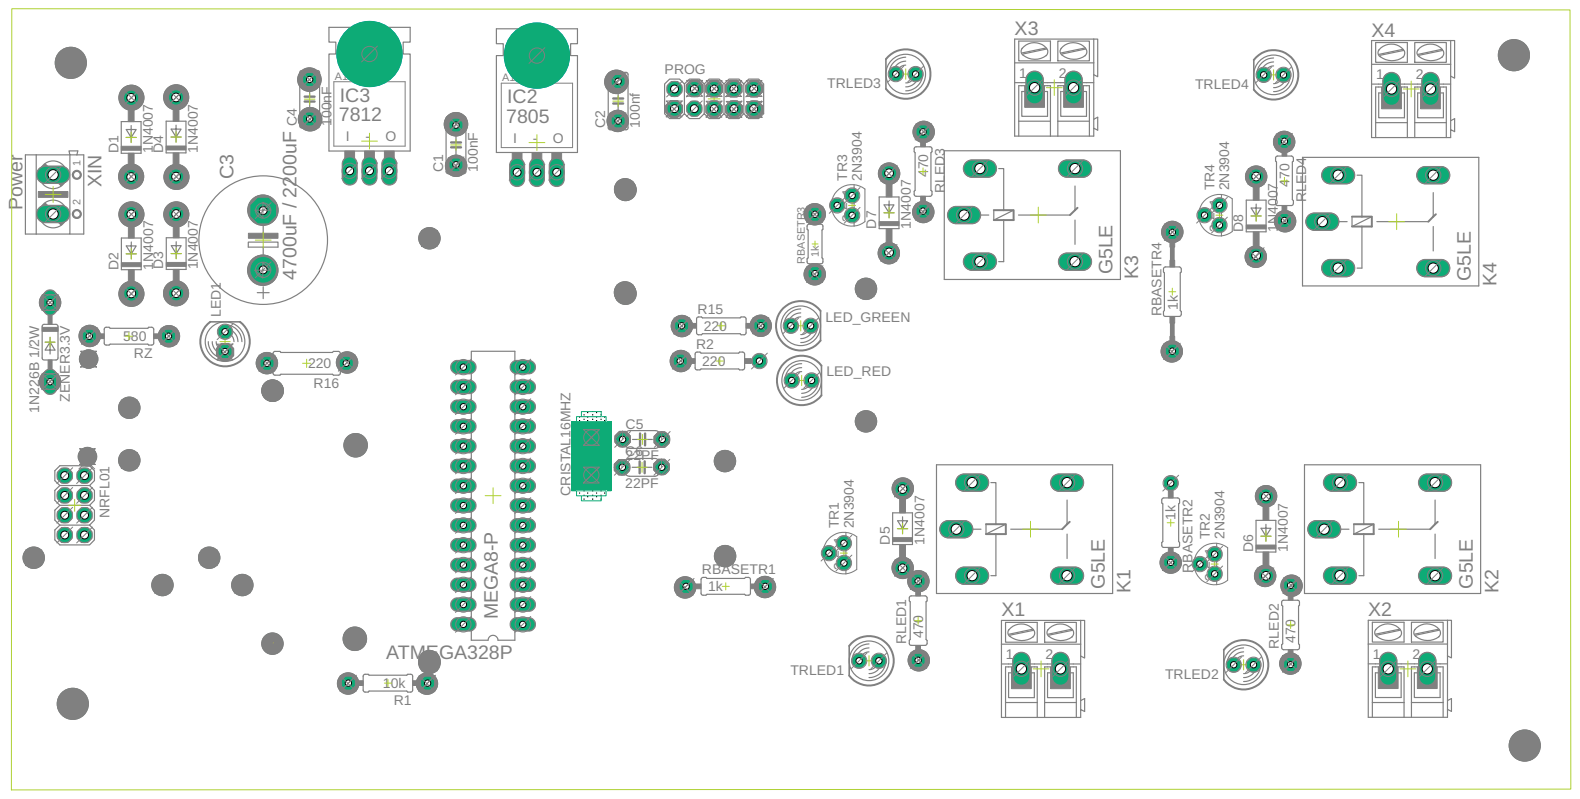
[picture p73: page 10]

X3 | TR⁴ | K⁴
X4

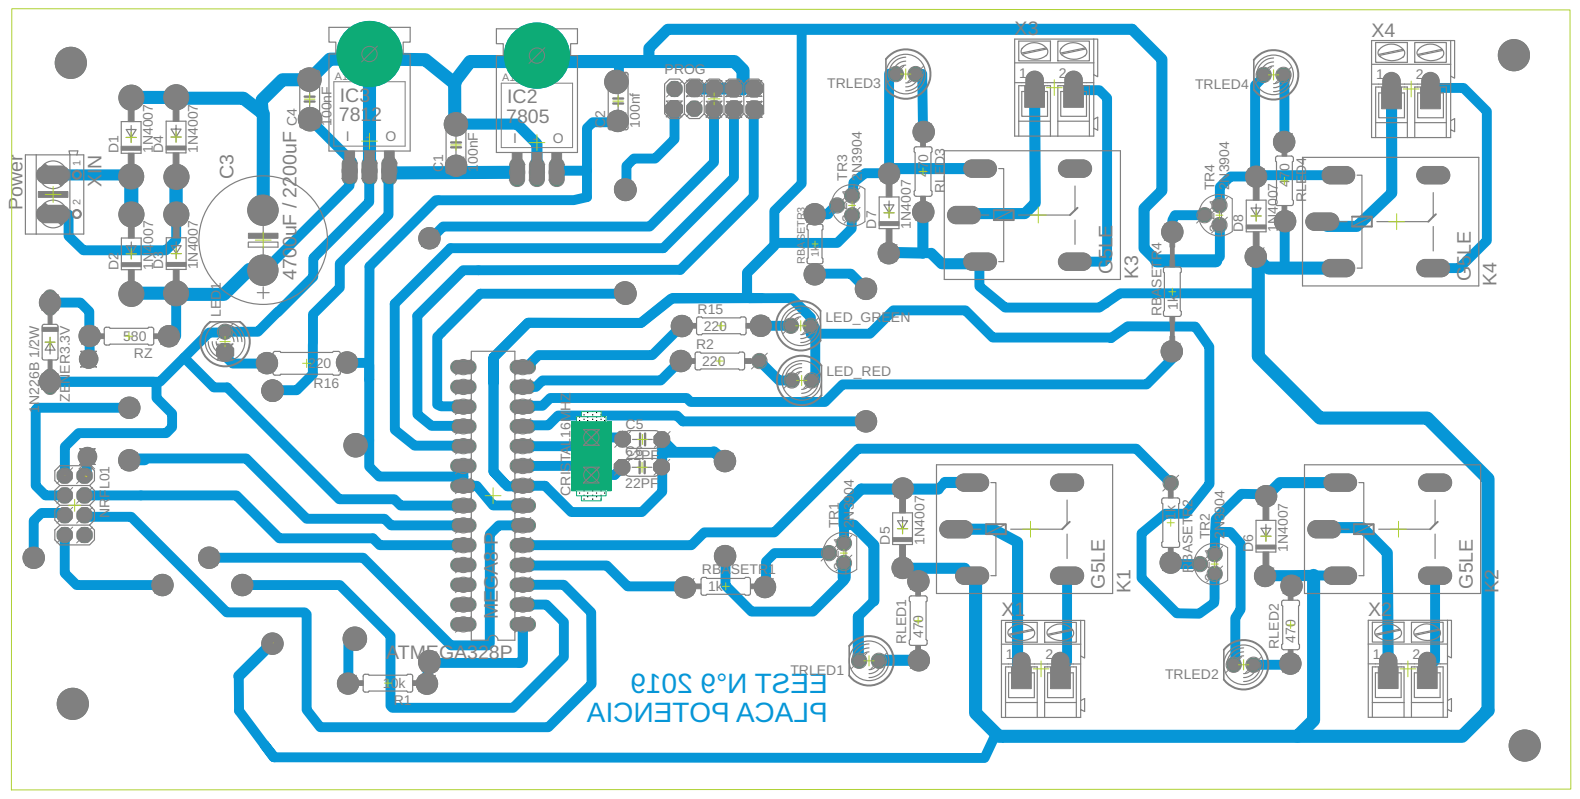
[picture p74: page 11]

X3 | TR⁴ | K⁴
X4

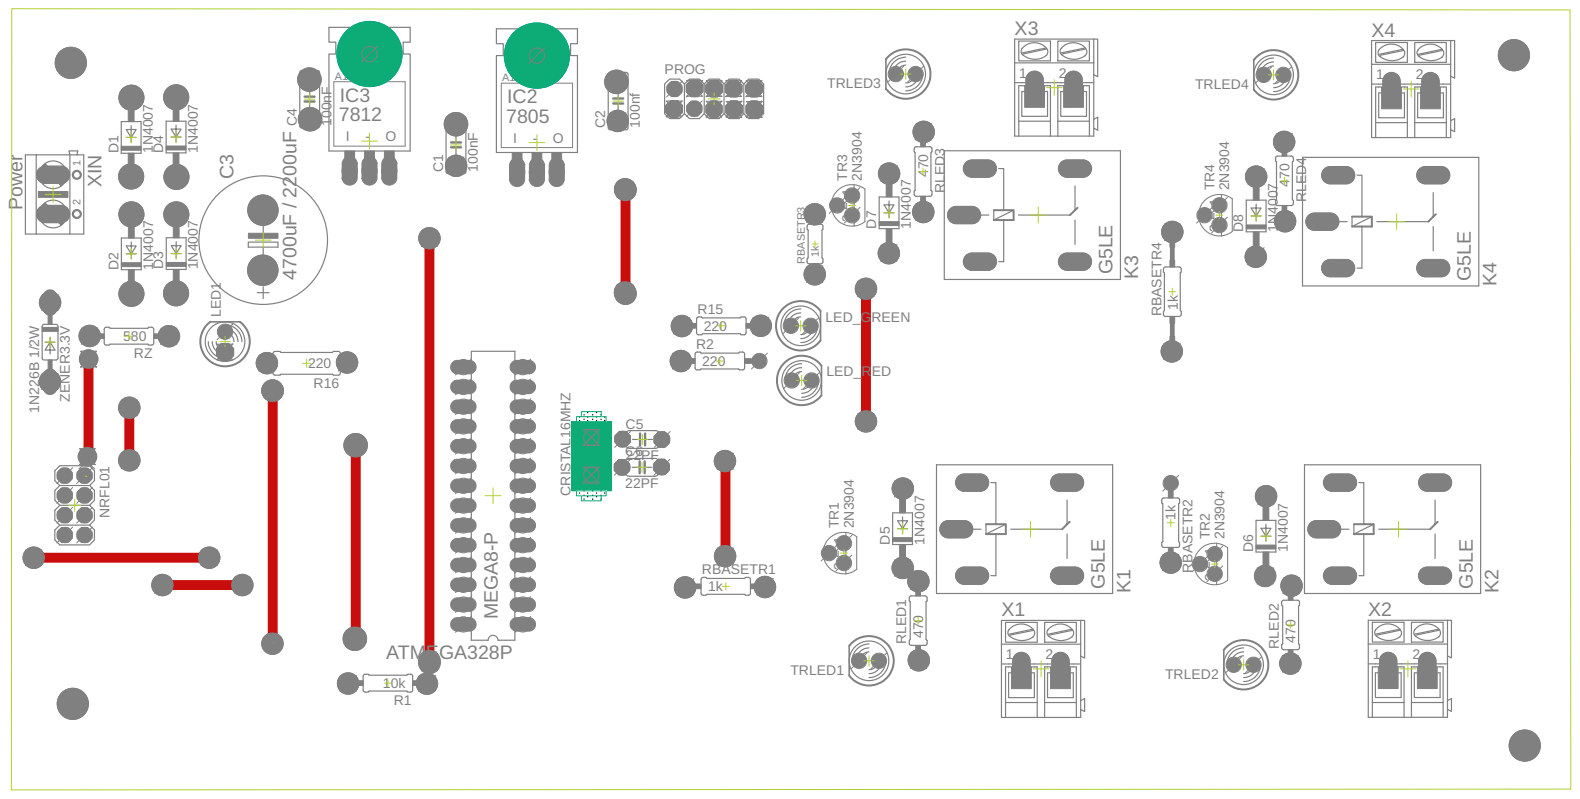
[picture p75: page 12]

# ·Circuito impreso: Módulo de mandos motrices

Lista de componentes | Candad | Precio x unidad
Capacitores ceramicos | 3 | $ 2.50
Resistencias de 1/4 w | 7 | $ 1.50
Leds de 5mm | 3 | $ 4.50
Diodos zener de 1/2 w | 2 | $ 6
Cristal de 16Mhz | 1 | $ 30
Microcontrolador Atmega 328p | 1 | $ 250
Modulo de radiofrecuencia emisor/receptor | 1 | $ 100
Zocalo 14x2 | 1 | $ 60
ULN2803 | 1 | $ 60
Zocalo 18x2 | 1 | $ 60
Tira de 32 pinhead | 1 | $ 15
Borneras | 1 | $ 15
Transistor | 1 | $ 40
Plaqueta virgen de 10x10 | 1 | $ 90.00
| Total | $ 763.50

## Power

100 1W


SpiceOrder 1 SpiceOrder 2
ZENER5.1V1

# PROG R¹

ULN2803 XIN | ZENER⁵.1V¹ | ZENER³.3V | Q¹


# PROG R¹

ULN2803 XIN | ZENER⁵.1V¹ | ZENER³.3V | Q¹


# PROG R¹

ULN2803 XIN | ZENER⁵.1V¹ | ZENER³.3V | Q¹


# PROG R¹

ULN2803 XIN | ZENER⁵.1V¹ | ZENER³.3V | Q¹
