julian-zatloukal/SAPLM/PCBs/Placa principal/PDF/Placa principal - Todo.pdf

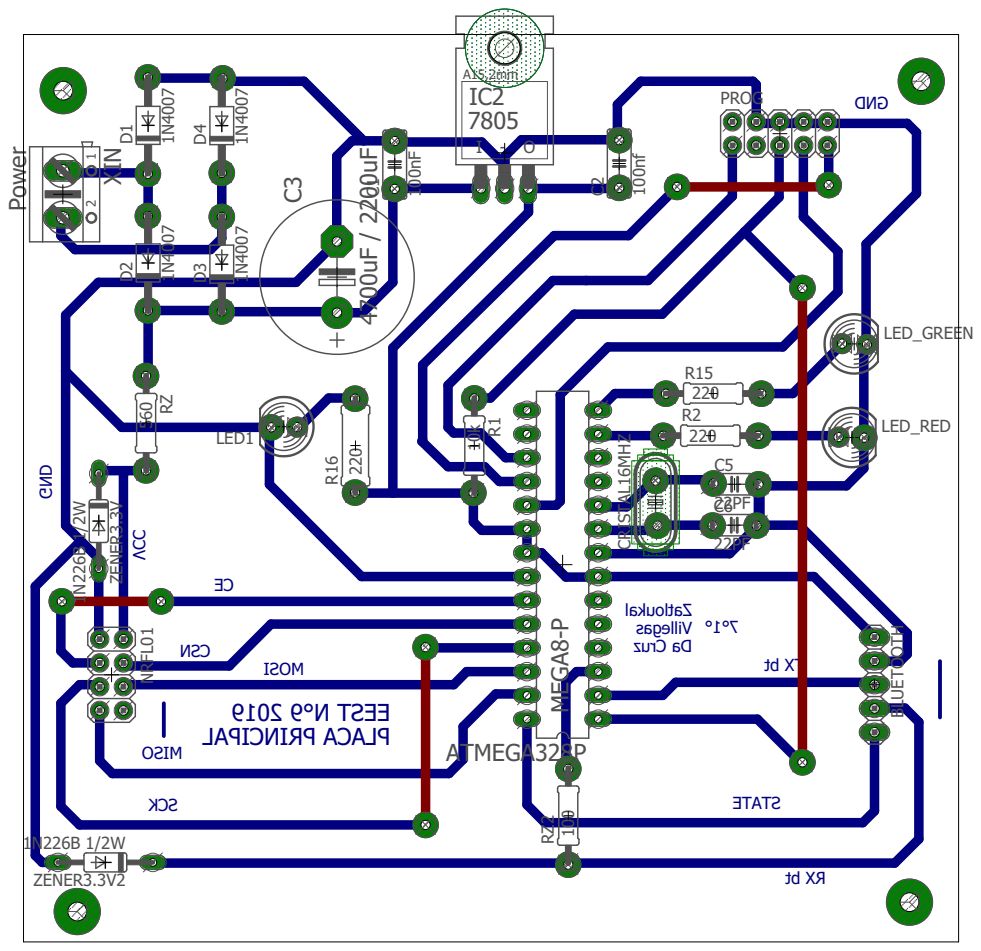
[picture p80: page 1]
