julian-zatloukal/SAPLM/Documentacion/Informe ACTE/caratura.pdf

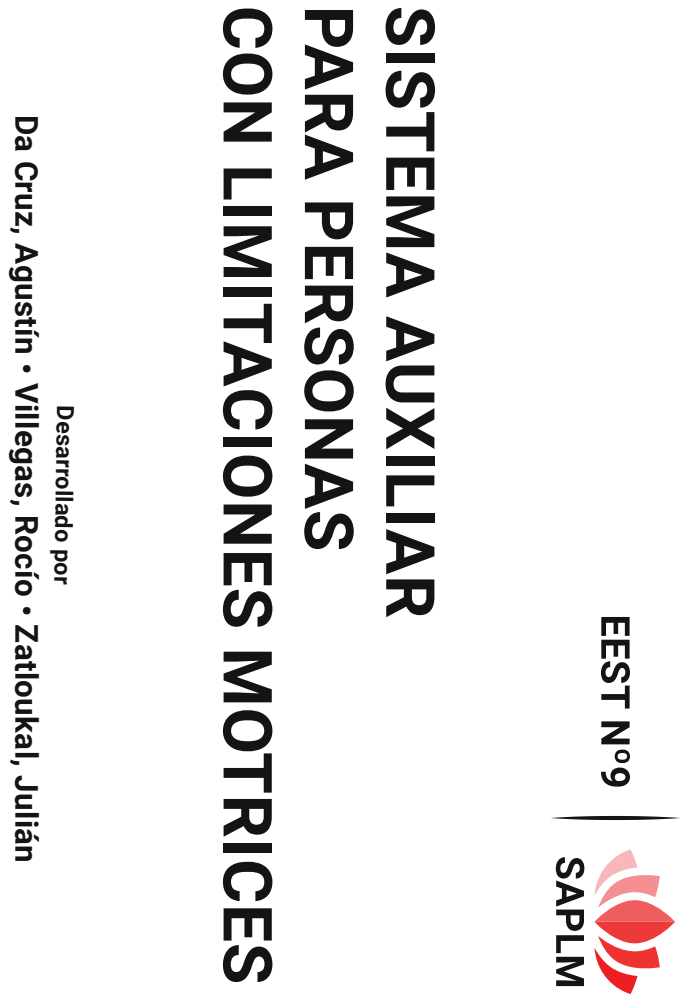
[picture p81: page 1]
Desarrollado por

Da Cruz, Agustín • Villegas, Rocío • Zatloukal, Julián
