julian-zatloukal/SAPLM/Documentacion/Informe escolar/ComposeMessageToBuffer (2).pdf

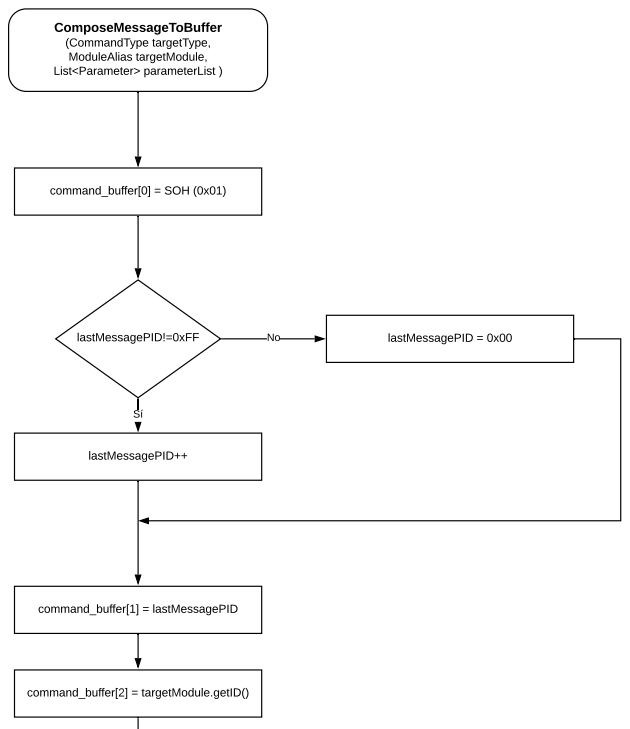
[picture p82: page 1]
command_buffer[0] = SOH (0x01); command_buffer[1] = lastMessagePID; lastMessagePID!=0xFF; lastMessagePID = 0x00; lastMessagePID++; command_buffer[2] = targetModule.getID()

ComposeMessageToBuffer
(CommandType targetType, ModuleAlias targetModule,

List<Parameter> parameterList )

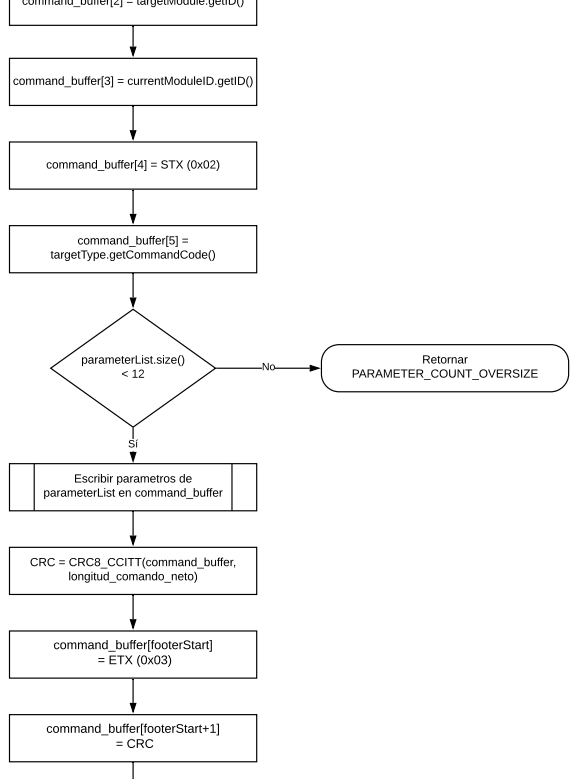
[picture p83: page 2]
command_buffer[2] = targetModule.getID(); command_buffer[3] = currentModuleID.getID(); command_buffer[4] = STX (0x02); command_buffer[5] = targetType.getCommandCode(); parameterList.size() < 12; Retornar PARAMETER_COUNT_OVERSIZE; CRC = CRC8_CCITT(command_buffer, longitud_comando_neto); command_buffer[footerStart] = ETX (0x03); command_buffer[footerStart+1] = CRC

Escribir parametros de
parameterList en command_buffer

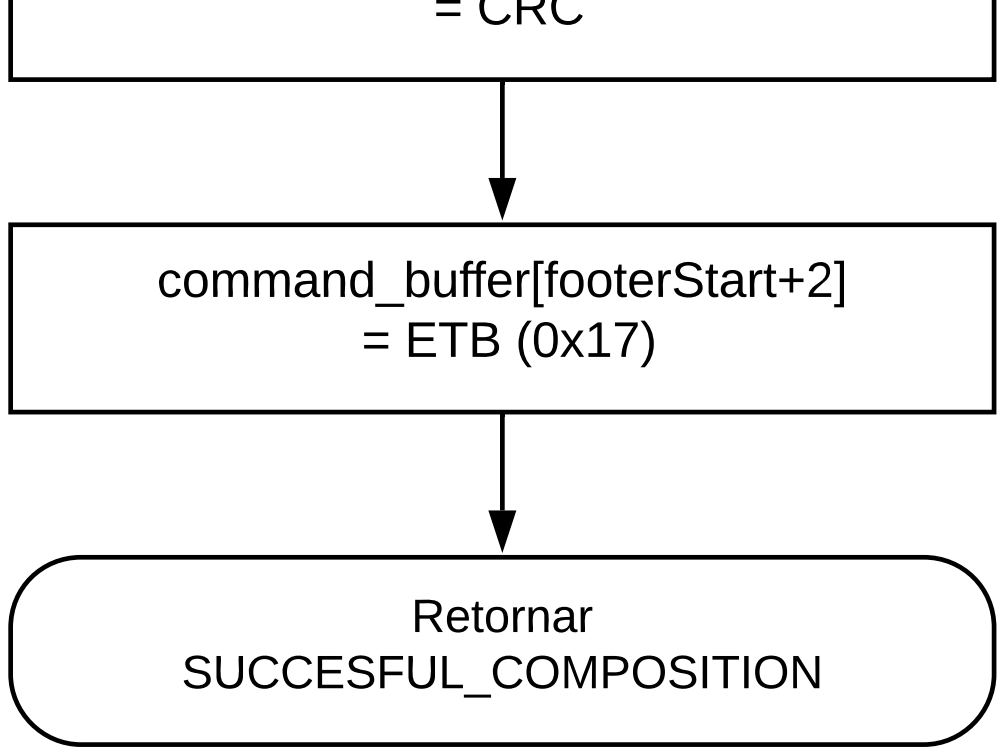
[picture p84: page 3]
= CRC; command_buffer[footerStart+2] = ETB (0x17); Retornar SUCCESFUL_COMPOSITION
