julian-zatloukal/SAPLM/Documentacion/Informe escolar/Cover page.pdf

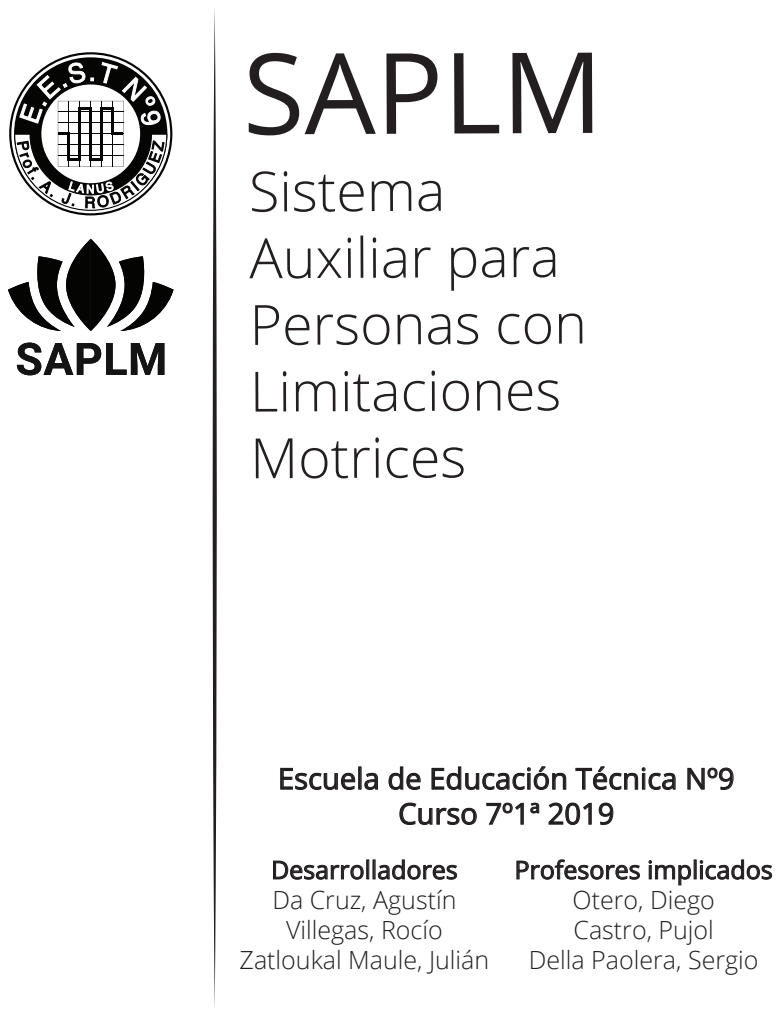
[picture p85: page 1]
Curso 7º1ª 2019

Escuela de Educación Técnica Nº9

Desarrolladores
Da Cruz, Agustín
Villegas, Rocío
Zatloukal Maule, Julián

Profesores implicados
Otero, Diego
Castro, Pujol
Della Paolera, Sergio
