julian-zatloukal/SAPLM/Documentacion/Informe escolar/DecomposeCommand (2).pdf

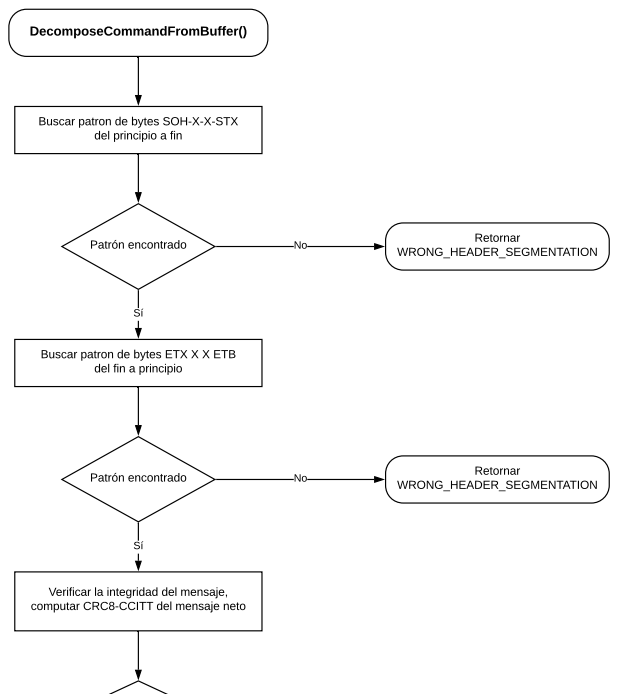
[picture p86: page 1]
DecomposeCommandFromBuffer(); Patrón encontrado; Retornar; WRONG_HEADER_SEGMENTATION; Retornar WRONG_HEADER_SEGMENTATION

Buscar patron de bytes SOH-X-X-STX

del principio a fin

Buscar patron de bytes ETX X X ETB

del fin a principio

Verificar la integridad del mensaje,
computar CRC8-CCITT del mensaje neto

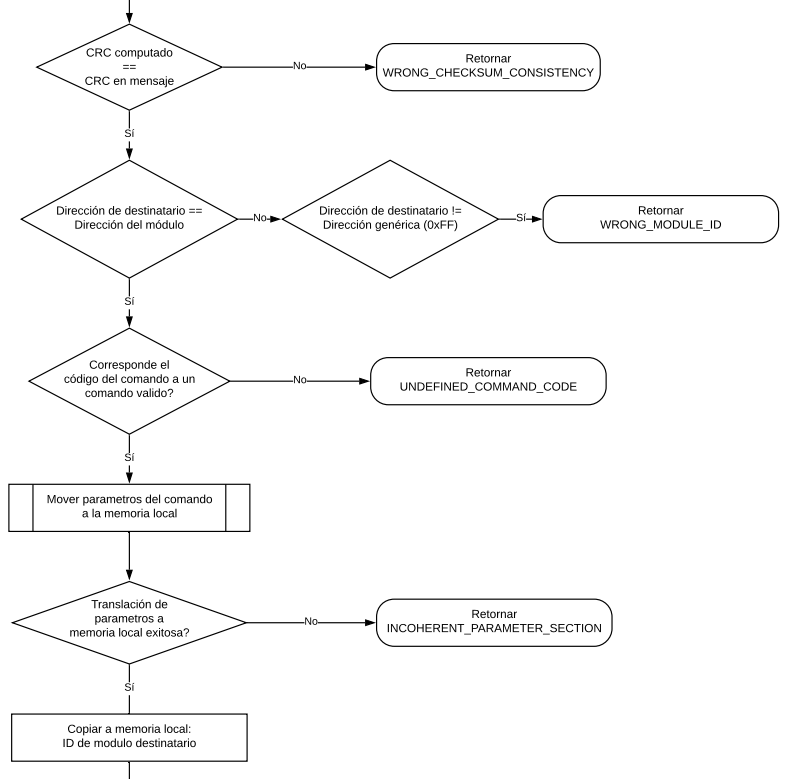
[picture p87: page 2]
Retornar INCOHERENT_PARAMETER_SECTION; Retornar WRONG_CHECKSUM_CONSISTENCY; Retornar WRONG_MODULE_ID; Retornar UNDEFINED_COMMAND_CODE

CRC computado
== CRC en mensaje

Dirección de destinatario == Dirección del módulo

Dirección de destinatario != Dirección genérica (0xFF)

Corresponde el
código del comando a un
comando valido?

Mover parametros del comando
a la memoria local

Translación de
parametros a
memoria local exitosa?

Copiar a memoria local:
ID de modulo destinatario

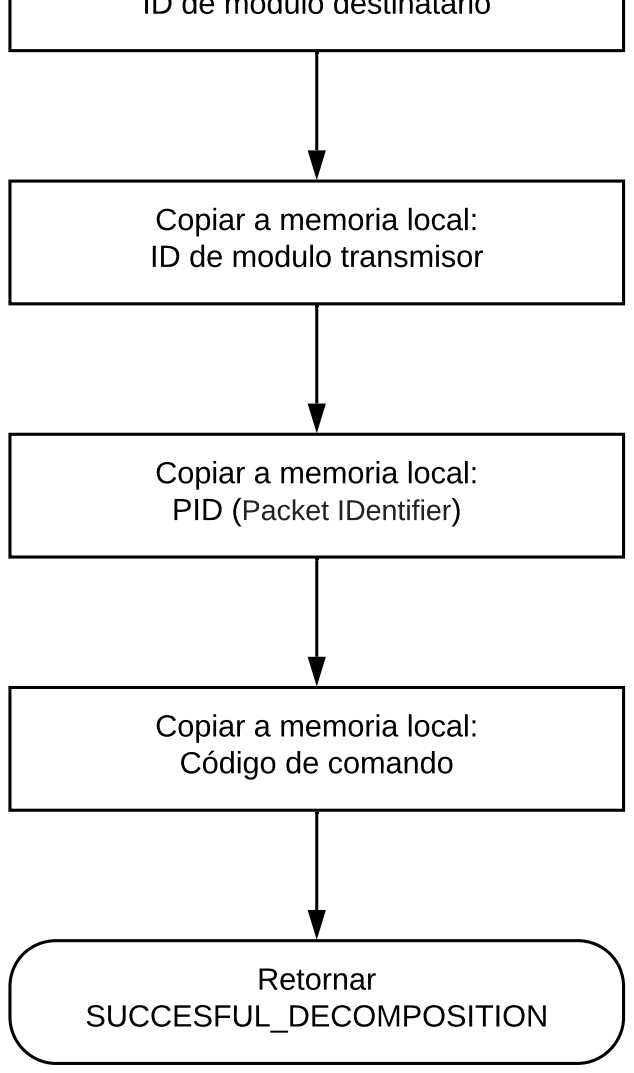
[picture p88: page 3]
Retornar SUCCESFUL_DECOMPOSITION

ID de modulo destinatario

Copiar a memoria local:
ID de modulo transmisor

PID (Packet IDentifier)

Código de comando
