julian-zatloukal/SAPLM/Multimedia/Nueva interfaz/Diseño de interfaz grafica.pdf

### Bluetooth

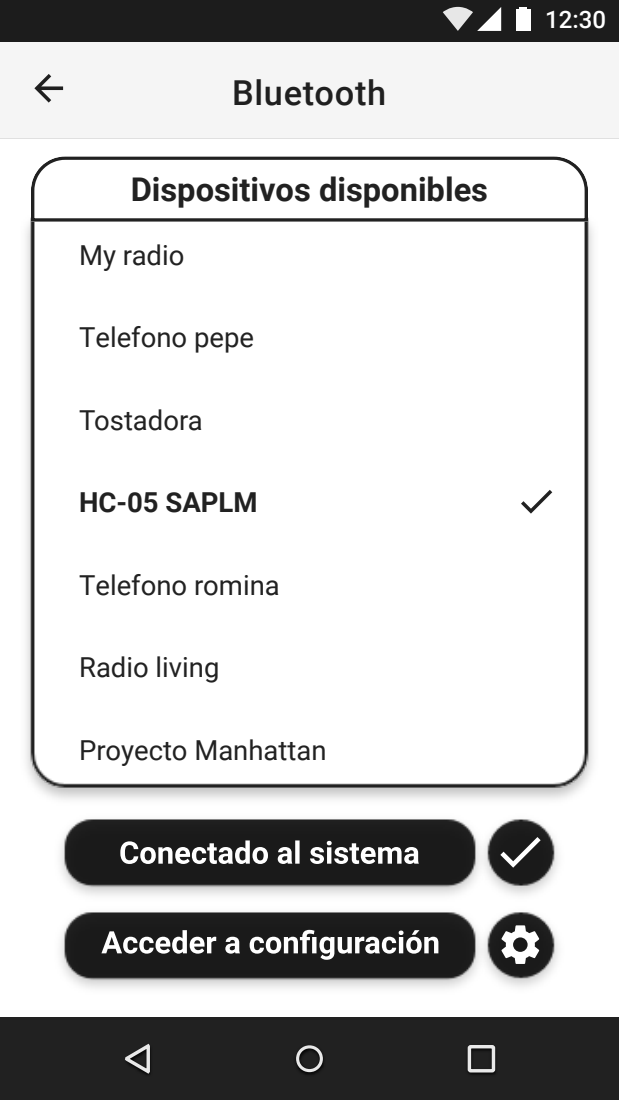
[picture p89: page 1]
My radio; Telefono pepe; Tostadora; Telefono romina; Radio living; Proyecto Manhattan; HC-05 SAPLM; Dispositivos disponibles

### Bluetooth

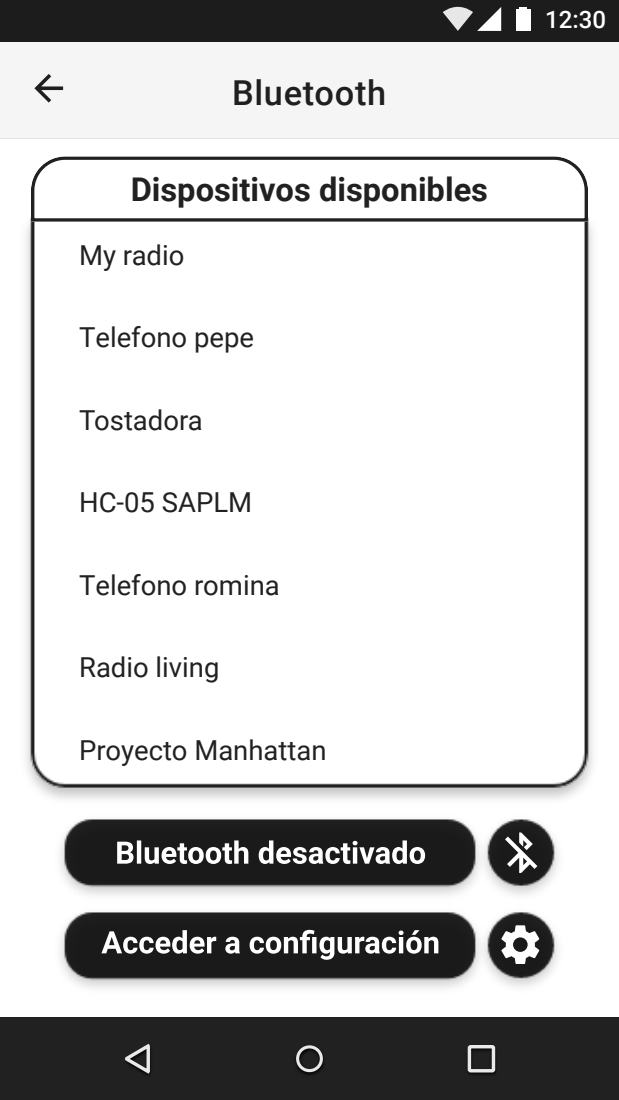
[picture p90: page 2]
My radio; Telefono pepe; Tostadora; Telefono romina; Radio living; Proyecto Manhattan; HC-05 SAPLM; Dispositivos disponibles

### Bluetooth

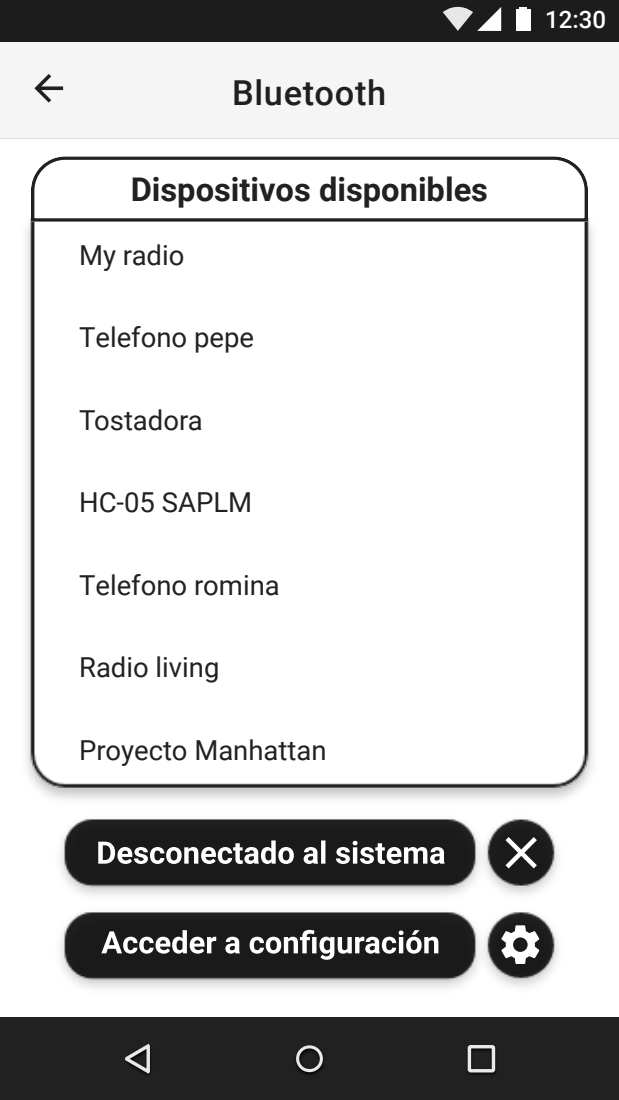
[picture p91: page 3]
My radio; Telefono pepe; Tostadora; Telefono romina; Radio living; Proyecto Manhattan; HC-05 SAPLM; Dispositivos disponibles

### Reconocimiento de voz

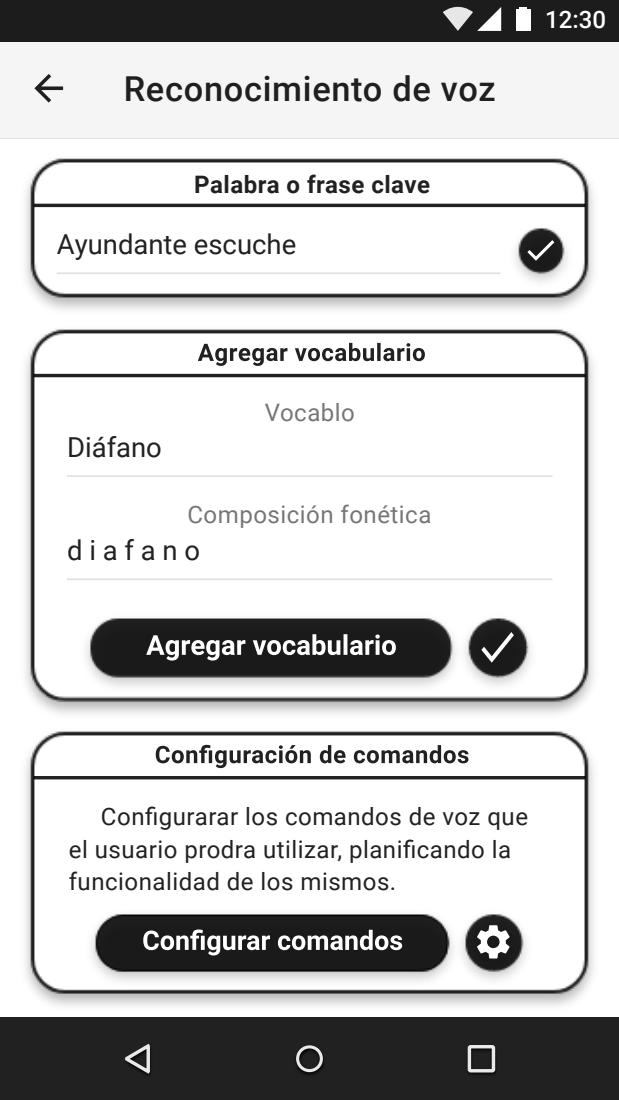
[picture p92: page 4]
Ayundante escuche; Diáfano; Vocablo; Composición fonética

Palabra o frase clave

Configurarar los comandos de voz que
el usuario prodra utilizar, planificando la
funcionalidad de los mismos.
