julian-zatloukal/SAPLM/Documentacion/Informe escolar/LATEX COMPILE/COMPOSE_FLOW_CHART.pdf

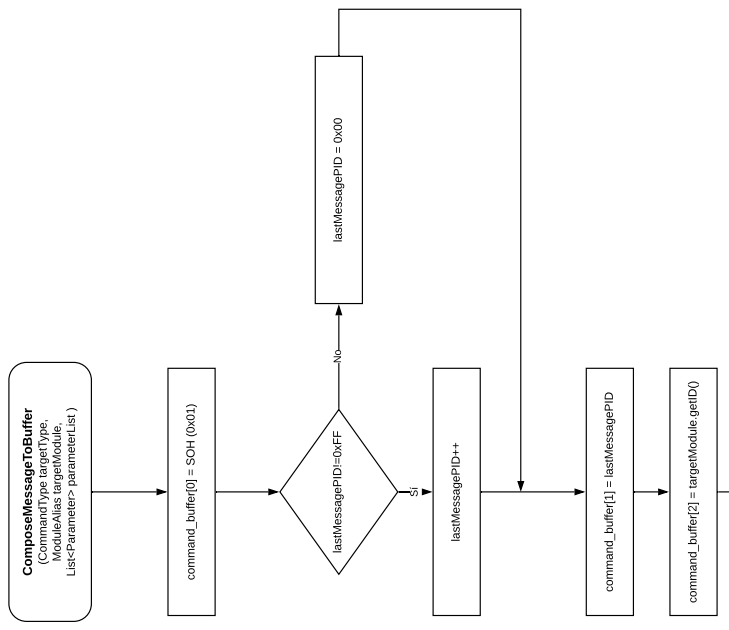
[picture p93: page 1]
ComposeMessageToBuffer; command_buffer[0] = SOH (0x01); command_buffer[1] = lastMessagePID; lastMessagePID!=0xFF lastMessagePID = 0x00; lastMessagePID++; command_buffer[2] = targetModule.getID()

List<Parameter> parameterList )

(CommandType targetType, ModuleAlias targetModule,

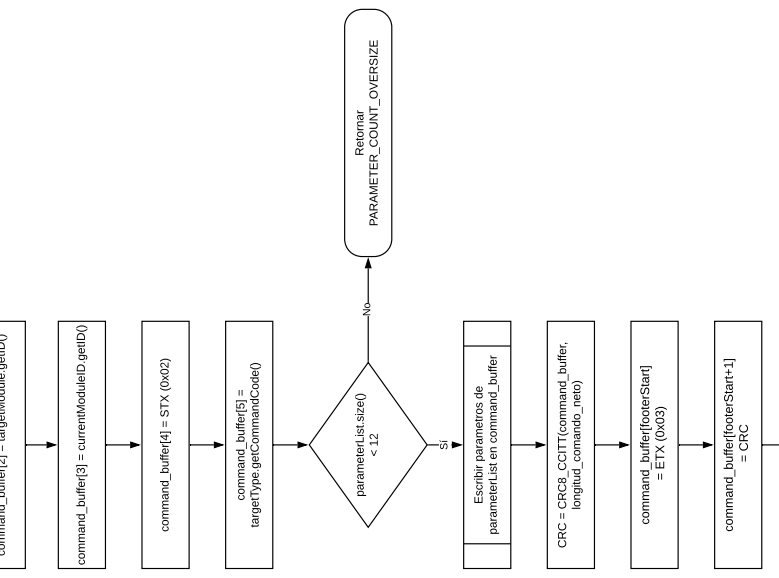
[picture p94: page 2]
command_buffer[2] = targetModule.getID(); command_buffer[3] = currentModuleID.getID(); command_buffer[4] = STX (0x02); command_buffer[5] =; targetType.getCommandCode(); parameterList.size(); Retornar; PARAMETER_COUNT_OVERSIZE; parameterList en command_buffer; CRC = CRC8_CCITT(command_buffer,; longitud_comando_neto); command_buffer[footerStart]; = ETX (0x03); command_buffer[footerStart+1]; = CRC

Escribir parametros de

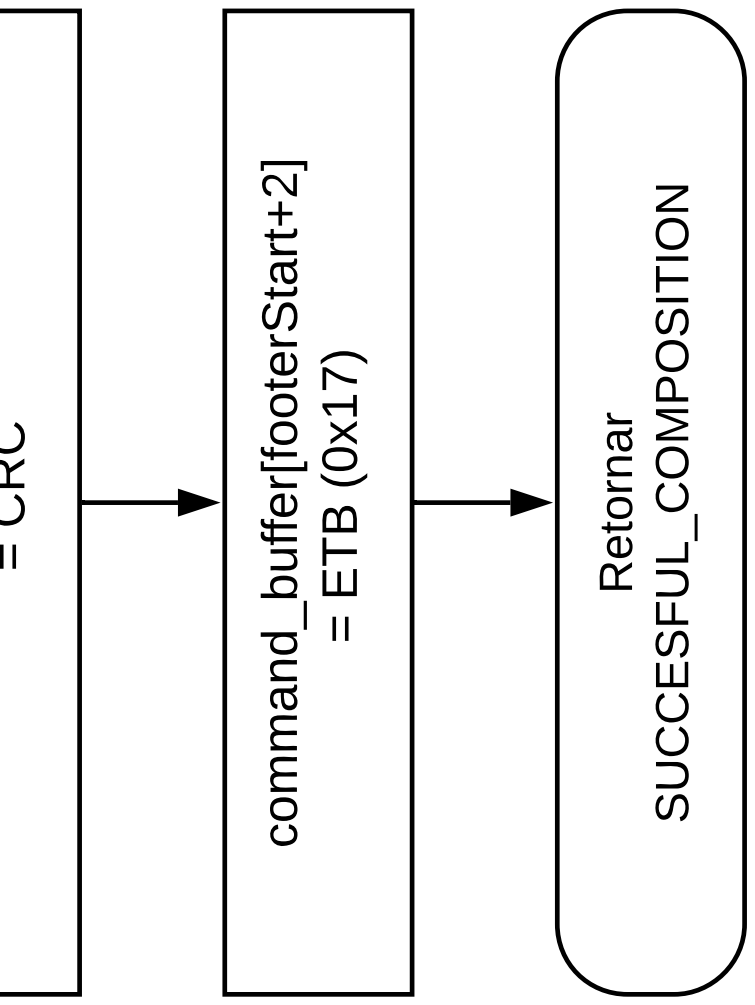
[picture p95: page 3]
= CRC; command_buffer[footerStart+2]; = ETB (0x17); Retornar; SUCCESFUL_COMPOSITION
