julian-zatloukal/SAPLM/Documentacion/Informe escolar/LATEX COMPILE/DECOMPOSE_FLOW_CHART.pdf

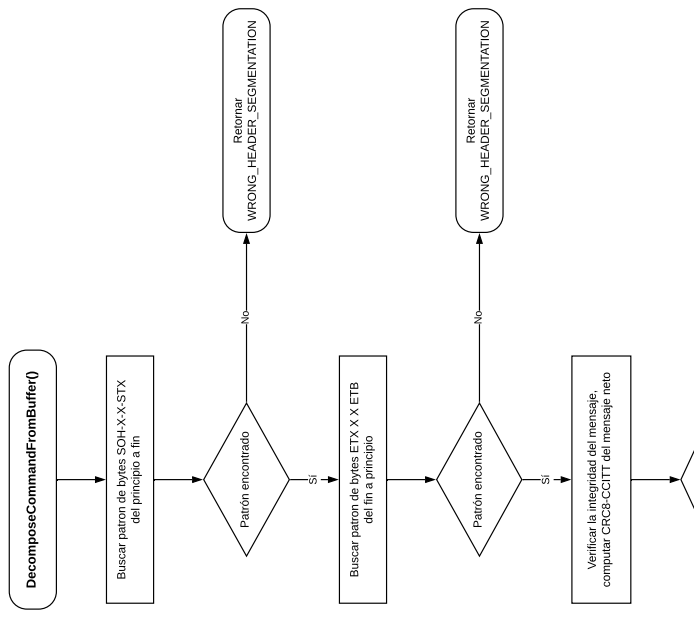
[picture p96: page 1]
DecomposeCommandFromBuffer(); Retornar; WRONG_HEADER_SEGMENTATION; Patrón encontrado

No Patrón encontrado

computar CRC8-CCITT del mensaje neto

Buscar patron de bytes SOH-X-X-STX

Buscar patron de bytes ETX X X ETB

Verificar la integridad del mensaje,

del principio a fin

del fin a principio

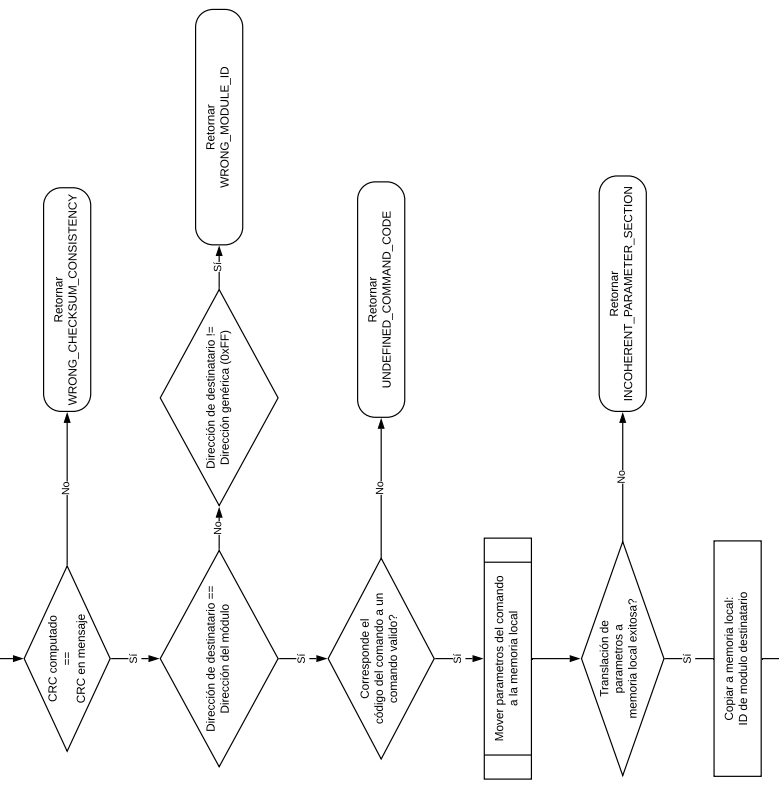
[picture p97: page 2]
Retornar; INCOHERENT_PARAMETER_SECTION; Translación de; parametros a; CRC computado; WRONG_CHECKSUM_CONSISTENCY; WRONG_MODULE_ID; Corresponde el; comando valido?; UNDEFINED_COMMAND_CODE

Dirección de destinatario != Dirección genérica (0xFF)

Mover parametros del comando

Dirección de destinatario == Dirección del módulo

código del comando a un

ID de modulo destinatario

memoria local exitosa?

Copiar a memoria local:

== CRC en mensaje

a la memoria local

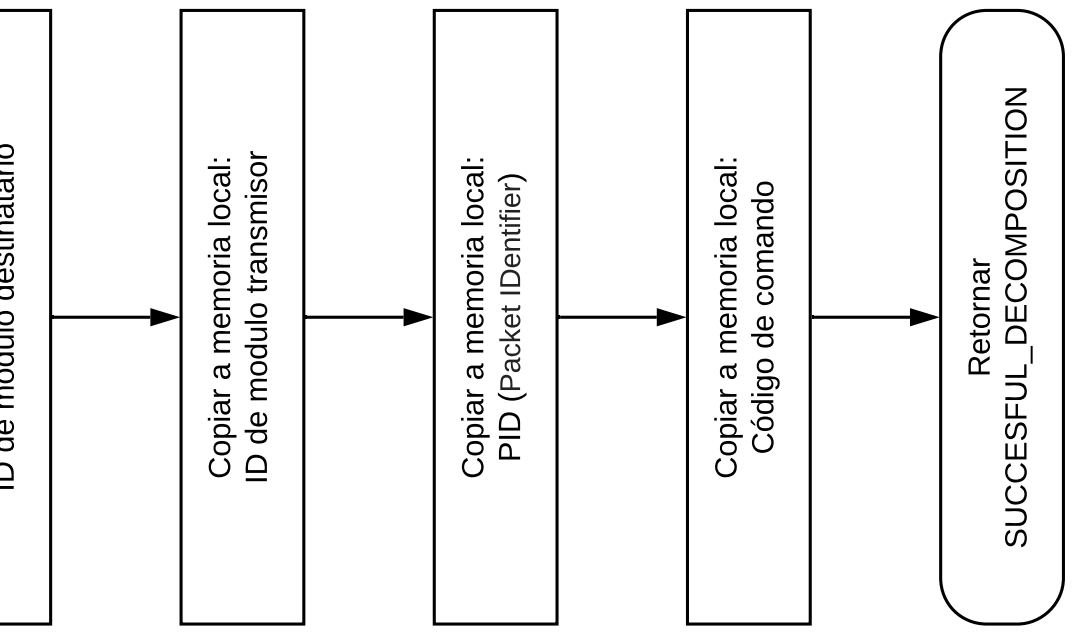
[picture p98: page 3]
Retornar; SUCCESFUL_DECOMPOSITION

ID de modulo destinatario

ID de modulo transmisor

Copiar a memoria local:

PID (Packet IDentifier)

Código de comando
