julian-zatloukal/SAPLM/Documentacion/Informe escolar/LATEX COMPILE/DIAGRAMA_FLUJO_SECOND.pdf

# Diagrama de flujo generico para accionar comando

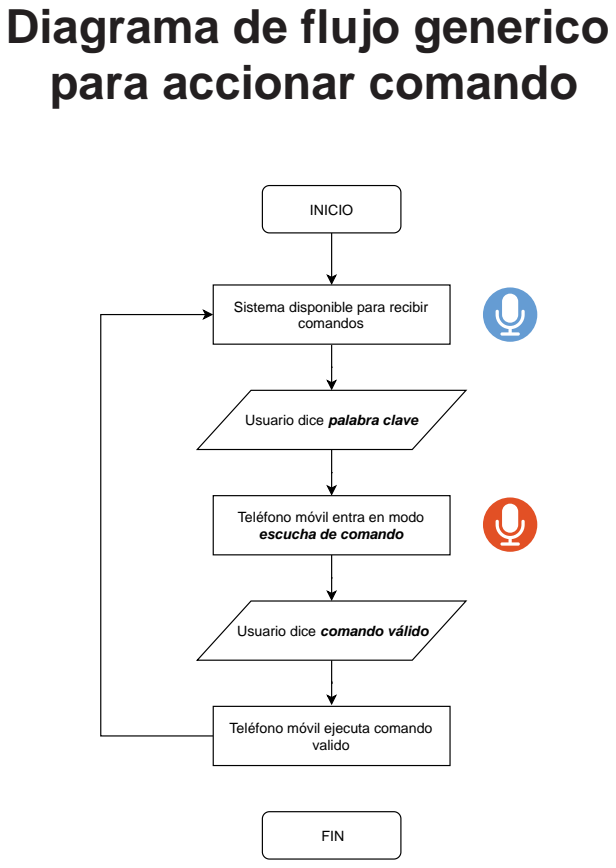
[picture p99: page 1]
INICIO; valido; FIN

Sistema disponible para recibir
comandos

Usuario dice palabra clave

Teléfono móvil entra en modo
escucha de comando

Usuario dice comando válido

Teléfono móvil ejecuta comando
