julian-zatloukal/SAPLM/Documentacion/Informe escolar/PCB/COMPILED_MAIN_BOARD.pdf

PB7(XTAL2/TOSC2) 10
