julian-zatloukal/SAPLM/Documentacion/Informe escolar/PCB/COMPILED_POWER_BOARD.pdf

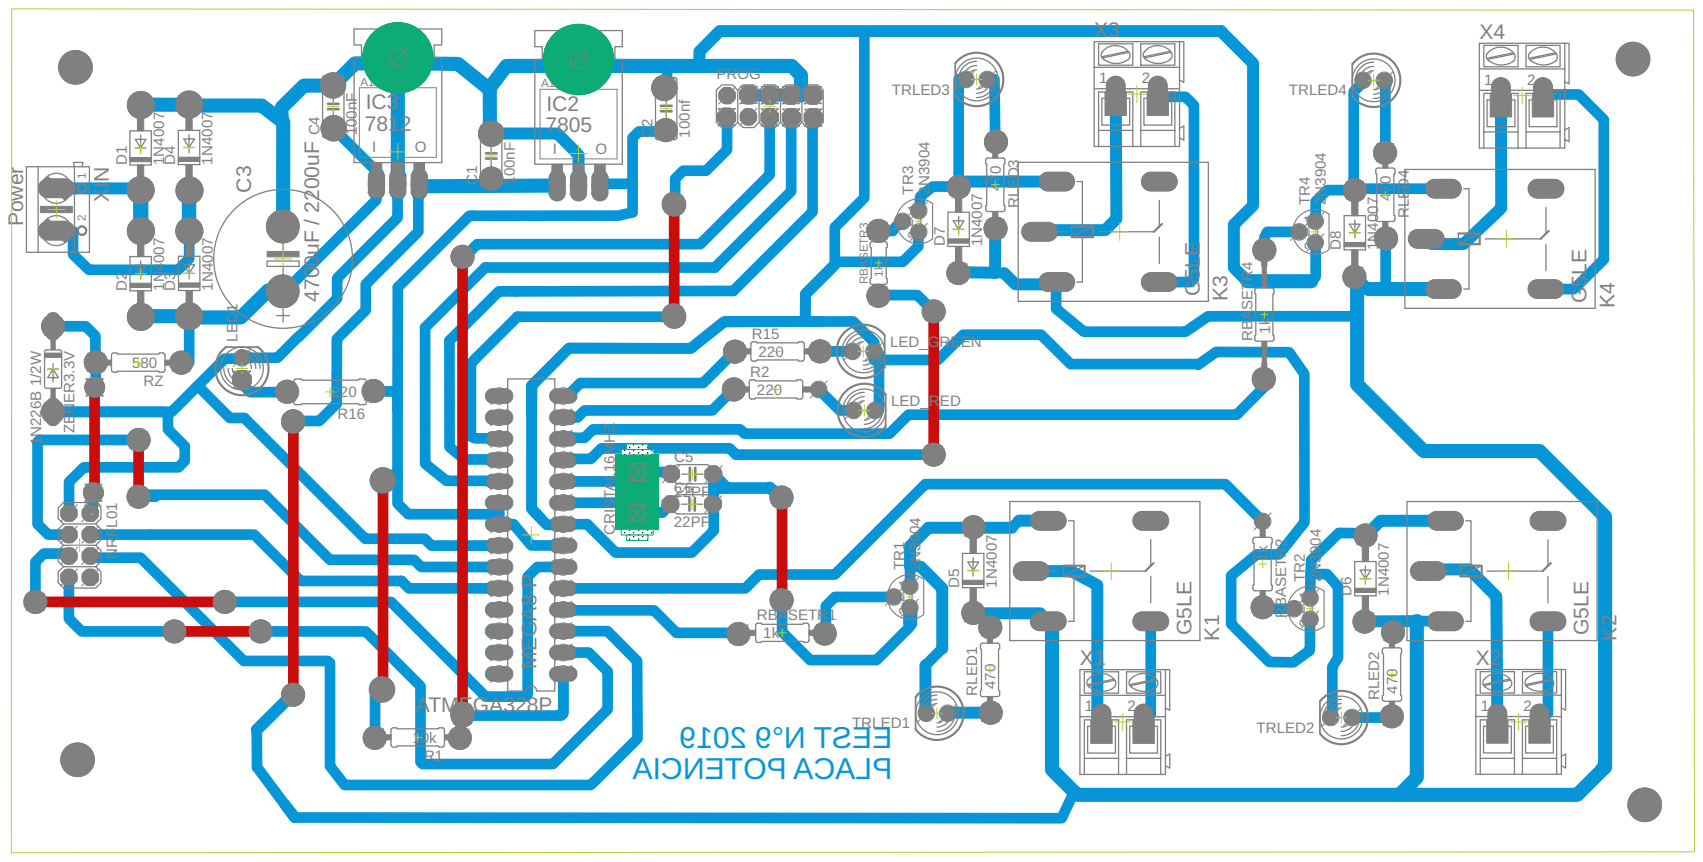
[picture p100: page 2]

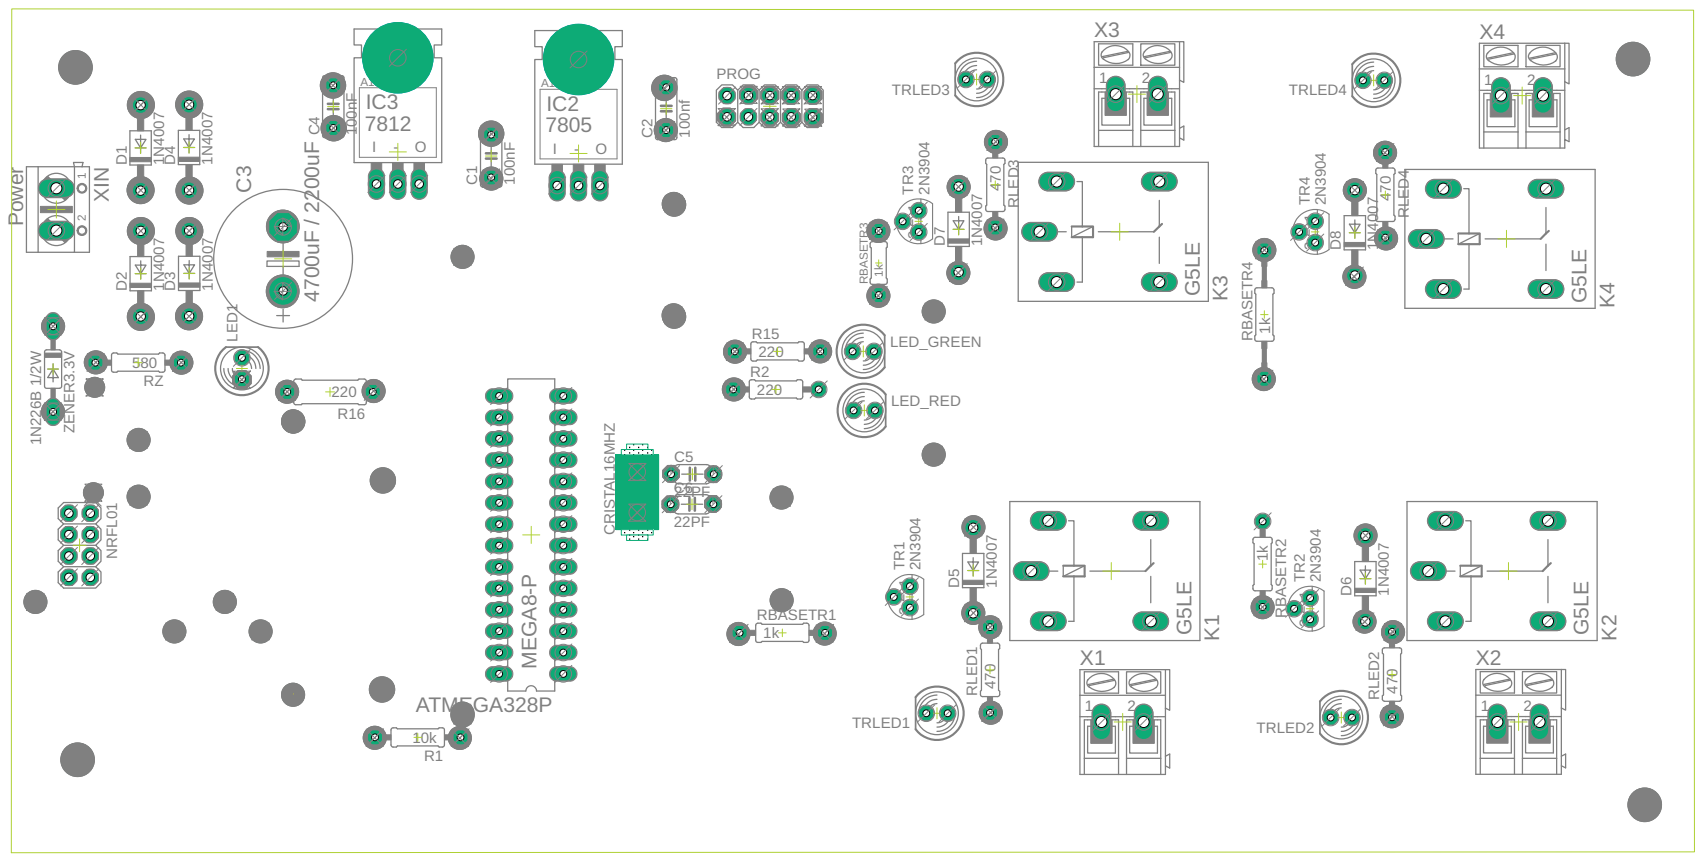
[picture p101: page 3]

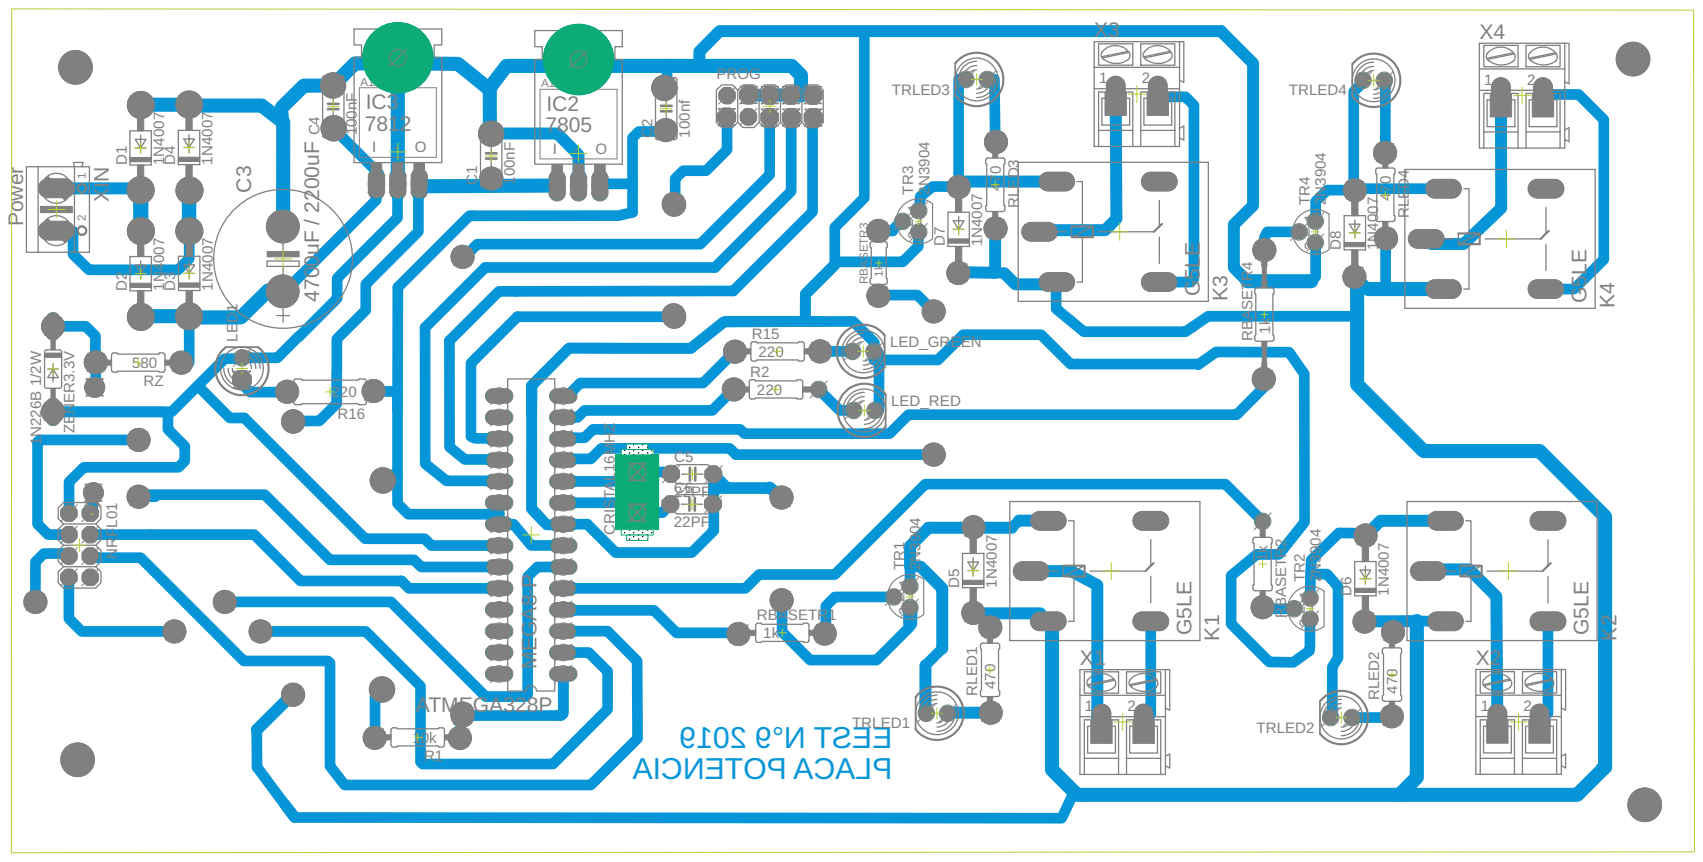
[picture p102: page 4]

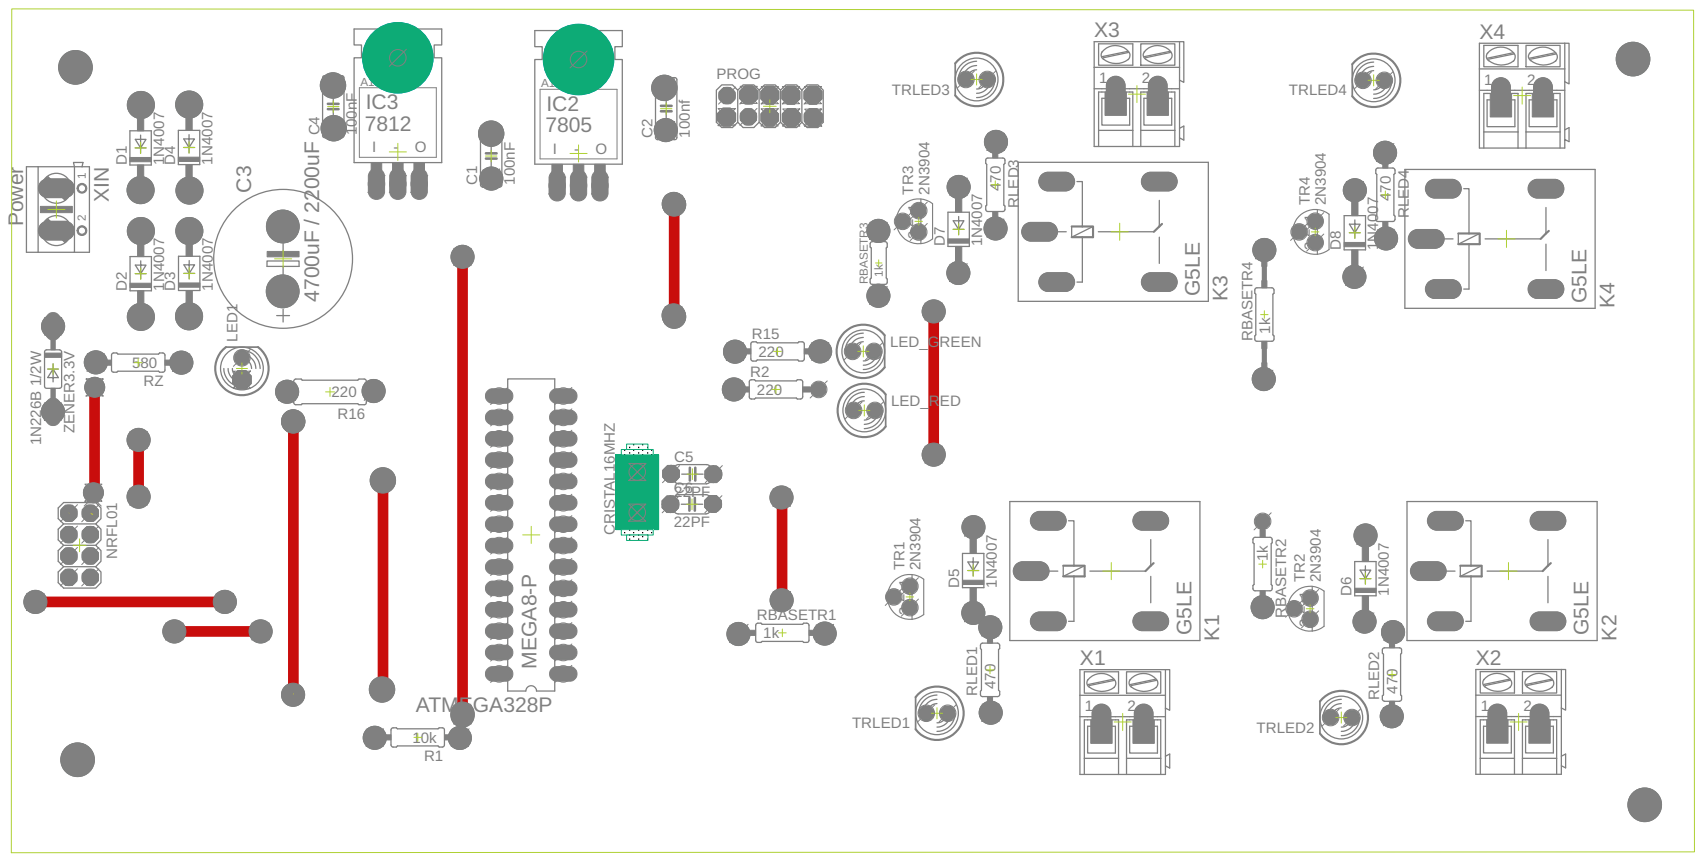
[picture p103: page 5]
