julian-zatloukal/SAPLM/PCBs/Placa mando de potencia/PDF Exportados/COMPONENTS.pdf

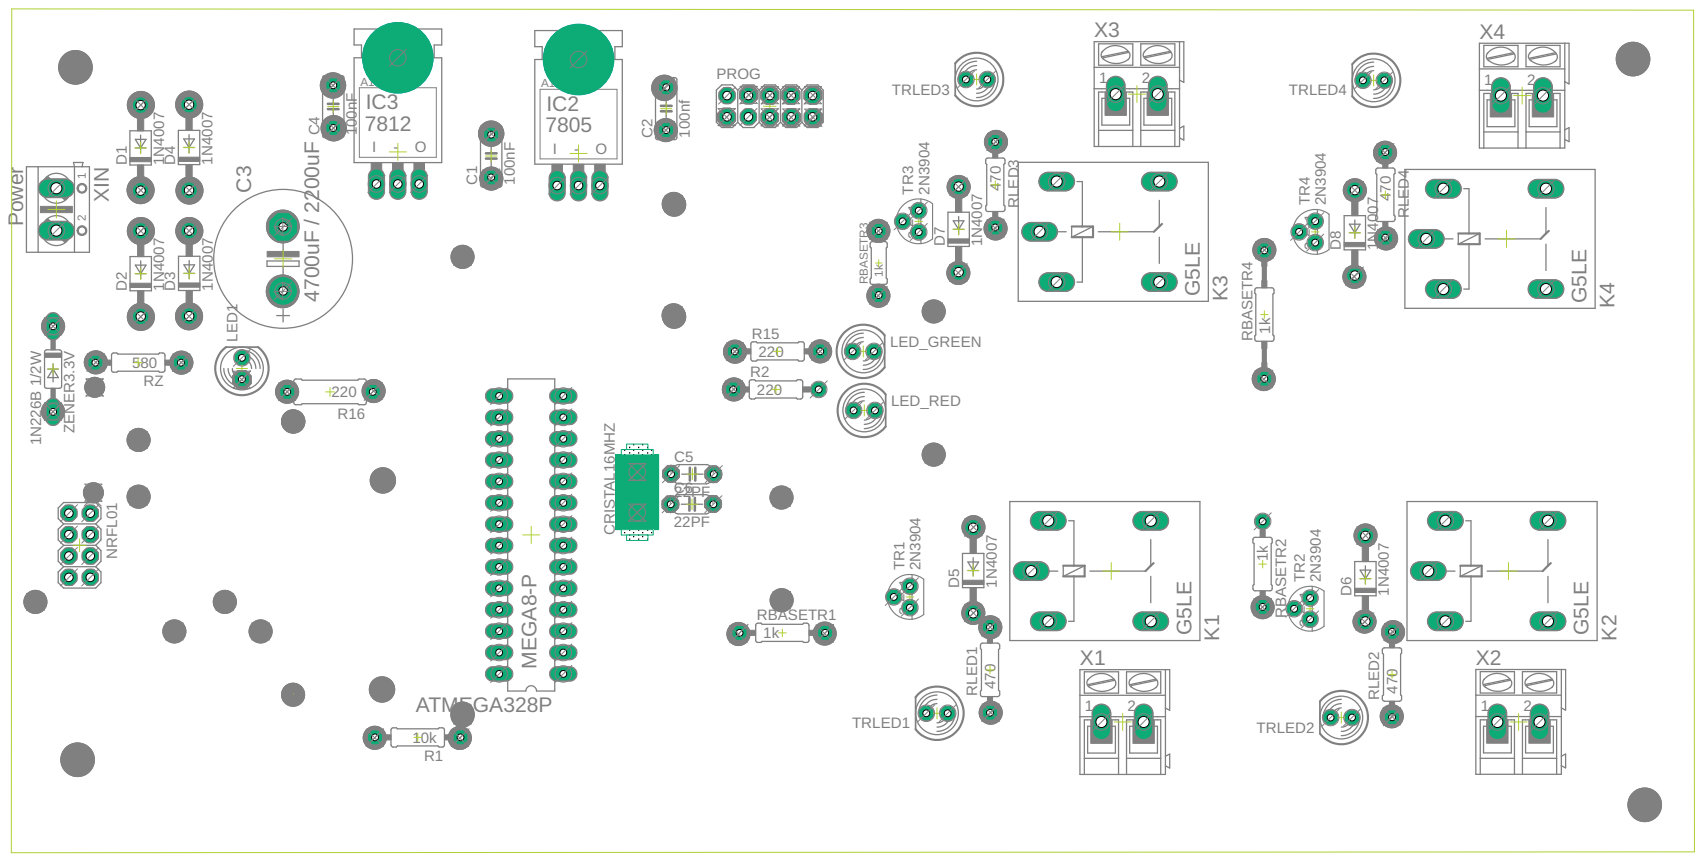
[picture p104: page 1]
