julian-zatloukal/SAPLM/PCBs/Placa mando de potencia/PDF Exportados/SCHEMATIC.pdf

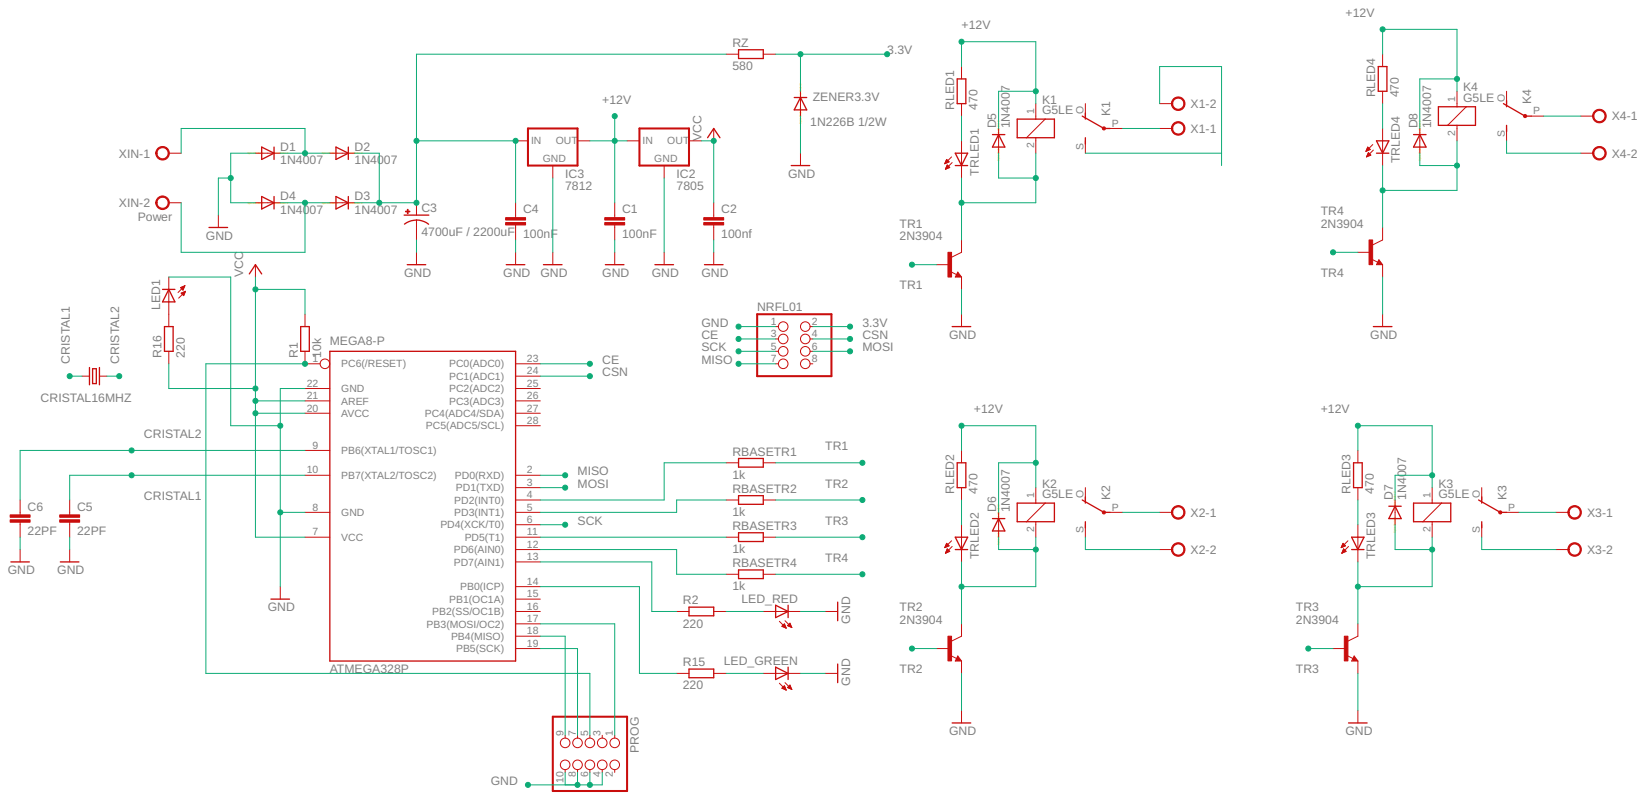
[picture p105: page 1]
