julian-zatloukal/SAPLM/(list of files, drawings)

Other design files:
Proyecto atmel studio/Archivos descontinuados/Codigo de fuente placa principa PRUEBA UART/Simulacion.pdsprj
Proyecto atmel studio/Archivos descontinuados/Protocolo de comunicacion descontinuado/Codigo de fuente placa principal/Simulacion.pdsprj
Proyecto atmel studio/Codigo de fuente placa principal/Simulacion.pdsprj
Proyecto atmel studio/Material/EEPROM example/simulacion.pdsprj
Proyecto atmel studio/Material/Miniaturas/Esquematico de ejemplo.pdsprj
