julian-zatloukal/SAPLM/PCBs/Placa mando de potencia/PCB Potencia descontinuados/placa.v2/Placa ATMEL 2019 v2.brd

## EAGLE design PCBs/Placa mando de potencia/PCB Potencia descontinuados/placa.v2/Placa ATMEL 2019 v2.brd (2021-03-22)

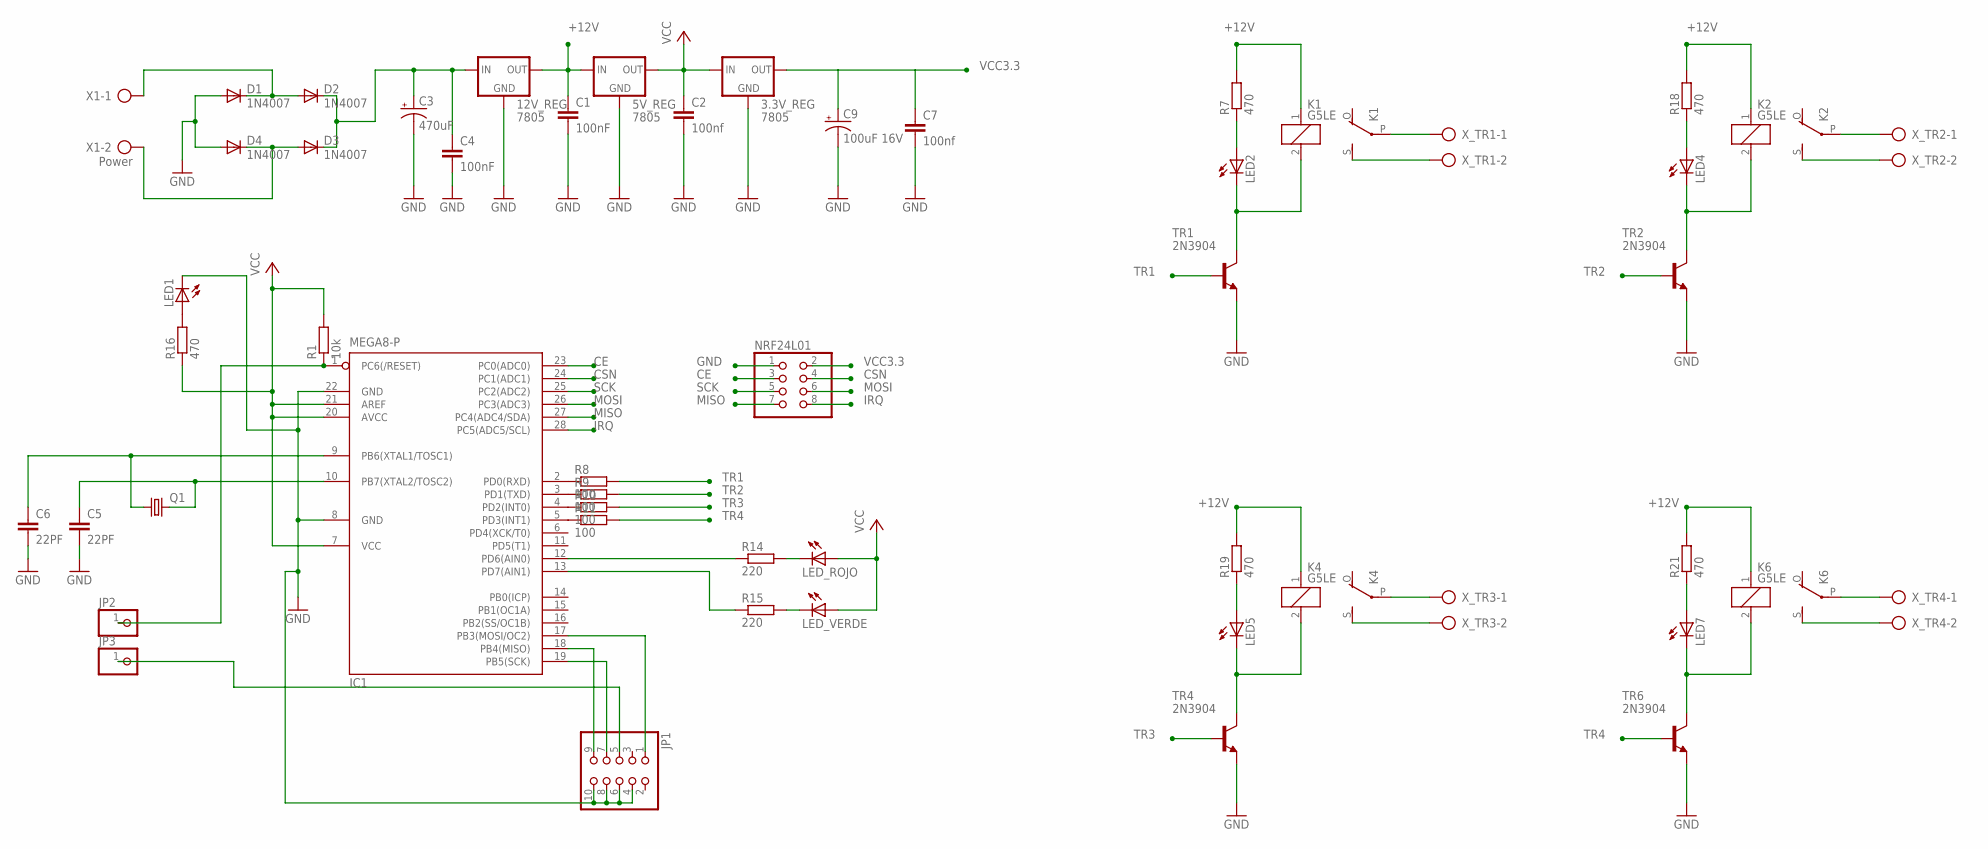
[picture p106: schematic Placa ATMEL 2019 v2.sch]

Parts:
3.3V_REG, 5V_REG, 12V_REG: 7805; 78XXL
C1, C4: 100nF; C050-025X075
C2, C7: 100nf; C050-025X075
C3: 470uF; E7,5-16
C5, C6: 22PF; C050-024X044
C9: 100uF 16V; E2,5-7
D1, D2, D3, D4: 1N4007; DO41-10
IC1: MEGA8-P; DIL28-3
JP1: PINHD-2X5; 2X05
JP2, JP3: PINHD-1X1; 1X01
K1, K2, K4, K6: G5LE
LED1, LED2, LED4, LED5, LED7: LED5MM
LED_ROJO: LED5MM
LED_VERDE: LED5MM
NRF24L01: PINHD-2X4; 2X04
Q1: CRYSTALHC49S; HC49/S
R1: 10k; 0207/10
R7, R16, R18, R19, R21: 470; 0309/10
R8, R9, R11: 100; 0207/10
R10: 100; 0207/15
R14, R15: 220; 0207/10
TR1, TR2, TR4, TR6: 2N3904; TO92
X1: Power; AK500/2
X_TR1, X_TR2, X_TR3, X_TR4: AK300/2

Connections:
+12V: 5V_REG.IN, 12V_REG.OUT, C1.1, K1.1, K2.1, K4.1, K6.1, R7.2, R18.2, R19.2, R21.2
CE: IC1.23 (PC0(ADC0)), NRF24L01.3
CSN: IC1.24 (PC1(ADC1)), NRF24L01.4
GND: 3.3V_REG.GND, 5V_REG.GND, 12V_REG.GND, C1.2, C2.2, C3.-, C4.2, C5.2, C6.2, C7.2, C9.-, D1.A, D4.A, IC1.8 (GND), IC1.22 (GND), JP1.4, JP1.6, JP1.8, JP1.10, LED1.K (C), NRF24L01.1, TR1.3 (E), TR2.3 (E), TR4.3 (E), TR6.3 (E)
IRQ: IC1.28 (PC5(ADC5/SCL)), NRF24L01.8
MISO: IC1.27 (PC4(ADC4/SDA)), NRF24L01.7
MOSI: IC1.26 (PC3(ADC3)), NRF24L01.6
unnamed: JP1.5, JP3.1
unnamed: 12V_REG.IN, C3.+, C4.1, D2.C, D3.C
unnamed: K4.S, X_TR3.2
unnamed: K1.S, X_TR1.2
unnamed: K2.S, X_TR2.2
unnamed: LED2.A, R7.1
unnamed: IC1.2 (PD0(RXD)), R8.1
unnamed: IC1.3 (PD1(TXD)), R9.1
unnamed: IC1.4 (PD2(INT0)), R10.1
unnamed: IC1.5 (PD3(INT1)), R11.1
unnamed: LED_ROJO.K (C), R14.2
unnamed: LED_VERDE.K (C), R15.2
unnamed: IC1.12 (PD6(AIN0)), R14.1
unnamed: IC1.13 (PD7(AIN1)), R15.1
unnamed: K6.S, X_TR4.2
unnamed: IC1.17 (PB3(MOSI/OC2)), JP1.1
unnamed: LED1.A, R16.2
unnamed: IC1.19 (PB5(SCK)), JP1.7
unnamed: IC1.18 (PB4(MISO)), JP1.9
unnamed: D1.C, D2.A, X1.1
unnamed: K1.2, LED2.K (C), TR1.1 (C)
unnamed: K1.P, X_TR1.1
unnamed: D3.A, D4.C, X1.2
unnamed: LED4.A, R18.1
unnamed: K2.2, LED4.K (C), TR2.1 (C)
unnamed: K2.P, X_TR2.1
unnamed: LED5.A, R19.1
unnamed: K4.2, LED5.K (C), TR4.1 (C)
unnamed: K4.P, X_TR3.1
unnamed: IC1.1 (PC6(/RESET)), JP2.1, R1.1
unnamed: LED7.A, R21.1
unnamed: C5.1, IC1.10 (PB7(XTAL2/TOSC2)), Q1.2
unnamed: C6.1, IC1.9 (PB6(XTAL1/TOSC1)), Q1.1
unnamed: K6.2, LED7.K (C), TR6.1 (C)
unnamed: K6.P, X_TR4.1
SCK: IC1.25 (PC2(ADC2)), NRF24L01.5
TR1: R8.2, TR1.2 (B)
TR2: R9.2, TR2.2 (B)
TR3: R10.2, TR4.2 (B)
TR4: R11.2, TR6.2 (B)
VCC: 3.3V_REG.IN, 5V_REG.OUT, C2.1, IC1.7 (VCC), IC1.20 (AVCC), IC1.21 (AREF), LED_ROJO.A, LED_VERDE.A, R1.2, R16.1
VCC3.3: 3.3V_REG.OUT, C7.1, C9.+, NRF24L01.2

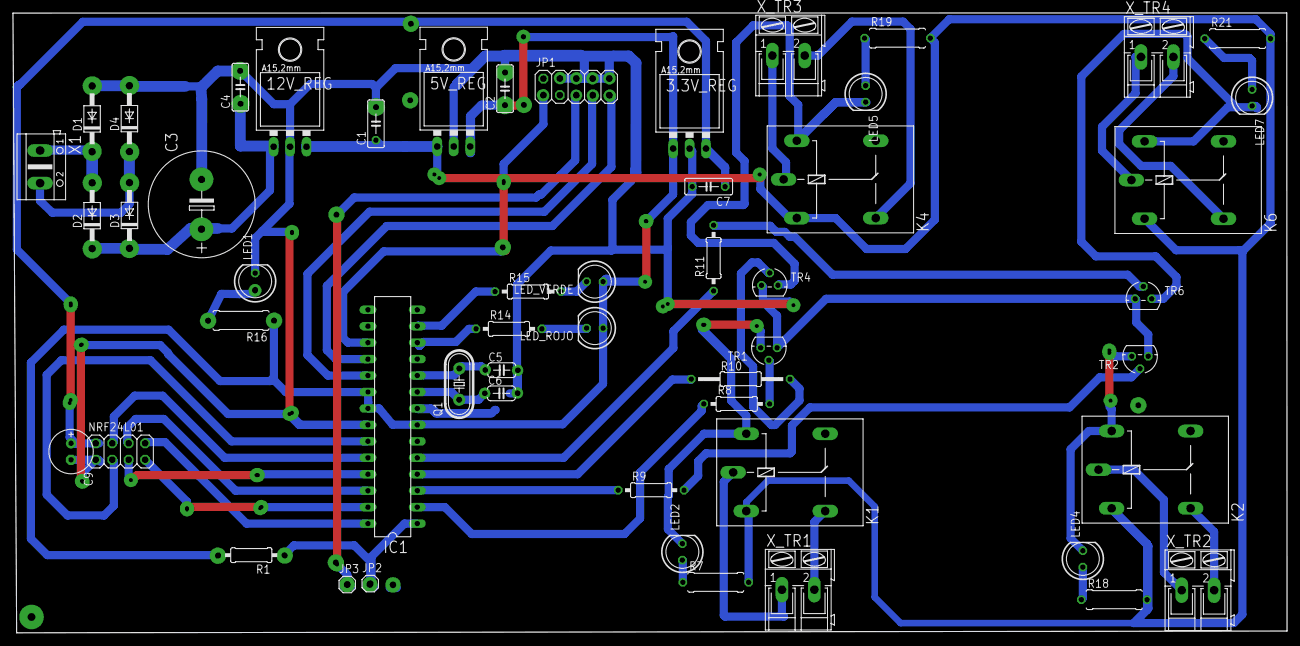
[picture p107: board Placa ATMEL 2019 v2.brd from above]

Board: 2 copper layers, 196.7 x 95.7 mm, 53 parts (0 on the bottom side), 49 nets.
