julian-zatloukal/SAPLM/PCBs/Placa principal/Placa principal.brd

## EAGLE design PCBs/Placa principal/Placa principal.brd (2021-03-22)

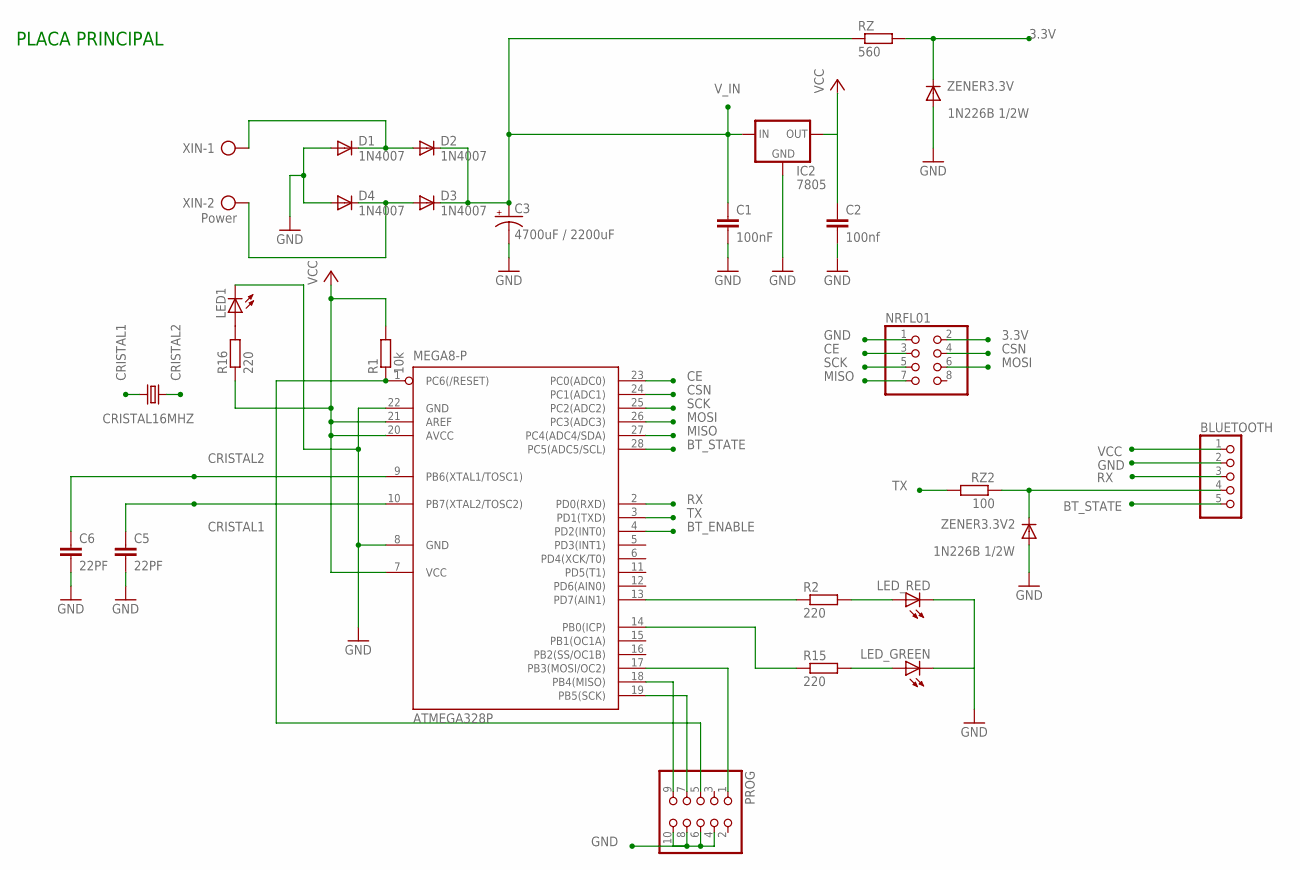
[picture p108: schematic Placa principal.sch]

Parts:
ATMEGA328P: MEGA8-P; DIL28-3
BLUETOOTH: PINHD-1X5; 1X05
C1: 100nF; C050-025X075
C2: 100nf; C050-025X075
C3: 4700uF / 2200uF; E7,5-16
C5, C6: 22PF; C050-024X044
CRISTAL16MHZ: CRYSTALHC49S; HC49/S
D1, D2, D3, D4: 1N4007; DO41-10
IC2: 7805; 78XXL
LED1: LED5MM
LED_GREEN: LED5MM
LED_RED: LED5MM
NRFL01: PINHD-2X4; 2X04
PROG: PINHD-2X5; 2X05
R1: 10k; 0207/10
R2, R15: 220; 0207/10
R16: 220; 0309/10
RZ: 560; 0207/10
RZ2: 100; 0207/10
XIN: Power; AK500/2
ZENER3.3V, ZENER3.3V2: 1N226B 1/2W; DO35-10

Connections:
3.3V: NRFL01.2, RZ.2, ZENER3.3V.C
BT_ENABLE: ATMEGA328P.4 (PD2(INT0))
BT_STATE: ATMEGA328P.28 (PC5(ADC5/SCL)), BLUETOOTH.5
CE: ATMEGA328P.23 (PC0(ADC0)), NRFL01.3
CRISTAL1: ATMEGA328P.10 (PB7(XTAL2/TOSC2)), C5.1, CRISTAL16MHZ.2
CRISTAL2: ATMEGA328P.9 (PB6(XTAL1/TOSC1)), C6.1, CRISTAL16MHZ.1
CSN: ATMEGA328P.24 (PC1(ADC1)), NRFL01.4
GND: ATMEGA328P.8 (GND), ATMEGA328P.22 (GND), BLUETOOTH.2, C1.2, C2.2, C3.-, C5.2, C6.2, D1.A, D4.A, IC2.GND, LED1.K (C), LED_GREEN.K (C), LED_RED.K (C), NRFL01.1, PROG.4, PROG.6, PROG.8, PROG.10, ZENER3.3V.A, ZENER3.3V2.A
MISO: ATMEGA328P.27 (PC4(ADC4/SDA)), NRFL01.7
MOSI: ATMEGA328P.26 (PC3(ADC3)), NRFL01.6
unnamed: ATMEGA328P.1 (PC6(/RESET)), PROG.5, R1.1
unnamed: LED_RED.A, R2.2
unnamed: ATMEGA328P.14 (PB0(ICP)), R15.1
unnamed: ATMEGA328P.13 (PD7(AIN1)), R2.1
unnamed: ATMEGA328P.17 (PB3(MOSI/OC2)), PROG.1
unnamed: LED1.A, R16.2
unnamed: ATMEGA328P.19 (PB5(SCK)), PROG.7
unnamed: ATMEGA328P.18 (PB4(MISO)), PROG.9
unnamed: D1.C, D2.A, XIN.1
unnamed: BLUETOOTH.4, RZ2.1, ZENER3.3V2.C
unnamed: D3.A, D4.C, XIN.2
unnamed: LED_GREEN.A, R15.2
RX: ATMEGA328P.2 (PD0(RXD)), BLUETOOTH.3
SCK: ATMEGA328P.25 (PC2(ADC2)), NRFL01.5
TX: ATMEGA328P.3 (PD1(TXD)), RZ2.2
VCC: ATMEGA328P.7 (VCC), ATMEGA328P.20 (AVCC), ATMEGA328P.21 (AREF), BLUETOOTH.1, C2.1, IC2.OUT, R1.2, R16.1
V_IN: C1.1, C3.+, D2.C, D3.C, IC2.IN, RZ.1

Notes on the sheet:
PLACA PRINCIPAL

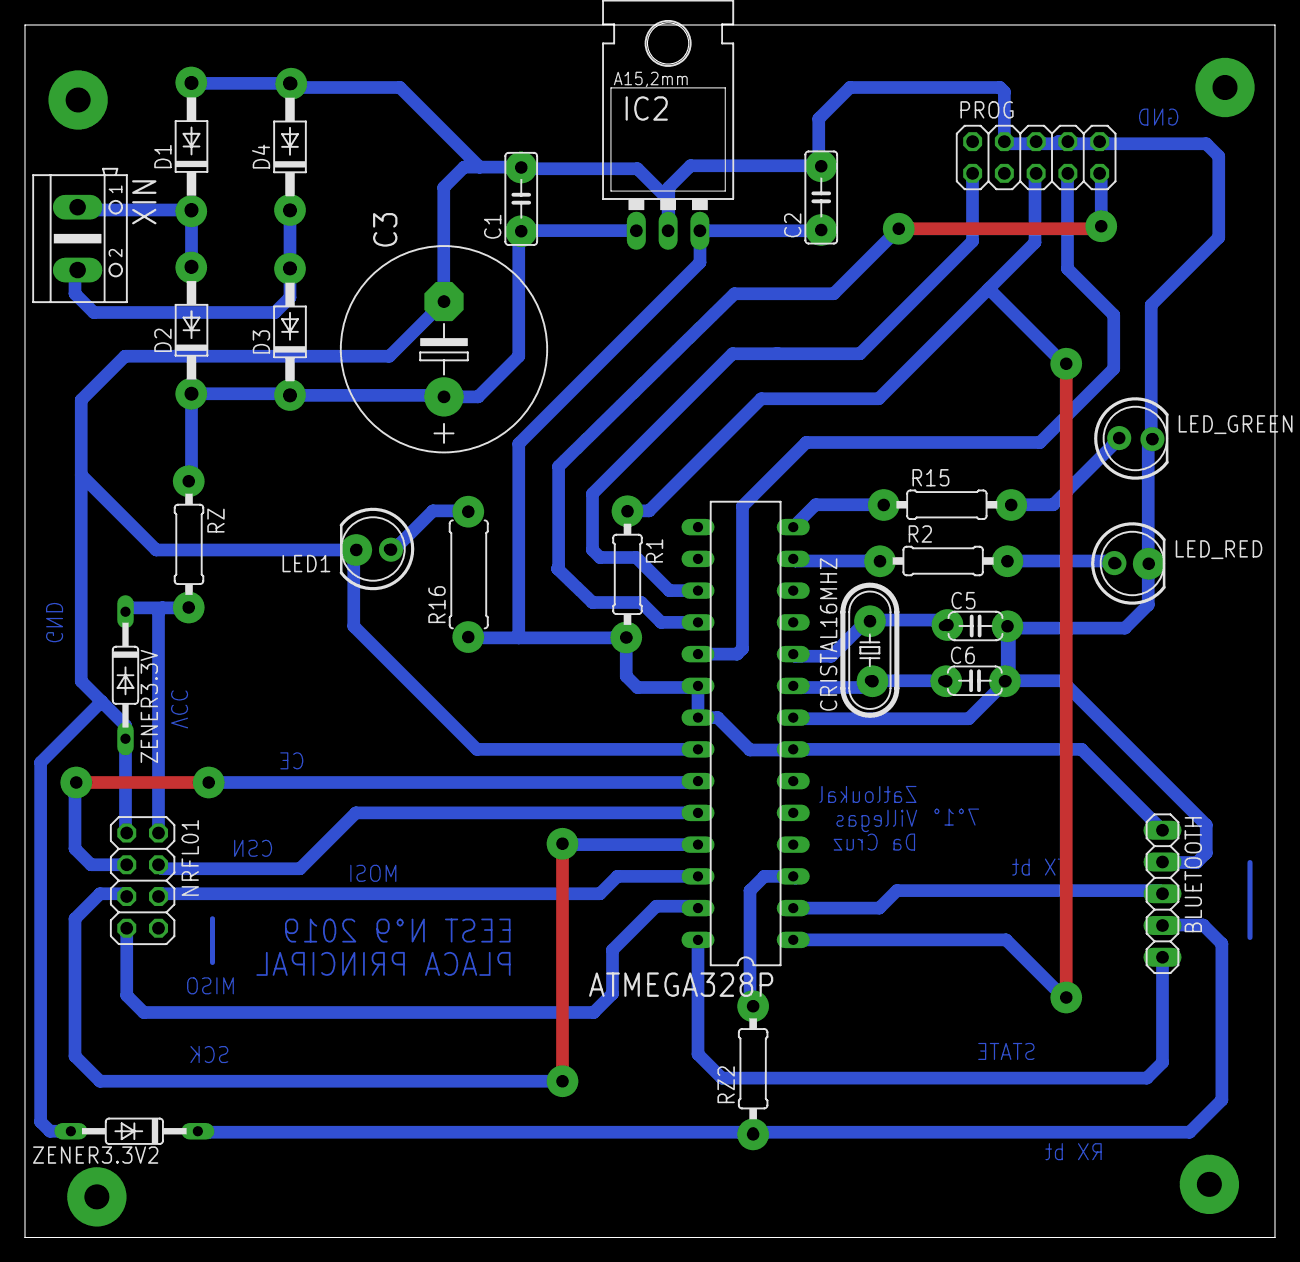
[picture p109: board Placa principal.brd from above]

Board: 2 copper layers, 100.0 x 97.0 mm, 27 parts (0 on the bottom side), 26 nets.
