julian-zatloukal/SAPLM/PCBs/Placa mando de potencia/PCB Potencia descontinuados/Placa ATMEL 2019 v2.3.brd

## EAGLE design PCBs/Placa mando de potencia/PCB Potencia descontinuados/Placa ATMEL 2019 v2.3.brd (2021-03-22, an earlier design)

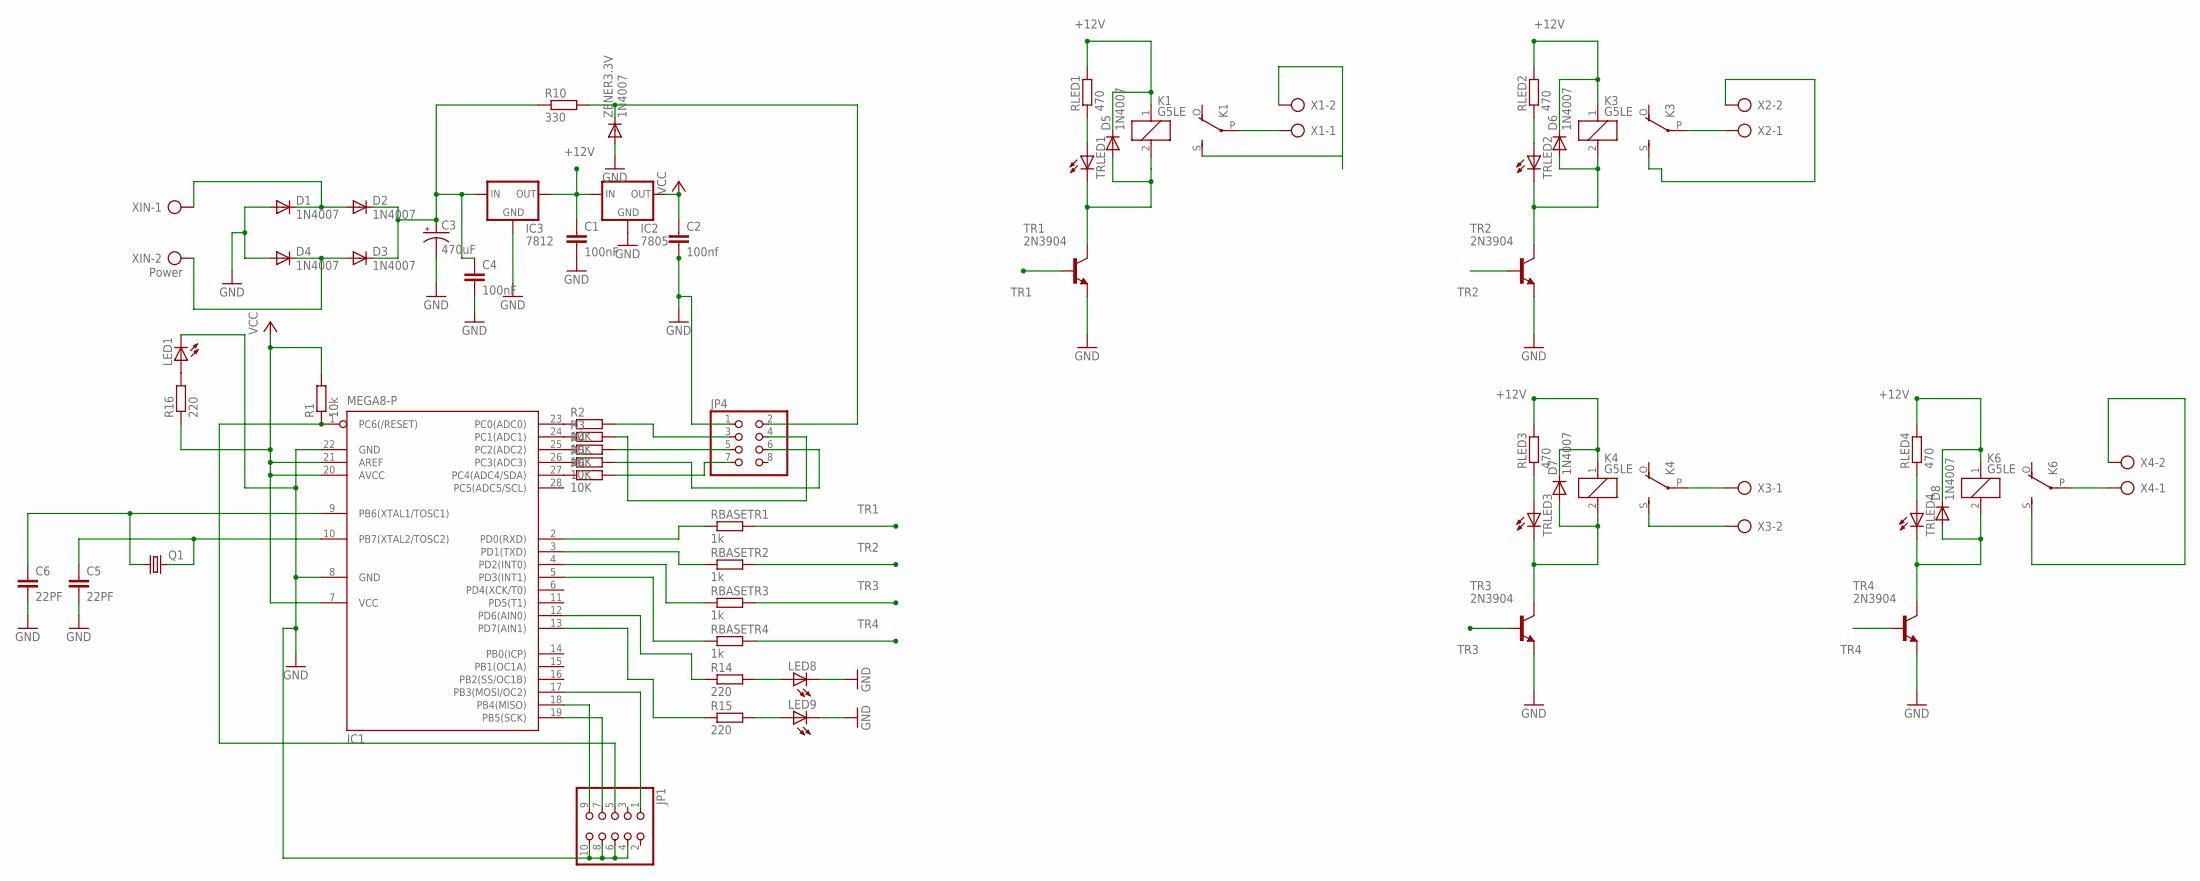
[picture p110: schematic Placa ATMEL 2019 v2.3.sch]

Parts:
C1, C4: 100nF; C050-025X075
C2: 100nf; C050-025X075
C3: 470uF; E7,5-16
C5, C6: 22PF; C050-024X044
D1, D2, D3, D4, D5, D6, D7, D8: 1N4007; DO41-10
IC1: MEGA8-P; DIL28-3
IC2: 7805; 78XXL
IC3: 7812; 78XXL
JP1: PINHD-2X5; 2X05
JP4: PINHD-2X4; 2X04
K1, K3, K4, K6: G5LE
LED1, LED8, LED9: LED5MM
Q1: CRYSTALHC49S; HC49/S
R1: 10k; 0207/10
R2, R3, R4, R5, R6: 10K; 0207/10
R10: 330; 0207/10
R14, R15: 220; 0207/10
R16: 220; 0309/10
RBASETR1, RBASETR2: 1k; 0207/10
RBASETR3: 1k; 0204/7
RBASETR4: 1k; 0207/15
RLED1, RLED2, RLED3, RLED4: 470; 0207/10
TR1, TR2, TR3, TR4: 2N3904; TO92
TRLED1, TRLED2, TRLED3, TRLED4: LED5MM
X1, X2, X3, X4: AK300/2
XIN: Power; AK500/2
ZENER3.3V: 1N4007; DO35-10

Connections:
+12V: C1.1, D5.C, D6.C, D7.C, D8.C, IC2.IN, IC3.OUT, K1.1, K3.1, K4.1, K6.1, RLED1.2, RLED2.2, RLED3.2, RLED4.2
GND: C1.2, C2.2, C3.-, C4.2, C5.2, C6.2, D1.A, D4.A, IC1.8 (GND), IC1.22 (GND), IC2.GND, IC3.GND, JP1.4, JP1.6, JP1.8, JP1.10, JP4.1, LED1.K (C), LED8.K (C), LED9.K (C), TR1.3 (E), TR2.3 (E), TR3.3 (E), TR4.3 (E), ZENER3.3V.A
unnamed: IC1.1 (PC6(/RESET)), JP1.5, R1.1
unnamed: IC1.23 (PC0(ADC0)), R2.1
unnamed: IC1.24 (PC1(ADC1)), R3.1
unnamed: IC1.25 (PC2(ADC2)), R4.1
unnamed: IC1.27 (PC4(ADC4/SDA)), R6.1
unnamed: RLED1.1, TRLED1.A
unnamed: IC1.2 (PD0(RXD)), RBASETR1.1
unnamed: IC1.3 (PD1(TXD)), RBASETR2.1
unnamed: JP4.2, R10.2, ZENER3.3V.C
unnamed: IC1.4 (PD2(INT0)), RBASETR3.1
unnamed: IC1.5 (PD3(INT1)), RBASETR4.1
unnamed: IC1.12 (PD6(AIN0)), R14.1
unnamed: IC1.13 (PD7(AIN1)), R15.1
unnamed: IC1.26 (PC3(ADC3)), R5.1
unnamed: IC1.17 (PB3(MOSI/OC2)), JP1.1
unnamed: LED1.A, R16.2
unnamed: IC1.19 (PB5(SCK)), JP1.7
unnamed: IC1.18 (PB4(MISO)), JP1.9
unnamed: JP4.3, R2.2
unnamed: JP4.4, R3.2
unnamed: C3.+, C4.1, D2.C, D3.C, IC3.IN, R10.1
unnamed: D1.C, D2.A, XIN.1
unnamed: JP4.5, R4.2
unnamed: JP4.6, R5.2
unnamed: JP4.7, R6.2
unnamed: D5.A, K1.2, TR1.1 (C), TRLED1.K (C)
unnamed: K1.S, X1.2
unnamed: K1.P, X1.1
unnamed: D3.A, D4.C, XIN.2
unnamed: RLED2.1, TRLED2.A
unnamed: D6.A, K3.2, TR2.1 (C), TRLED2.K (C)
unnamed: K3.S, X2.2
unnamed: K3.P, X2.1
unnamed: RLED3.1, TRLED3.A
unnamed: D7.A, K4.2, TR3.1 (C), TRLED3.K (C)
unnamed: K4.S, X3.2
unnamed: K4.P, X3.1
unnamed: RLED4.1, TRLED4.A
unnamed: C5.1, IC1.10 (PB7(XTAL2/TOSC2)), Q1.2
unnamed: C6.1, IC1.9 (PB6(XTAL1/TOSC1)), Q1.1
unnamed: D8.A, K6.2, TR4.1 (C), TRLED4.K (C)
unnamed: K6.S, X4.2
unnamed: K6.P, X4.1
unnamed: LED8.A, R14.2
unnamed: LED9.A, R15.2
TR1: RBASETR1.2, TR1.2 (B)
TR2: RBASETR2.2, TR2.2 (B)
TR3: RBASETR3.2, TR3.2 (B)
TR4: RBASETR4.2, TR4.2 (B)
VCC: C2.1, IC1.7 (VCC), IC1.20 (AVCC), IC1.21 (AREF), IC2.OUT, R1.2, R16.1

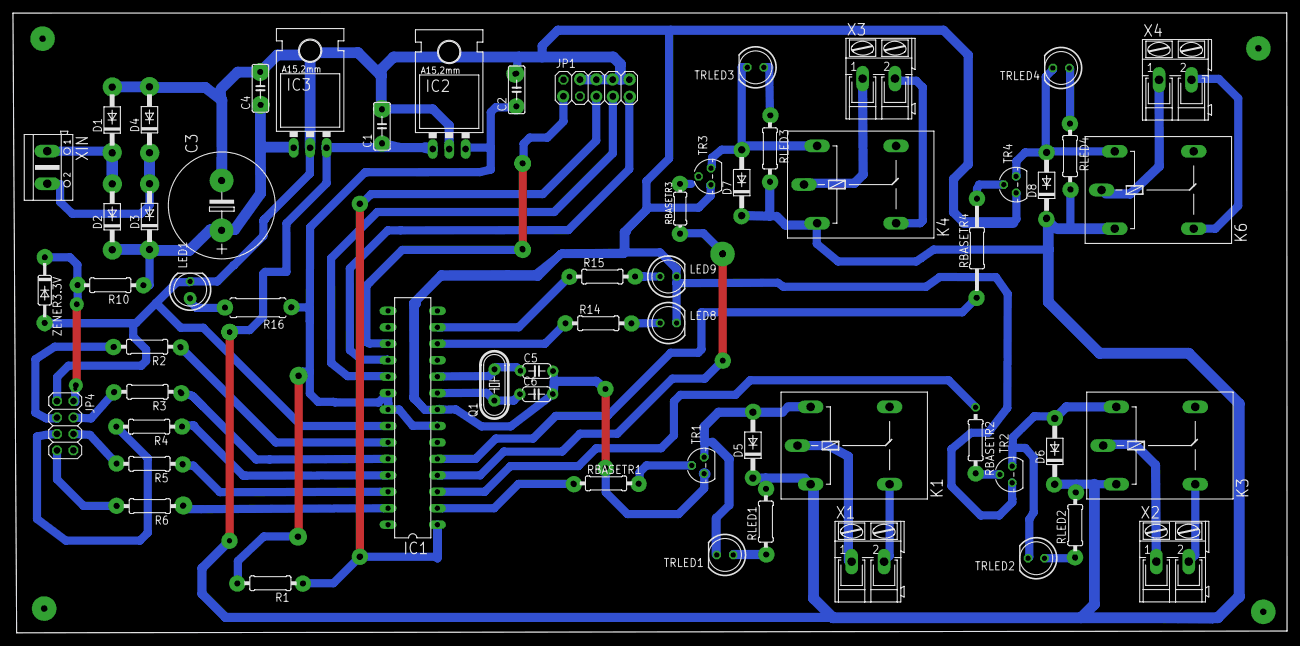
[picture p111: board Placa ATMEL 2019 v2.3.brd from above]

Board: 2 copper layers, 196.7 x 95.7 mm, 59 parts (0 on the bottom side), 52 nets.
